Mert-Eren-Karabulut/ECW7220-HardwareInfo/Hardware/BOM/ECW7220BOM.xls

quantity | descrip | location | vendor_no | vendor_partno
0 | R01 SCHEMATIC FILE EAP1028B-FLF-ZZ
0 | R01 SCHEMATIC FILE EAP1028B-FLF-ZZ 5G MODULE
0 | R02 SCHEMATIC FILE EAP1028B-FLF-ZZ 2G MODULE
1 | *??CONFIG EAP1028B-0316-EC
1 | ANT-1 2.4GHz PCB+CABLE MHF 5dBi RED 35.1X8.1+105mm LYNWAVE |  | LYNWAVE TECHNOLOGY LTD | ALA130-051023-105035
1 | ANT-2 2.4GHz PCB+CABLE MHF 5dBi ORG 35.1X8.1+110mm LYNWAVE |  | LYNWAVE TECHNOLOGY LTD | ALA130-051023-110037
1 | ANT-3 2.4GHz PCB+CABLE MHF 4dBi BLACK 35.1X8.1+220mm LYNWAVE |  | LYNWAVE TECHNOLOGY LTD | ALA130-051023-220030
1 | ANT-6 5GHz PCB+CABLE MHF 5dBi BLUE 22.6X6+90mm 1.37 LYNWAVE |  | LYNWAVE TECHNOLOGY LTD | ALA120-091025-090033
1 | ANT-5 5GHz PCB+CABLE MHF 5.77dBi GREEN 22.6X6+100mm LYNWAVE |  | LYNWAVE TECHNOLOGY LTD | ALA120-091025-100038
1 | ANT-4 5GHz PCB+CABLE MHF 5.72dBi GRAY 22.6X6+225mm LYNWAVE |  | LYNWAVE TECHNOLOGY LTD | ALA120-091025-225031
1 | R02 PLASTIC BASE EAP1028B-12-0115-38 LT |  | TUNG SHI | PLASTIC BASE 200X200X26.8mm
1 | R02 PLASTIC BASE EAP1028B-12-0115-38 LT |  | TUNG SHI | PLASTIC BASE 200X200X26.8mm
1 | R02 PLASTIC COVER EAP1028B-FLF-ZZ LT |  | TUNG SHI | PLASTIC COVER 200X200X18mm
1 | R01 HEAT SINK PCB 160X110X6.0mm EAP1028B-25-0714-EC LT |  | TIMSON | HEAT SINK PCB 160X110X6.0mm
1 | R01 HEAT SINK COVER Φ100Xt2.0mm EAP1028B-25-0714-EC LT |  | TIMSON | HEAT-SINK-COVER Φ100Xt2.0mm
1 | R01 HEAT SINK SHIELDING 75X37X4mm EAP1028B-25-0714-EC LT |  | TIMSON | HEAT SINK SHIELDING 75X37X4mm
6 | R01 SCREW FHMS+N M3X5-D5 LT |  | BIFU/QUANYING | FHMS+N M3X5-D5
6 | R01 SCREW FHMS+N M3X5-D5 LT |  | TUNG SHING SCREW MANUFACTURING CO., | FHMS+N M3X5-D5
6 | R01 SCREW FHMS+N M3X5-D5 LT |  | BIFU/QUANYING | FHMS+N M3X5-D5
6 | R01 SCREW FHMS+N M3X5-D5 LT |  | TUNG SHING SCREW MANUFACTURING CO., | FHMS+N M3X5-D5
6 | R01 SCREW FHMS+N M3X5-D5 LT |  | BIFU/QUANYING | FHMS+N M3X5-D5
6 | R01 SCREW FHMS+N M3X5-D5 LT |  | TUNG SHING SCREW MANUFACTURING CO., | FHMS+N M3X5-D5
6 | R01 SCREW FHMS+N M3X5-D5 LT |  | BIFU/QUANYING | FHMS+N M3X5-D5
6 | R01 SCREW FHMS+N M3X5-D5 LT |  | TUNG SHING SCREW MANUFACTURING CO., | FHMS+N M3X5-D5
6 | R01 SCREW FHMS+N M3X5-D5 LT |  | BIFU/QUANYING | FHMS+N M3X5-D5
6 | R01 SCREW FHMS+N M3X5-D5 LT |  | TUNG SHING SCREW MANUFACTURING CO., | FHMS+N M3X5-D5
6 | R01 SCREW FHMS+N M3X5-D5 LT |  | BIFU/QUANYING | FHMS+N M3X5-D5
6 | R01 SCREW FHMS+N M3X5-D5 LT |  | TUNG SHING SCREW MANUFACTURING CO., | FHMS+N M3X5-D5
6 | R01 SCREW FHMS+N M3X5-D5 LT |  | BIFU/QUANYING | FHMS+N M3X5-D5
6 | R01 SCREW FHMS+N M3X5-D5 LT |  | TUNG SHING SCREW MANUFACTURING CO., | FHMS+N M3X5-D5
4 | R02 SCREW PH MS NI NYLOK M2.5X4mm EAP1018FA-FLF-09J E LT |  | BIFU/QUANYING | PH MS NICKEL M2.5X4mm
4 | R02 SCREW PH MS NI NYLOK M2.5X4mm EAP1018FA-FLF-09J E LT |  | BIFU/QUANYING | PH MS NICKEL M2.5X4mm
5 | R01 pH MST+FS⊕CN 3X8-D7 LT |  | BIFU/QUANYING | PH MST+FS+CN 3*8-D7
5 | R01 pH MST+FS⊕CN 3X8-D7 LT |  | Screwtek | PH MST+FS+CN 3*8-D7
5 | R01 pH MST+FS⊕CN 3X8-D7 LT |  | BIFU/QUANYING | PH MST+FS+CN 3*8-D7
5 | R01 pH MST+FS⊕CN 3X8-D7 LT |  | Screwtek | PH MST+FS+CN 3*8-D7
5 | R01 pH MST+FS⊕CN 3X8-D7 LT |  | BIFU/QUANYING | PH MST+FS+CN 3*8-D7
5 | R01 pH MST+FS⊕CN 3X8-D7 LT |  | Screwtek | PH MST+FS+CN 3*8-D7
2 | R01 WIRE SADDLE CHF-4A-NQW EAP9112A-FLF-17(WAP5110-E) LT |  | PINGOOD | CHF-4A-NQW
1 | R01 THERMAL PAD TG6050 80X40X2.0mm EAP1028B-25-0714-EC LT |  | T-GLOBAL TECHNOLOGY CO., LTD | TG6050-800400020-0-1
1 | R01 THERMAL PAD TG2030 80X40X2.0mm EAP1028B-12-0115-38 LT |  | T-GLOBAL TECHNOLOGY CO., LTD | TG2030-800400020-0-1
2 | R01 THERMAL PAD H48-6 25.8X21.6X3.5mm EAP1028B-25-0714-EC LT |  | T-GLOBAL TECHNOLOGY CO., LTD | H48-6-25802160350-0-1
1 | R01 THERMAL PAD H48-6 40X33.0X2.8mm EAP1028B-25-0714-EC LT |  | T-GLOBAL TECHNOLOGY CO., LTD | H48-6-400330280-0-1
1 | R01 THERMAL PAD H48-6 25X20X4.5mm EAP1028B-25-0714-EC LT |  | T-GLOBAL TECHNOLOGY CO., LTD | H48-6-250200450-0-1
1 | R01 THERMAL PAD H48-6 29X28X2.8mm EAP1028B-25-0714-EC LT |  | T-GLOBAL TECHNOLOGY CO., LTD | H48-6-290280280-0-1
2 | R01 SPONG 27X13X3mm EAP1028B-FLF-ZZ LT |  | NEO-APEX \ EASTERN PIONEER | SPONG 27X13X3mm
0 | RNA TEST PROGRAM EAP1028B-0316-EC
1 | R01 ACCLABEL 51X13MM(珍珠朧) LT |  | TRIM | 51*13MM R01
1 | R01 ACCLABEL 51X13MM(珍珠朧) LT |  | TRIM | 51*13MM R01
1 | PCBA EAP1028B-12-0115-38 2G MODULE
1 | SMD ASM EAP1028B-12-0115-38 2G MODULE
1 | IND PWR SHD 1uH 20% 1MHz 2.2A 0.1365ohm 2.5X2 MAGIC | L4 | MAGIC | WQPIG2512L-1R0M
1 | IND PWR SHD 1uH 20% 1MHz 2.2A 0.1365ohm 2.5X2 MAGIC | L4 | MAGIC | WQPIG2512L-1R0M
3 | *RF IC SE2594L-R PA 3.3V QFN32 SIGE | U10, U11, U12 | SKYWORKS | SE2594L-R
3 | *RF IC SE2594L-R PA 3.3V QFN32 SIGE | U10, U11, U12 | SKYWORKS | SE2594L-R
3 | *RF IC SE2594L-R PA 3.3V QFN32 SIGE | U10, U11, U12 | SKYWORKS | SE2594L-R
3 | *RF IC SE2594L-R PA 3.3V QFN32 SIGE | U10, U11, U12 | SKYWORKS | SE2594L-R
3 | *RF IC SE2594L-R PA 3.3V QFN32 SIGE | U10, U11, U12 | SKYWORKS | SE2594L-R
3 | *RF IC SE2594L-R PA 3.3V QFN32 SIGE | U10, U11, U12 | SKYWORKS | SE2594L-R
3 | *RF IC SE2594L-R PA 3.3V QFN32 SIGE | U10, U11, U12 | SKYWORKS | SE2594L-R
1 | RF IC BCM43431KMLG 1.2V QFN100 BROADCOM(ZZ) | U1 | BROADCOM | BCM43431KMLG
1 | RF IC BCM43431KMLG 1.2V QFN100 BROADCOM(ZZ) | U1 | BROADCOM | BCM43431KMLG
1 | RF IC BCM43431KMLG 1.2V QFN100 BROADCOM(ZZ) | U1 | BROADCOM | BCM43431KMLG
1 | RF IC BCM43431KMLG 1.2V QFN100 BROADCOM(ZZ) | U1 | BROADCOM | BCM43431KMLG
1 | X'TAL 20MHz +-7ppm 16pF 35ohm SMD3.2X2.5mm TXC | Y1 | TXC CORPORATION | 7M20070002
1 | X'TAL 20MHz +-7ppm 16pF 35ohm SMD3.2X2.5mm TXC | Y1 | TXC CORPORATION | 7M20070002
1 | REG SYNC BUCK MP2130DG-LF-Z ADJ 3.5A QFN12 MPS | U14 | MPS | MP2130DG-LF-Z
3 | CONN RF RP U.FL-JACK H1.25 180F 50ohm 6GHz 5u SMD3 SPECON | J0, J1, J2 | SPECON ELECRTONICS INC | W08-5801-002-00-810
3 | CONN RF U.FL H1.25 180M 50ohm 6GHz SMD3 HRS | J0, J1, J2 | HIROSE | U.FL-R-SMT-1(10)
3 | CONN RF U.FL H1.25 180M 50ohm 6GHz SMD3 HRS | J0, J1, J2 | HIROSE | U.FL-R-SMT-1(10)
3 | CONN RF U.FL H1.25 180M 50ohm 6GHz SMD3 HRS | J0, J1, J2 | HIROSE | U.FL-R-SMT-1(10)
3 | CONN RF U.FL H1.25 180M 50ohm 6GHz SMD3 HRS | J0, J1, J2 | HIROSE | U.FL-R-SMT-1(10)
3 | CONN RF U.FL H1.25 180M 50ohm 6GHz SMD3 HRS | J0, J1, J2 | HIROSE | U.FL-R-SMT-1(10)
3 | CONN RF U.FL H1.25 180M 50ohm 6GHz SMD3 HRS | J0, J1, J2 | HIROSE | U.FL-R-SMT-1(10)
3 | CONN RF U.FL H1.25 180M 50ohm 6GHz SMD3 HRS | J0, J1, J2 | HIROSE | U.FL-R-SMT-1(10)
3 | CONN RF U.FL H1.25 180M 50ohm 6GHz SMD3 HRS | J0, J1, J2 | HIROSE | U.FL-R-SMT-1(10)
3 | CONN RF U.FL H1.25 180M 50ohm 6GHz SMD3 HRS | J0, J1, J2 | HIROSE | U.FL-R-SMT-1(10)
3 | CONN RF U.FL H1.25 180M 50ohm 6GHz SMD3 HRS | J0, J1, J2 | HIROSE | U.FL-R-SMT-1(10)
1 | R01 SHIELD FRAME 2.4G 27.75X29.08X2.1mm EAP1018FB-FLF-MK LT | X1 | CHI GI | SHIELD FRAME 2.4G 27.75X29.08X2.1mm
1 | R01 SHIELD FRAME 2.4G 27.75X29.08X2.1mm EAP1018FB-FLF-MK LT | X1 | CHI GI | SHIELD FRAME 2.4G 27.75X29.08X2.1mm
1 | R01 SHIELD FRAME 2.4G 27.75X29.08X2.1mm EAP1018FB-FLF-MK LT | X1 | CHI GI | SHIELD FRAME 2.4G 27.75X29.08X2.1mm
1 | R01 SHIELD FRAME 2.4G 27.75X29.08X2.1mm EAP1018FB-FLF-MK LT | X1 | CHI GI | SHIELD FRAME 2.4G 27.75X29.08X2.1mm
1 | R02 PCB 4L EAP1028B-FLF-ZZ 2G MODULE |  | HI TEC | 142000000969A
1 | R02 PCB 4L EAP1028B-FLF-ZZ 2G MODULE |  | HI TEC | 142000000969A
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
1 | RES SMD 221ohm 1% 1/20W 200ppm/℃ 0201 | R12 | WAL SIN | WR02X2210FAL
1 | RES SMD 221ohm 1% 1/20W 200ppm/℃ 0201 | R12 | YAGEO | RC0201FR-07221RL
1 | RES SMD 15Kohm 1% 1/20W 200ppm/℃ 0201 | R50 | WAL SIN | WR02X1502FAL
1 | RES SMD 15Kohm 1% 1/20W 200ppm/℃ 0201 | R50 | YAGEO | RC0201FR-0715KL
1 | RES SMD 15Kohm 1% 1/20W 200ppm/℃ 0201 | R50 | WAL SIN | WR02X1502FAL
1 | RES SMD 15Kohm 1% 1/20W 200ppm/℃ 0201 | R50 | YAGEO | RC0201FR-0715KL
1 | RES SMD 15Kohm 1% 1/20W 200ppm/℃ 0201 | R50 | WAL SIN | WR02X1502FAL
1 | RES SMD 15Kohm 1% 1/20W 200ppm/℃ 0201 | R50 | YAGEO | RC0201FR-0715KL
1 | RES SMD 196Kohm 1% 1/20W 200ppm/℃ 0201 | R119 | WAL SIN | WR02X1963FAL
1 | RES SMD 196Kohm 1% 1/20W 200ppm/℃ 0201 | R119 | YAGEO | RC0201FR-07196KL
1 | RES SMD 196Kohm 1% 1/20W 200ppm/℃ 0201 | R119 | WAL SIN | WR02X1963FAL
1 | RES SMD 196Kohm 1% 1/20W 200ppm/℃ 0201 | R119 | YAGEO | RC0201FR-07196KL
1 | C SMD CER 3300pF 10% 6.3V X7R 0201 T0.3mm | C146 | WAL SIN | 0201B332K6R3CT
1 | C SMD CER 3300pF 10% 6.3V X7R 0201 T0.3mm | C146 | YAGEO | CC0201KRX7R5BB332
1 | C SMD CER 3300pF 10% 6.3V X7R 0201 T0.3mm | C146 | WAL SIN | 0201B332K6R3CT
1 | C SMD CER 3300pF 10% 6.3V X7R 0201 T0.3mm | C146 | YAGEO | CC0201KRX7R5BB332
3 | C SMD CER 0.068uF 10% 6.3V X5R 0201 T0.3mm | C222, C223, C224 | WAL SIN | 0201X683K6R3CT
3 | C SMD CER 0.068uF 10% 6.3V X5R 0201 T0.3mm | C222, C223, C224 | YAGEO | CC0201KRX5R5BB683
3 | C SMD CER 180pF 10% 16V X7R 0201 T0.3mm LT/LF | C211, C212, C213 | WAL SIN | 0201B181K160CT
3 | C SMD CER 180pF 10% 16V X7R 0201 T0.3mm LT/LF | C211, C212, C213 | YAGEO | CC0201KRX7R7BB181
3 | C SMD CER 180pF 10% 16V X7R 0201 T0.3mm LT/LF | C211, C212, C213 | WAL SIN | 0201B181K160CT
3 | C SMD CER 180pF 10% 16V X7R 0201 T0.3mm LT/LF | C211, C212, C213 | YAGEO | CC0201KRX7R7BB181
6 | C SMD CER 100pF 5% 25V NPO 0201 T0.3mm | C55, C69, C138, C142, C143, C198 | WAL SIN | 0201N101J250LT
6 | C SMD CER 100pF 5% 25V NPO 0201 T0.3mm | C55, C69, C138, C142, C143, C198 | YAGEO | 223891811536
6 | C SMD CER 100pF 5% 25V NPO 0201 T0.3mm | C55, C69, C138, C142, C143, C198 | WAL SIN | 0201N101J250LT
6 | C SMD CER 100pF 5% 25V NPO 0201 T0.3mm | C55, C69, C138, C142, C143, C198 | YAGEO | 223891811536
6 | C SMD CER 100pF 5% 25V NPO 0201 T0.3mm | C55, C69, C138, C142, C143, C198 | WAL SIN | 0201N101J250LT
6 | C SMD CER 100pF 5% 25V NPO 0201 T0.3mm | C55, C69, C138, C142, C143, C198 | YAGEO | 223891811536
6 | C SMD CER 100pF 5% 25V NPO 0201 T0.3mm | C55, C69, C138, C142, C143, C198 | WAL SIN | 0201N101J250LT
6 | C SMD CER 100pF 5% 25V NPO 0201 T0.3mm | C55, C69, C138, C142, C143, C198 | YAGEO | 223891811536
6 | C SMD CER 100pF 5% 25V NPO 0201 T0.3mm | C55, C69, C138, C142, C143, C198 | WAL SIN | 0201N101J250LT
6 | C SMD CER 100pF 5% 25V NPO 0201 T0.3mm | C55, C69, C138, C142, C143, C198 | YAGEO | 223891811536
13 | C SMD CER 1000pF 10% 25V X7R 0201 T0.3mm | C64, C65, C66, C67, C68, C70, C71, C87, C90, C91, C239, C240, C241 | PHYCOMP | 223891815623
13 | C SMD CER 1000pF 10% 25V X7R 0201 T0.3mm | C64, C65, C66, C67, C68, C70, C71, C87, C90, C91, C239, C240, C241 | WAL SIN | 0201B102K250LT
13 | C SMD CER 1000pF 10% 25V X7R 0201 T0.3mm | C64, C65, C66, C67, C68, C70, C71, C87, C90, C91, C239, C240, C241 | PHYCOMP | 223891815623
13 | C SMD CER 1000pF 10% 25V X7R 0201 T0.3mm | C64, C65, C66, C67, C68, C70, C71, C87, C90, C91, C239, C240, C241 | WAL SIN | 0201B102K250LT
13 | C SMD CER 1000pF 10% 25V X7R 0201 T0.3mm | C64, C65, C66, C67, C68, C70, C71, C87, C90, C91, C239, C240, C241 | PHYCOMP | 223891815623
13 | C SMD CER 1000pF 10% 25V X7R 0201 T0.3mm | C64, C65, C66, C67, C68, C70, C71, C87, C90, C91, C239, C240, C241 | WAL SIN | 0201B102K250LT
13 | C SMD CER 1000pF 10% 25V X7R 0201 T0.3mm | C64, C65, C66, C67, C68, C70, C71, C87, C90, C91, C239, C240, C241 | PHYCOMP | 223891815623
13 | C SMD CER 1000pF 10% 25V X7R 0201 T0.3mm | C64, C65, C66, C67, C68, C70, C71, C87, C90, C91, C239, C240, C241 | WAL SIN | 0201B102K250LT
13 | C SMD CER 1000pF 10% 25V X7R 0201 T0.3mm | C64, C65, C66, C67, C68, C70, C71, C87, C90, C91, C239, C240, C241 | PHYCOMP | 223891815623
13 | C SMD CER 1000pF 10% 25V X7R 0201 T0.3mm | C64, C65, C66, C67, C68, C70, C71, C87, C90, C91, C239, C240, C241 | WAL SIN | 0201B102K250LT
32 | C SMD CER 0.1uF 10% 6.3V X5R 0201 | C22, C28, C29, C30, C31, C32, C33, C34, C36, C40, C49, C50, C51, C52 | PHYCOMP | 225520813649
 |  | , C60, C61, C62, C63, C97, C99, C100, C105, C106, C191, C192, C197,
 |  | C228, C229, C230, C236, C237, C238
32 | C SMD CER 0.1uF 10% 6.3V X5R 0201 | C22, C28, C29, C30, C31, C32, C33, C34, C36, C40, C49, C50, C51, C52 | WAL SIN | 0201X104K6R3CT
 |  | , C60, C61, C62, C63, C97, C99, C100, C105, C106, C191, C192, C197,
 |  | C228, C229, C230, C236, C237, C238
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
6 | C SMD CER 4.7uF 10% 6.3V X5R 0603 T0.8mm | C119, C121, C225, C226, C227, C248 | PHYCOMP | 225520613672
6 | C SMD CER 4.7uF 10% 6.3V X5R 0603 T0.8mm | C119, C121, C225, C226, C227, C248 | SAMSUNG | CL10A475KQ8NNNC
6 | C SMD CER 4.7uF 10% 6.3V X5R 0603 T0.8mm | C119, C121, C225, C226, C227, C248 | WAL SIN | 0603X475K6R3CT
6 | C SMD CER 4.7uF 10% 6.3V X5R 0603 T0.8mm | C119, C121, C225, C226, C227, C248 | YAGEO | CC0603KRX5R5BB475
6 | C SMD CER 4.7uF 10% 6.3V X5R 0603 T0.8mm | C119, C121, C225, C226, C227, C248 | HEC | C0603B475K007T
6 | C SMD CER 4.7uF 10% 6.3V X5R 0603 T0.8mm | C119, C121, C225, C226, C227, C248 | PHYCOMP | 225520613672
6 | C SMD CER 4.7uF 10% 6.3V X5R 0603 T0.8mm | C119, C121, C225, C226, C227, C248 | SAMSUNG | CL10A475KQ8NNNC
6 | C SMD CER 4.7uF 10% 6.3V X5R 0603 T0.8mm | C119, C121, C225, C226, C227, C248 | WAL SIN | 0603X475K6R3CT
6 | C SMD CER 4.7uF 10% 6.3V X5R 0603 T0.8mm | C119, C121, C225, C226, C227, C248 | YAGEO | CC0603KRX5R5BB475
6 | C SMD CER 4.7uF 10% 6.3V X5R 0603 T0.8mm | C119, C121, C225, C226, C227, C248 | HEC | C0603B475K007T
6 | C SMD CER 4.7uF 10% 6.3V X5R 0603 T0.8mm | C119, C121, C225, C226, C227, C248 | PHYCOMP | 225520613672
6 | C SMD CER 4.7uF 10% 6.3V X5R 0603 T0.8mm | C119, C121, C225, C226, C227, C248 | SAMSUNG | CL10A475KQ8NNNC
6 | C SMD CER 4.7uF 10% 6.3V X5R 0603 T0.8mm | C119, C121, C225, C226, C227, C248 | WAL SIN | 0603X475K6R3CT
6 | C SMD CER 4.7uF 10% 6.3V X5R 0603 T0.8mm | C119, C121, C225, C226, C227, C248 | YAGEO | CC0603KRX5R5BB475
3 | RF C SMD CER 9pF +-0.1pF 25V NPO 0201 T0.3mm WALSIN | C231, C232, C233 | WAL SIN | RF03N9R0B250CT
3 | RF C SMD CER 9pF +-0.1pF 25V NPO 0201 T0.3mm WALSIN | C231, C232, C233 | WAL SIN | RF03N9R0B250CT
3 | RF C SMD CER 9pF +-0.1pF 25V NPO 0201 T0.3mm WALSIN | C231, C232, C233 | WAL SIN | RF03N9R0B250CT
1 | C SMD CER 30pF 5% 25V NPO 0201 T0.3mm MURATA | C17 | MURATA | GRM0335C1E300JA01D
1 | C SMD CER 30pF 5% 25V NPO 0201 T0.3mm MURATA | C17 | MURATA | GRM0335C1E300JA01D
1 | R01 ACCLABEL 26X6mm(耐高溫) LT |  | TRUSTTEK | 26X6mm
1 | F/W ASM EAP1028B-FLF-ZZ 2G MODULE U2 (OFF-LINE) | U2
1 | EEPROM AT93C66B-MAHM-T 4Kb 1.7~5.5V 3WIRE UDFN8 MICROCHIP | U2 | MIROCHIP TECHNOLOGY INC | AT93C66B-MAHM-T
1 | EEPROM AT93C66B-MAHM-T 4Kb 1.7~5.5V 3WIRE UDFN8 MICROCHIP | U2 | MIROCHIP TECHNOLOGY INC | AT93C66B-MAHM-T
1 | EEPROM AT93C66B-MAHM-T 4Kb 1.7~5.5V 3WIRE UDFN8 MICROCHIP | U2 | MIROCHIP TECHNOLOGY INC | AT93C66B-MAHM-T
1 | V1.0 F/W EAP1028B-FLF-ZZ 2G MODULE U2 C.S:22E4 | U2
1 | NON SMD ASM EAP1028B-12-0115-38 2G MODULE
1 | R01 SHIELD COVER RF 2.4G 28.25X29.58X2mm EAP1018FB-FLF-MK LT | X1 | CHI GI | SHIELD COVER RF 2.4G 28.25X29.58X2mm
1 | R01 SHIELD COVER RF 2.4G 28.25X29.58X2mm EAP1018FB-FLF-MK LT | X1 | CHI GI | SHIELD COVER RF 2.4G 28.25X29.58X2mm
1 | R01 SHIELD COVER RF 2.4G 28.25X29.58X2mm EAP1018FB-FLF-MK LT | X1 | CHI GI | SHIELD COVER RF 2.4G 28.25X29.58X2mm
1 | R01 SHIELD COVER RF 2.4G 28.25X29.58X2mm EAP1018FB-FLF-MK LT | X1 | CHI GI | SHIELD COVER RF 2.4G 28.25X29.58X2mm
3 | R01 THERMAL PAD SR-800MT 4X4X1.3mm EAP1018FB-FLF-MK LT |  | WHAYUEB/M-VICTORY | SR-800MT 3-1300-002
1 | R01 THERMAL PAD TBN-060 10X10X1.5mm EAP1018FB-FLF-MK LT |  | CHENG RUENN TECH | TBNb-060-150.010.010
1 | R01 ACCLABEL 23X4mm LT |  | HUASHAN | 23X4
1 | R01 ACCLABEL 23X4mm LT |  | TRIM | 23X4
1 | R01 ACCLABEL 23X4mm LT |  | HUASHAN | 23X4
1 | R01 ACCLABEL 23X4mm LT |  | TRIM | 23X4
1 | R01 ACCLABEL 23X4mm LT |  | HUASHAN | 23X4
1 | R01 ACCLABEL 23X4mm LT |  | TRIM | 23X4
1 | R01 ACCLABEL 23X4mm LT |  | HUASHAN | 23X4
1 | R01 ACCLABEL 23X4mm LT |  | TRIM | 23X4
1 | R01 ACCLABEL 23X4mm LT |  | HUASHAN | 23X4
1 | R01 ACCLABEL 23X4mm LT |  | TRIM | 23X4
1 | R01 ACCLABEL 23X4mm LT |  | HUASHAN | 23X4
1 | R01 ACCLABEL 23X4mm LT |  | TRIM | 23X4
1 | PCBA EAP1028B-25-0714-EC 5G MODULE
1 | SMD ASM EAP1028B-25-0714-EC 5G MODULE
3 | IND FILM CHIP 1.3nH +-0.1nH 500MHz 300mA 0.3ohm 0201 VIKING | L3, L5, L6 | VIKING TECH | AL01BT1N3M
1 | *IND PWR SHD 1uH 20% 1MHz 2.2A 0.1365ohm 2.5X2X1.2 3L | L10 | 3L ELECTRONIC CORPORATION | SNR2512E-1R0M
1 | *IND PWR SHD 1uH 20% 1MHz 2.2A 0.1365ohm 2.5X2X1.2 3L | L10 | 3L ELECTRONIC CORPORATION | SNR2512E-1R0M
1 | *IND PWR SHD 1uH 20% 1MHz 2.2A 0.1365ohm 2.5X2X1.2 3L | L10 | 3L ELECTRONIC CORPORATION | SNR2512E-1R0M
1 | BEAD SMD 100MHz 300ohm 25% 2A 0.1ohm 0603 MAX ECHO | B1 | MAX ECHO | ACMS160808A301 RDC1
1 | BEAD SMD 100MHz 300ohm 25% 2A 0.1ohm 0603 MAX ECHO | B1 | MAX ECHO | ACMS160808A301 RDC1
1 | BEAD SMD 100MHz 300ohm 25% 2A 0.1ohm 0603 MAX ECHO | B1 | MAX ECHO | ACMS160808A301 RDC1
1 | BEAD SMD 100MHz 300ohm 25% 2A 0.1ohm 0603 MAX ECHO | B1 | MAX ECHO | ACMS160808A301 RDC1
2 | BEAD SMD 100MHz 120ohm 25% 500mA 0.25ohm 0402 MAX ECHO | -L11, -L12 | MAX ECHO | EBMS100505A121 0.5A
2 | BEAD SMD 100MHz 120ohm 25% 500mA 0.25ohm 0402 MAX ECHO | -L11, -L12 | MAX ECHO | EBMS100505A121 0.5A
2 | BEAD SMD 100MHz 120ohm 25% 500mA 0.25ohm 0402 MAX ECHO | -L11, -L12 | MAX ECHO | EBMS100505A121 0.5A
2 | BEAD SMD 100MHz 120ohm 25% 500mA 0.25ohm 0402 MAX ECHO | -L11, -L12 | MAX ECHO | EBMS100505A121 0.5A
3 | BEAD SMD 100MHz 10ohm 25% 1A 0.05ohm 0402 MAX ECHO | L7, L8, L9 | MAX ECHO | ACMS100505A100 1A
3 | BEAD SMD 100MHz 10ohm 25% 1A 0.05ohm 0402 MAX ECHO | L7, L8, L9 | MAX ECHO | ACMS100505A100 1A
3 | *FILTER HF 4.9~5.85GHz HF1608-E5R5TAAT/LF 0603-4 ACX | F1, F2, F3 | ACX | HF1608-E5R5TAAT/LF
3 | RF IC RFFM4591FTR7 FEM 5.85GHz 3.3V LGA16 RFMD | U1, U2, U3 | QORVO | RFFM4591FTR7
3 | RF IC RFFM4591FTR7 FEM 5.85GHz 3.3V LGA16 RFMD | U1, U2, U3 | QORVO | RFFM4591FTR7
3 | RF IC RFFM4591FTR7 FEM 5.85GHz 3.3V LGA16 RFMD | U1, U2, U3 | QORVO | RFFM4591FTR7
1 | RF IC BCM43460KMLG 1.2V QFN108 BROADCOM(ZZ) | U4 | BROADCOM | BCM43460KMLG
1 | RF IC BCM43460KMLG 1.2V QFN108 BROADCOM(ZZ) | U4 | BROADCOM | BCM43460KMLG
1 | RF IC BCM43460KMLG 1.2V QFN108 BROADCOM(ZZ) | U4 | BROADCOM | BCM43460KMLG
1 | RF IC BCM43460KMLG 1.2V QFN108 BROADCOM(ZZ) | U4 | BROADCOM | BCM43460KMLG
1 | X'TAL 40MHz +-7ppm 12pF 50ohm SMD2.5X2.0 PSE | Y1 | PSE | FH4000032
1 | X'TAL 40MHz +-7ppm 12pF 50ohm SMD2.5X2.0 PSE | Y1 | PSE | FH4000032
1 | X'TAL 40MHz +-7ppm 12pF 50ohm SMD2.5X2.0 PSE | Y1 | PSE | FH4000032
1 | REG SYNC BUCK MP2130DG-LF-Z ADJ 3.5A QFN12 MPS | U5 | MPS | MP2130DG-LF-Z
3 | CONN RF RP U.FL-JACK H1.25 180F 50ohm 6GHz 5u SMD3 SPECON | CONN1, CONN2, CONN3 | SPECON ELECRTONICS INC | W08-5801-002-00-810
3 | CONN RF U.FL H1.25 180M 50ohm 6GHz SMD3 HRS | CONN1, CONN2, CONN3 | HIROSE | U.FL-R-SMT-1(10)
3 | CONN RF U.FL H1.25 180M 50ohm 6GHz SMD3 HRS | CONN1, CONN2, CONN3 | HIROSE | U.FL-R-SMT-1(10)
3 | CONN RF U.FL H1.25 180M 50ohm 6GHz SMD3 HRS | CONN1, CONN2, CONN3 | HIROSE | U.FL-R-SMT-1(10)
3 | CONN RF U.FL H1.25 180M 50ohm 6GHz SMD3 HRS | CONN1, CONN2, CONN3 | HIROSE | U.FL-R-SMT-1(10)
3 | CONN RF U.FL H1.25 180M 50ohm 6GHz SMD3 HRS | CONN1, CONN2, CONN3 | HIROSE | U.FL-R-SMT-1(10)
3 | CONN RF U.FL H1.25 180M 50ohm 6GHz SMD3 HRS | CONN1, CONN2, CONN3 | HIROSE | U.FL-R-SMT-1(10)
3 | CONN RF U.FL H1.25 180M 50ohm 6GHz SMD3 HRS | CONN1, CONN2, CONN3 | HIROSE | U.FL-R-SMT-1(10)
3 | CONN RF U.FL H1.25 180M 50ohm 6GHz SMD3 HRS | CONN1, CONN2, CONN3 | HIROSE | U.FL-R-SMT-1(10)
3 | CONN RF U.FL H1.25 180M 50ohm 6GHz SMD3 HRS | CONN1, CONN2, CONN3 | HIROSE | U.FL-R-SMT-1(10)
3 | CONN RF U.FL H1.25 180M 50ohm 6GHz SMD3 HRS | CONN1, CONN2, CONN3 | HIROSE | U.FL-R-SMT-1(10)
1 | R01 SHIELD FRAME 39.8X37Xt2.75 EAP1028B-25-0714-EC LT | SF1 | HUN PAI ENTERPRISE CO.,LTD. | E1028-F0004
1 | R01 SHIELD FRAME 39.8X37Xt2.75 EAP1028B-25-0714-EC LT | SF1 | HUN PAI ENTERPRISE CO.,LTD. | E1028-F0004
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
3 | RES SMD 18ohm 1% 1/20W 200ppm/℃ 0201 | R8, R11, R14 | WAL SIN | WR02X18R0FAL
3 | RES SMD 18ohm 1% 1/20W 200ppm/℃ 0201 | R8, R11, R14 | YAGEO | RC0201FR-0718RL
3 | RES SMD 18ohm 1% 1/20W 200ppm/℃ 0201 | R8, R11, R14 | WAL SIN | WR02X18R0FAL
3 | RES SMD 18ohm 1% 1/20W 200ppm/℃ 0201 | R8, R11, R14 | YAGEO | RC0201FR-0718RL
11 | RES SMD 4.7Kohm 5% 1/20W 200ppm/℃ 0201 | R27, R28, R29, R30, R38, R39, R41, -R52, -R53, -R54, -R57 | WAL SIN | WR02X472 JAL
11 | RES SMD 4.7Kohm 5% 1/20W 200ppm/℃ 0201 | R27, R28, R29, R30, R38, R39, R41, -R52, -R53, -R54, -R57 | YAGEO | RC0201JR-074K7L
11 | RES SMD 4.7Kohm 5% 1/20W 200ppm/℃ 0201 | R27, R28, R29, R30, R38, R39, R41, -R52, -R53, -R54, -R57 | WAL SIN | WR02X472 JAL
11 | RES SMD 4.7Kohm 5% 1/20W 200ppm/℃ 0201 | R27, R28, R29, R30, R38, R39, R41, -R52, -R53, -R54, -R57 | YAGEO | RC0201JR-074K7L
11 | RES SMD 4.7Kohm 5% 1/20W 200ppm/℃ 0201 | R27, R28, R29, R30, R38, R39, R41, -R52, -R53, -R54, -R57 | WAL SIN | WR02X472 JAL
11 | RES SMD 4.7Kohm 5% 1/20W 200ppm/℃ 0201 | R27, R28, R29, R30, R38, R39, R41, -R52, -R53, -R54, -R57 | YAGEO | RC0201JR-074K7L
1 | RES SMD 196Kohm 1% 1/20W 200ppm/℃ 0201 | R31 | WAL SIN | WR02X1963FAL
1 | RES SMD 196Kohm 1% 1/20W 200ppm/℃ 0201 | R31 | YAGEO | RC0201FR-07196KL
1 | RES SMD 196Kohm 1% 1/20W 200ppm/℃ 0201 | R31 | WAL SIN | WR02X1963FAL
1 | RES SMD 196Kohm 1% 1/20W 200ppm/℃ 0201 | R31 | YAGEO | RC0201FR-07196KL
14 | C SMD CER 1uF 20% 6.3V X5R 0201 T0.3mm | C8, C26, C28, C66, C70, C72, C88, C101, -C141, -C143, -C146, -C158, | TAIYO | JMK063ABJ105MP-F
 |  | -C170, -C174
14 | C SMD CER 1uF 20% 6.3V X5R 0201 T0.3mm | C8, C26, C28, C66, C70, C72, C88, C101, -C141, -C143, -C146, -C158, | YAGEO | CC0201MRX5R5BB105
 |  | -C170, -C174
14 | C SMD CER 1uF 20% 6.3V X5R 0201 T0.3mm | C8, C26, C28, C66, C70, C72, C88, C101, -C141, -C143, -C146, -C158, | TAIYO | JMK063ABJ105MP-F
 |  | -C170, -C174
14 | C SMD CER 1uF 20% 6.3V X5R 0201 T0.3mm | C8, C26, C28, C66, C70, C72, C88, C101, -C141, -C143, -C146, -C158, | YAGEO | CC0201MRX5R5BB105
 |  | -C170, -C174
14 | C SMD CER 1uF 20% 6.3V X5R 0201 T0.3mm | C8, C26, C28, C66, C70, C72, C88, C101, -C141, -C143, -C146, -C158, | TAIYO | JMK063ABJ105MP-F
 |  | -C170, -C174
14 | C SMD CER 1uF 20% 6.3V X5R 0201 T0.3mm | C8, C26, C28, C66, C70, C72, C88, C101, -C141, -C143, -C146, -C158, | YAGEO | CC0201MRX5R5BB105
 |  | -C170, -C174
14 | C SMD CER 1uF 20% 6.3V X5R 0201 T0.3mm | C8, C26, C28, C66, C70, C72, C88, C101, -C141, -C143, -C146, -C158, | TAIYO | JMK063ABJ105MP-F
 |  | -C170, -C174
14 | C SMD CER 1uF 20% 6.3V X5R 0201 T0.3mm | C8, C26, C28, C66, C70, C72, C88, C101, -C141, -C143, -C146, -C158, | YAGEO | CC0201MRX5R5BB105
 |  | -C170, -C174
1 | C SMD CER 330pF 5% 50V X7R 0201 T0.3mm | -C140 | WAL SIN | 0201B331J500CT
2 | C SMD CER 18pF 2% 25V NPO 0201 T0.3mm | C80, C86 | WAL SIN | 0201N180G250LT
2 | C SMD CER 18pF 2% 25V NPO 0201 T0.3mm | C80, C86 | YAGEO | CC0201GRNPO8BN180
2 | C SMD CER 18pF 2% 25V NPO 0201 T0.3mm | C80, C86 | WAL SIN | 0201N180G250LT
2 | C SMD CER 18pF 2% 25V NPO 0201 T0.3mm | C80, C86 | YAGEO | CC0201GRNPO8BN180
5 | C SMD CER 10uF 20% 6.3V X5R 0402 T0.5mm | C1, C15, C16, C103, -C144 | SAMSUNG | CL05A106MQ5NUNC
5 | C SMD CER 10uF 20% 6.3V X5R 0402 T0.5mm | C1, C15, C16, C103, -C144 | TAIYO | JMK105CBJ106MV-F
5 | C SMD CER 10uF 20% 6.3V X5R 0402 T0.5mm | C1, C15, C16, C103, -C144 | WAL SIN | 0402X106M6R3CT
5 | C SMD CER 10uF 20% 6.3V X5R 0402 T0.5mm | C1, C15, C16, C103, -C144 | SAMSUNG | CL05A106MQ5NUNC
5 | C SMD CER 10uF 20% 6.3V X5R 0402 T0.5mm | C1, C15, C16, C103, -C144 | TAIYO | JMK105CBJ106MV-F
5 | C SMD CER 10uF 20% 6.3V X5R 0402 T0.5mm | C1, C15, C16, C103, -C144 | WAL SIN | 0402X106M6R3CT
5 | C SMD CER 10uF 20% 6.3V X5R 0402 T0.5mm | C1, C15, C16, C103, -C144 | SAMSUNG | CL05A106MQ5NUNC
5 | C SMD CER 10uF 20% 6.3V X5R 0402 T0.5mm | C1, C15, C16, C103, -C144 | TAIYO | JMK105CBJ106MV-F
5 | C SMD CER 10uF 20% 6.3V X5R 0402 T0.5mm | C1, C15, C16, C103, -C144 | WAL SIN | 0402X106M6R3CT
5 | C SMD CER 10uF 20% 6.3V X5R 0402 T0.5mm | C1, C15, C16, C103, -C144 | SAMSUNG | CL05A106MQ5NUNC
5 | C SMD CER 10uF 20% 6.3V X5R 0402 T0.5mm | C1, C15, C16, C103, -C144 | TAIYO | JMK105CBJ106MV-F
5 | C SMD CER 10uF 20% 6.3V X5R 0402 T0.5mm | C1, C15, C16, C103, -C144 | WAL SIN | 0402X106M6R3CT
5 | C SMD CER 10uF 20% 6.3V X5R 0402 T0.5mm | C1, C15, C16, C103, -C144 | SAMSUNG | CL05A106MQ5NUNC
5 | C SMD CER 10uF 20% 6.3V X5R 0402 T0.5mm | C1, C15, C16, C103, -C144 | TAIYO | JMK105CBJ106MV-F
5 | C SMD CER 10uF 20% 6.3V X5R 0402 T0.5mm | C1, C15, C16, C103, -C144 | WAL SIN | 0402X106M6R3CT
5 | C SMD CER 10uF 20% 6.3V X5R 0402 T0.5mm | C1, C15, C16, C103, -C144 | SAMSUNG | CL05A106MQ5NUNC
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
3 | RF C SMD CER 0.2pF +-0.1pF 25V NPO 0201 T0.3mm WALSIN | C53, C56, C57 | WAL SIN | RF03N0R2B250CT
3 | RF C SMD CER 0.2pF +-0.1pF 25V NPO 0201 T0.3mm WALSIN | C53, C56, C57 | WAL SIN | RF03N0R2B250CT
3 | RF C SMD CER 0.2pF +-0.1pF 25V NPO 0201 T0.3mm WALSIN | C53, C56, C57 | WAL SIN | RF03N0R2B250CT
3 | RF C SMD CER 0.3pF +-0.1pF 25V NPO 0201 T0.3mm LT/LF WALSIN | C58, C59, C60 | WAL SIN | RF03N0R3B250CT
3 | RF C SMD CER 0.3pF +-0.1pF 25V NPO 0201 T0.3mm LT/LF WALSIN | C58, C59, C60 | WAL SIN | RF03N0R3B250CT
3 | RF C SMD CER 0.3pF +-0.1pF 25V NPO 0201 T0.3mm LT/LF WALSIN | C58, C59, C60 | WAL SIN | RF03N0R3B250CT
15 | RF C SMD CER 10pF 5% 25V NPO 0201 T0.3mm LT/LF WALSIN | C5, C9, C10, C12, C13, C14, C19, C24, C29, C32, C34, C35, C73, C78, | WAL SIN | RF03N100J250CT
 |  | -C142
15 | RF C SMD CER 10pF 5% 25V NPO 0201 T0.3mm LT/LF WALSIN | C5, C9, C10, C12, C13, C14, C19, C24, C29, C32, C34, C35, C73, C78, | WAL SIN | RF03N100J250CT
 |  | -C142
15 | RF C SMD CER 10pF 5% 25V NPO 0201 T0.3mm LT/LF WALSIN | C5, C9, C10, C12, C13, C14, C19, C24, C29, C32, C34, C35, C73, C78, | WAL SIN | RF03N100J250CT
 |  | -C142
1 | R01 ACCLABEL 26X6mm(耐高溫) LT |  | TRUSTTEK | 26X6mm
1 | F/W ASM EAP1028B-FLF-ZZ 5G MODULE U6 (OFF-LINE) | U6
1 | EEPROM AT93C66B-MAHM-T 4Kb 1.7~5.5V 3WIRE UDFN8 MICROCHIP | U6 | MIROCHIP TECHNOLOGY INC | AT93C66B-MAHM-T
1 | EEPROM AT93C66B-MAHM-T 4Kb 1.7~5.5V 3WIRE UDFN8 MICROCHIP | U6 | MIROCHIP TECHNOLOGY INC | AT93C66B-MAHM-T
1 | EEPROM AT93C66B-MAHM-T 4Kb 1.7~5.5V 3WIRE UDFN8 MICROCHIP | U6 | MIROCHIP TECHNOLOGY INC | AT93C66B-MAHM-T
1 | V1.0 F/W EAP1028B-FLF-ZZ 5G MODULE U6 C.S:EB63
1 | NON SMD ASM EAP1028B-25-0714-EC 5G MODULE
1 | R01A SHIELD COVER EAP9018FA-FLF-09J PCI 5G Mid LT |  | HUN PAI ENTERPRISE CO.,LTD. | 40.2X37,4X2.3mm
1 | R01A SHIELD COVER EAP9018FA-FLF-09J PCI 5G Mid LT |  | HUN PAI ENTERPRISE CO.,LTD. | 40.2X37,4X2.3mm
1 | R01 THERMAL PAD 10X10X2mm EAP9012A-FLF-D8 LT |  | CHENG RUENN TECH | 10X10X2mm
1 | *??PCBA EAP1028B-0316-EC MAIN
1 | *??SMD ASM EAP1028B-0316-EC MAIN
1 | IND PWR MOD 4.7uH 20% 100KHz 5.5A 37mohm 7.8X7.0 3L | L8 | 3L ELECTRONIC CORPORATION | UPIA0603-4R7M
1 | IND PWR MOD 4.7uH 20% 100KHz 5.5A 37mohm 7.8X7.0 3L | L8 | 3L ELECTRONIC CORPORATION | UPIA0603-4R7M
1 | *IND PWR SHD 10uH 20% 100KHz 0.75A 205ohm 3.8X3.8 3L | L15 | 3L ELECTRONIC CORPORATION | BDE3D18-100M
1 | *IND PWR SHD 10uH 20% 100KHz 0.75A 205ohm 3.8X3.8 3L | L15 | 3L ELECTRONIC CORPORATION | BDE3D18-100M
3 | IND PWR MOD 4.7uH 20% 100KHz 5.5A 40mohm 7.3X6.8 MAGIC | L21, L61, L65 | MAGIC | WSRPG0603-4R7M-L
3 | IND PWR MOD 4.7uH 20% 100KHz 5.5A 40mohm 7.3X6.8 MAGIC | L21, L61, L65 | MAGIC | WSRPG0603-4R7M-L
2 | IND PWR MOD 3.3uH 20% 100KHz 7A 7.05X6.6X4.8 CYNTEC(09J) | L13, L14 | CYNTEC | PIMB065T-3R3MS
2 | IND PWR MOD 3.3uH 20% 100KHz 7A 7.05X6.6X4.8 CYNTEC(09J) | L13, L14 | CYNTEC | PIMB065T-3R3MS
1 | 9*IND SMD 22nH 5% 600mA 0603 TOKO | -L40 | TOKO | LL1608-FSL22NJ
1 | 9*IND SMD 22nH 5% 600mA 0603 TOKO | -L40 | TOKO | LL1608-FSL22NJ
4 | BEAD SMD 100MHz 220ohm 25% 2A 0.08ohm 0603 MAX ECHO | -L26, -L27, -L28, -L29 | MAX ECHO | ACMS160808A221 2A
4 | BEAD SMD 100MHz 220ohm 25% 2A 0.08ohm 0603 MAX ECHO | -L26, -L27, -L28, -L29 | MAX ECHO | ACMS160808A221 2A
4 | BEAD SMD 100MHz 220ohm 25% 2A 0.08ohm 0603 MAX ECHO | -L26, -L27, -L28, -L29 | MAX ECHO | ACMS160808A221 2A
4 | BEAD SMD 100MHz 220ohm 25% 2A 0.08ohm 0603 MAX ECHO | -L26, -L27, -L28, -L29 | MAX ECHO | ACMS160808A221 2A
4 | BEAD SMD 100MHz 220ohm 25% 2A 0.08ohm 0603 MAX ECHO | -L26, -L27, -L28, -L29 | MAX ECHO | ACMS160808A221 2A
4 | BEAD SMD 100MHz 220ohm 25% 2A 0.08ohm 0603 MAX ECHO | -L26, -L27, -L28, -L29 | MAX ECHO | ACMS160808A221 2A
4 | BEAD SMD 100MHz 220ohm 25% 2A 0.08ohm 0603 MAX ECHO | -L26, -L27, -L28, -L29 | MAX ECHO | ACMS160808A221 2A
5 | BEAD SMD 100MHz 600ohm 25% 1A 0.2ohm 0603 MAX ECHO | -L33, -L34, -L35, -L36, -L46 | MAX ECHO | ACMS160808A601 RDC2
5 | BEAD SMD 100MHz 600ohm 25% 1A 0.2ohm 0603 MAX ECHO | -L33, -L34, -L35, -L36, -L46 | MAX ECHO | ACMS160808A601 RDC2
5 | BEAD SMD 100MHz 600ohm 25% 1A 0.2ohm 0603 MAX ECHO | -L33, -L34, -L35, -L36, -L46 | MAX ECHO | ACMS160808A601 RDC2
5 | BEAD SMD 100MHz 600ohm 25% 1A 0.2ohm 0603 MAX ECHO | -L33, -L34, -L35, -L36, -L46 | MAX ECHO | ACMS160808A601 RDC2
5 | BEAD SMD 100MHz 600ohm 25% 1A 0.2ohm 0603 MAX ECHO | -L33, -L34, -L35, -L36, -L46 | MAX ECHO | ACMS160808A601 RDC2
1 | BEAD SMD 100MHz 470ohm 25% 400mA 0.3ohm 0603 MAX ECHO | L19 | MAX ECHO | EBMS160808A471
1 | BEAD SMD 100MHz 470ohm 25% 400mA 0.3ohm 0603 MAX ECHO | L19 | MAX ECHO | EBMS160808A471
1 | BEAD SMD 100MHz 470ohm 25% 400mA 0.3ohm 0603 MAX ECHO | L19 | MAX ECHO | EBMS160808A471
6 | BEAD SMD 100MHz 330ohm 25% 3A 0.05ohm 0805 MAX ECHO | -L48, -L49, -L50, -L51, -L52, -L53 | MAX ECHO | ACMS201209A331
6 | BEAD SMD 100MHz 330ohm 25% 3A 0.05ohm 0805 MAX ECHO | -L48, -L49, -L50, -L51, -L52, -L53 | MAX ECHO | ACMS201209A331
6 | BEAD SMD 100MHz 330ohm 25% 3A 0.05ohm 0805 MAX ECHO | -L48, -L49, -L50, -L51, -L52, -L53 | MAX ECHO | ACMS201209A331
6 | BEAD SMD 100MHz 330ohm 25% 3A 0.05ohm 0805 MAX ECHO | -L48, -L49, -L50, -L51, -L52, -L53 | MAX ECHO | ACMS201209A331
6 | BEAD SMD 100MHz 330ohm 25% 3A 0.05ohm 0805 MAX ECHO | -L48, -L49, -L50, -L51, -L52, -L53 | MAX ECHO | ACMS201209A331
1 | BEAD SMD 100MHz 600ohm 25% 0.5A 0.35ohm 0603 MAX ECHO | -L31 | MAX ECHO | EBMS160808A601 0.5A
1 | BEAD SMD 100MHz 600ohm 25% 0.5A 0.35ohm 0603 MAX ECHO | -L31 | MAX ECHO | EBMS160808A601 0.5A
1 | BEAD SMD 100MHz 600ohm 25% 0.5A 0.35ohm 0603 MAX ECHO | -L31 | MAX ECHO | EBMS160808A601 0.5A
1 | BEAD SMD 100MHz 600ohm 25% 0.5A 0.35ohm 0603 MAX ECHO | -L31 | MAX ECHO | EBMS160808A601 0.5A
6 | BEAD SMD 100MHz 30ohm 25% 6A 0.008ohm 0805 MAX ECHO | L18, L23, L60, L64, -L30, -L38 | MAX ECHO | BCMS201209A300
6 | BEAD SMD 100MHz 30ohm 25% 6A 0.008ohm 0805 MAX ECHO | L18, L23, L60, L64, -L30, -L38 | MAX ECHO | BCMS201209A300
6 | BEAD SMD 100MHz 30ohm 25% 6A 0.008ohm 0805 MAX ECHO | L18, L23, L60, L64, -L30, -L38 | MAX ECHO | BCMS201209A300
3 | BEAD SMD 100MHz 100ohm 25% 0.6A 0.15ohm 0603 MAX ECHO | -L32, -L39, -L41 | MAX ECHO | EBMS160808A101 0.6A
3 | BEAD SMD 100MHz 100ohm 25% 0.6A 0.15ohm 0603 MAX ECHO | -L32, -L39, -L41 | MAX ECHO | EBMS160808A101 0.6A
3 | BEAD SMD 100MHz 100ohm 25% 0.6A 0.15ohm 0603 MAX ECHO | -L32, -L39, -L41 | MAX ECHO | EBMS160808A101 0.6A
3 | BEAD SMD 100MHz 100ohm 25% 0.6A 0.15ohm 0603 MAX ECHO | -L32, -L39, -L41 | MAX ECHO | EBMS160808A101 0.6A
3 | BEAD SMD 100MHz 100ohm 25% 0.6A 0.15ohm 0603 MAX ECHO | -L32, -L39, -L41 | MAX ECHO | EBMS160808A101 0.6A
3 | BEAD SMD 100MHz 100ohm 25% 0.6A 0.15ohm 0603 MAX ECHO | -L32, -L39, -L41 | MAX ECHO | EBMS160808A101 0.6A
2 | BEAD SMD 100MHz 60ohm 25% 3A 0.04ohm 0603 MAX ECHO | -L25, -L54 | MAX ECHO | ACMS160808A600
2 | BEAD SMD 100MHz 60ohm 25% 3A 0.04ohm 0603 MAX ECHO | -L25, -L54 | MAX ECHO | ACMS160808A600
2 | BEAD SMD 100MHz 60ohm 25% 3A 0.04ohm 0603 MAX ECHO | -L25, -L54 | MAX ECHO | ACMS160808A600
2 | BEAD SMD 100MHz 60ohm 25% 3A 0.04ohm 0603 MAX ECHO | -L25, -L54 | MAX ECHO | ACMS160808A600
2 | BEAD SMD 100MHz 60ohm 25% 3A 0.04ohm 0603 MAX ECHO | -L25, -L54 | MAX ECHO | ACMS160808A600
2 | BEAD SMD 100MHz 60ohm 25% 3A 0.04ohm 0603 MAX ECHO | -L25, -L54 | MAX ECHO | ACMS160808A600
5 | BEAD SMD 100MHz 400ohm 25% 0.4A 0.3ohm 0603 MAX ECHO | -L37, -L42, -L44, -L45, -L47 | MAX ECHO | EBMS160808A401
5 | BEAD SMD 100MHz 400ohm 25% 0.4A 0.3ohm 0603 MAX ECHO | -L37, -L42, -L44, -L45, -L47 | MAX ECHO | EBMS160808A401
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
1 | *I/F RS232 MAX3232CPWR 3.3/5V TSSOP16 TI | U4 | TI | MAX3232CPWR
1 | *I/F RS232 MAX3232CPWR 3.3/5V TSSOP16 TI | U4 | TI | MAX3232CPWR
1 | *DIODE SUPERFAST ES1DJ 200V 1A SMA(DO-214AC) LISION | -D5 | LISION | ES1DJ
1 | *DIODE SUPERFAST ES1DJ 200V 1A SMA(DO-214AC) LISION | -D5 | LISION | ES1DJ
2 | DIODE BRIDGE TS1100S 100V 1A MICRO TDI PANJIT | BR1, BR2 | PANJIT | TS1100S
2 | *DIODE SCHOTTKY SS54B 40V 5A DO-214AA LISION | D2, D9 | LISION | SS54B
2 | *DIODE SCHOTTKY SS54B 40V 5A DO-214AA LISION | D2, D9 | LISION | SS54B
1 | *DIODE SCHOTTKY SS36 60V 3A DO-214AB LISION | D7 | LISION | SS36
1 | *DIODE SCHOTTKY SS36 60V 3A DO-214AB LISION | D7 | LISION | SS36
3 | *DIODE SWITCHING BAV21WS 250V 0.2A SOD323 LISION | D3, -D10, -D11 | LISION | BAV21WS
3 | *DIODE SWITCHING BAV21WS 250V 0.2A SOD323 LISION | D3, -D10, -D11 | LISION | BAV21WS
2 | *DIODE SUPPRESSOR P6SMBJ60CA 60V 5uA SMB LISION | D4, D6 | LISION | P6SMBJ60CA
2 | *DIODE SUPPRESSOR P6SMBJ60CA 60V 5uA SMB LISION | D4, D6 | LISION | P6SMBJ60CA
2 | LED SMD BI-G/Y T 20mA LTST-C195KGJSKT 1.5X1.6mm LITEON | -LED2, -LED3 | LITE ON | LTST-C195KGJSKT
2 | LED SMD BI-G/Y T 20mA LTST-C195KGJSKT 1.5X1.6mm LITEON | -LED2, -LED3 | LITE ON | LTST-C195KGJSKT
2 | LED SMD BI-G/Y T 20mA LTST-C195KGJSKT 1.5X1.6mm LITEON | -LED2, -LED3 | LITE ON | LTST-C195KGJSKT
2 | LED SMD B T 5mA LTST-C193TBKT-5A 1.6X0.8 LITEON | -LED4, -LED5 | LITE ON | LTST-C193TBKT-5A
2 | LED SMD B T 5mA LTST-C193TBKT-5A 1.6X0.8 LITEON | -LED4, -LED5 | LITE ON | LTST-C193TBKT-5A
2 | LED SMD B T 5mA LTST-C193TBKT-5A 1.6X0.8 LITEON | -LED4, -LED5 | LITE ON | LTST-C193TBKT-5A
2 | LED SMD B T 5mA LTST-C193TBKT-5A 1.6X0.8 LITEON | -LED4, -LED5 | LITE ON | LTST-C193TBKT-5A
2 | LED SMD B T 5mA LTST-C193TBKT-5A 1.6X0.8 LITEON | -LED4, -LED5 | LITE ON | LTST-C193TBKT-5A
1 | *LED SMD BI-R/G T 20mA LTST-C195KGJRKT 1.6X1.5mm LITEON | -LED1 | LITE ON | LTST-C195KGJRKT
1 | *LED SMD BI-R/G T 20mA LTST-C195KGJRKT 1.6X1.5mm LITEON | -LED1 | LITE ON | LTST-C195KGJRKT
1 | *LED SMD BI-R/G T 20mA LTST-C195KGJRKT 1.6X1.5mm LITEON | -LED1 | LITE ON | LTST-C195KGJRKT
1 | *LED SMD BI-R/G T 20mA LTST-C195KGJRKT 1.6X1.5mm LITEON | -LED1 | LITE ON | LTST-C195KGJRKT
7 | *TR NPN PMBT3904 40V 0.2A SOT23 LISION | -Q5, -Q6, -Q10, -Q11, -Q12, -Q14, -Q15 | LISION | PMBT3904
7 | *TR NPN PMBT3904 40V 0.2A SOT23 LISION | -Q5, -Q6, -Q10, -Q11, -Q12, -Q14, -Q15 | LISION | PMBT3904
7 | *TR NPN PMBT3904 40V 0.2A SOT23 LISION | -Q5, -Q6, -Q10, -Q11, -Q12, -Q14, -Q15 | LISION | PMBT3904
7 | *TR NPN PMBT3904 40V 0.2A SOT23 LISION | -Q5, -Q6, -Q10, -Q11, -Q12, -Q14, -Q15 | LISION | PMBT3904
1 | MOSFET N-CH P6015AV 150V 5A SO8 NIKO-SEMI | Q2 | NIKO | P6015AV
1 | MOSFET N-CH P6015AV 150V 5A SO8 NIKO-SEMI | Q2 | NIKO | P6015AV
1 | MOSFET N-CH P6015AV 150V 5A SO8 NIKO-SEMI | Q2 | NIKO | P6015AV
1 | MOSFET N-CH P6015AV 150V 5A SO8 NIKO-SEMI | Q2 | NIKO | P6015AV
1 | *TR PNP 2SB1188-Q-T89R -32V -2A SOT-89 LISION | -Q9 | LISION | 2SB1188-Q-T89R
2 | MOSFET DUAL N+P SIA517DJ-T1-GE3 12V 4.5A SC70-6 VISHAY | -Q7, -Q8 | VISHAY | SIA517DJ-T1-GE3
2 | MOSFET DUAL N+P SIA517DJ-T1-GE3 12V 4.5A SC70-6 VISHAY | -Q7, -Q8 | VISHAY | SIA517DJ-T1-GE3
1 | *X'FMR LAN 1P LG24101SN 1G SMD24 FPE | T2 | FPE | LG24101SN
1 | *X'FMR LAN 1P LG24101SN 1G SMD24 FPE | T2 | FPE | LG24101SN
1 | *X'FMR LAN 1P LG24101SN 1G SMD24 FPE | T2 | FPE | LG24101SN
1 | *X'FMR LAN 1P LG24101SN 1G SMD24 FPE | T2 | FPE | LG24101SN
1 | X'FMR LAN 1P LY24118SN 1G PoE+ SMD24 FPE | T1 | FPE | LY24118SN
1 | X'FMR LAN 1P LY24118SN 1G PoE+ SMD24 FPE | T1 | FPE | LY24118SN
1 | *X'FMR LAN 1P G2462CE 1G PoE+ SMD24 LT/LF MNC | T1 | MENTECH ELECTRONICS CO.,LTD | G2462CE
1 | *X'FMR LAN 1P G2462CE 1G PoE+ SMD24 LT/LF MNC | T1 | MENTECH ELECTRONICS CO.,LTD | G2462CE
1 | X'FMR POWER PW07106ST 42uH 10% 1:0.333:0.333 SMD12 FPE | Q3 | FPE | PW07106ST
1 | X'FMR POWER PW07106ST 42uH 10% 1:0.333:0.333 SMD12 FPE | Q3 | FPE | PW07106ST
1 | *X'FMR POWER EFD-021SG 42uH 10% 1:0.333:0.333 SMD12 MNC | Q3 | MENTECH ELECTRONICS CO.,LTD | EFD-021SG
1 | *X'FMR POWER EFD-021SG 42uH 10% 1:0.333:0.333 SMD12 MNC | Q3 | MENTECH ELECTRONICS CO.,LTD | EFD-021SG
2 | PHOTOCOUPLER EL357N(C)(TA)-G 6V 50mA SMD4 EVERLIGHT | U3, U5 | EVERLIGHT | EL357N(C)(TA)-G
2 | PHOTOCOUPLER EL357N(C)(TA)-G 6V 50mA SMD4 EVERLIGHT | U3, U5 | EVERLIGHT | EL357N(C)(TA)-G
2 | PHOTOCOUPLER EL357N(C)(TA)-G 6V 50mA SMD4 EVERLIGHT | U3, U5 | EVERLIGHT | EL357N(C)(TA)-G
2 | PHOTOCOUPLER EL357N(C)(TA)-G 6V 50mA SMD4 EVERLIGHT | U3, U5 | EVERLIGHT | EL357N(C)(TA)-G
2 | PHOTOCOUPLER EL357N(C)(TA)-G 6V 50mA SMD4 EVERLIGHT | U3, U5 | EVERLIGHT | EL357N(C)(TA)-G
2 | PHOTOCOUPLER EL357N(C)(TA)-G 6V 50mA SMD4 EVERLIGHT | U3, U5 | EVERLIGHT | EL357N(C)(TA)-G
4 | *TVS ARRAY RCLAMP3374N.TCT 3.3V SLP3020N10 SEMTECH | P13, P14, P15, P16 | SEMTECH | RCLAMP3374N.TCT
4 | *TVS ARRAY RCLAMP3374N.TCT 3.3V SLP3020N10 SEMTECH | P13, P14, P15, P16 | SEMTECH | RCLAMP3374N.TCT
4 | *TVS ARRAY RCLAMP3374N.TCT 3.3V SLP3020N10 SEMTECH | P13, P14, P15, P16 | SEMTECH | RCLAMP3374N.TCT
1 | OSC 25MHz +-25ppm 0.3ps 3.3V SMD7X5 HONSONIC | OSC1 | HOSONIC | D36A25.0000ETS
1 | OSC 25MHz +-25ppm 0.3ps 3.3V SMD7X5 HONSONIC | OSC1 | HOSONIC | D36A25.0000ETS
1 | REG FLYBACK PoE PD TPS23754PWPR ADJ TSSOP20 TI | U1 | TI | TPS23754PWPR
1 | REG FLYBACK PoE PD TPS23754PWPR ADJ TSSOP20 TI | U1 | TI | TPS23754PWPR
1 | REG FLYBACK PoE PD TPS23754PWPR ADJ TSSOP20 TI | U1 | TI | TPS23754PWPR
1 | REG FLYBACK PoE PD TPS23754PWPR ADJ TSSOP20 TI | U1 | TI | TPS23754PWPR
1 | REG FLYBACK PoE PD TPS23754PWPR ADJ TSSOP20 TI | U1 | TI | TPS23754PWPR
1 | *REG SYNC BUCK MPQ8632GL-6-Z ADJ 6A QFN13 MPS | U9 | MPS | MPQ8632GL-6-Z
1 | *REG SYNC BUCK MPQ8632GL-6-Z ADJ 6A QFN13 MPS | U9 | MPS | MPQ8632GL-6-Z
2 | *REG SYNC BUCK MP1495DJ-LF-Z ADJ 3A TSOT23-8 MPS | U24, U26 | MPS | MP1495DJ-LF-Z
2 | *REG SYNC BUCK MP1495DJ-LF-Z ADJ 3A TSOT23-8 MPS | U24, U26 | MPS | MP1495DJ-LF-Z
1 | REG SHUNT TL431APUSTR 2.495V 10mA SOT23 AIC | U6 | AIC | TL431APUSTR
1 | REG SHUNT TL431APUSTR 2.495V 10mA SOT23 AIC | U6 | AIC | TL431AGUSTR
1 | REG SHUNT TL431APUSTR 2.495V 10mA SOT23 AIC | U6 | AIC | TL431APUSTR
1 | REG SHUNT TL431APUSTR 2.495V 10mA SOT23 AIC | U6 | AIC | TL431AGUSTR
1 | REG SHUNT TL431APUSTR 2.495V 10mA SOT23 AIC | U6 | AIC | TL431APUSTR
1 | REG SHUNT TL431APUSTR 2.495V 10mA SOT23 AIC | U6 | AIC | TL431AGUSTR
1 | REG SHUNT TL431APUSTR 2.495V 10mA SOT23 AIC | U6 | AIC | TL431APUSTR
1 | REG SHUNT TL431APUSTR 2.495V 10mA SOT23 AIC | U6 | AIC | TL431AGUSTR
1 | REG SHUNT TL431APUSTR 2.495V 10mA SOT23 AIC | U6 | AIC | TL431APUSTR
1 | REG SHUNT TL431APUSTR 2.495V 10mA SOT23 AIC | U6 | AIC | TL431AGUSTR
2 | *CONN MINI PCI-E P0.8 H5.6 90F 1u 50ohm SMD52 CONCRAFT | CONN5, CONN6 | DRAGONSTATE | 0717A0BA56C
2 | *CONN MINI PCI-E P0.8 H5.6 90F 1u 50ohm SMD52 CONCRAFT | CONN5, CONN6 | DRAGONSTATE | 0717A0BA56C
2 | *CONN MINI PCI-E P0.8 H5.6 90F 1u 50ohm SMD52 CONCRAFT | CONN5, CONN6 | DRAGONSTATE | 0717A0BA56C
1 | R02 SHIELD FRAME EAP1028B-FLF-ZZ LT | Shield Frame | HUN PAI ENTERPRISE CO.,LTD. | E1028-F0002
1 | R02 SHIELD FRAME EAP1028B-FLF-ZZ LT | Shield Frame | HUN PAI ENTERPRISE CO.,LTD. | E1028-F0002
4 | R01 NUT 82-250-01-030-RL EAP9018FA-FLF-09J LT | H4, H5, H6, H9 | FIVETECH TECHNOLOGY INC. | 82-250-01-030-RL
4 | R01 NUT 82-250-01-030-RL EAP9018FA-FLF-09J LT | H4, H5, H6, H9 | FIVETECH TECHNOLOGY INC. | 82-250-01-030-RL
3 | R01 SMT NUT PCB 82-150-20-131-01-RL EAP1028B-25-0714-EC LT | H10, H11, H12 | BIFU/QUANYING | SMT NUT M3-θ5.5X13X1.5mm
3 | R01 SMT NUT PCB 82-150-20-131-01-RL EAP1028B-25-0714-EC LT | H10, H11, H12 | FIVETECH TECHNOLOGY INC. | 82-150-20-131-01-RL
1 | R01 PCB 6L EAP1028B-25-0714-EC MAIN | PCB | TSUDING GLOBAL ELECTRONIC CO.,LTD | 142000001137A
1 | R01 PCB 6L EAP1028B-25-0714-EC MAIN | PCB | TSUDING GLOBAL ELECTRONIC CO.,LTD | 142000001137A
2 | RES SMD 0ohm 5% 1/8W 0805 | R53, R64 | PHYCOMP | 232273091002L
2 | RES SMD 0ohm 5% 1/8W 0805 | R53, R64 | WAL SIN | WR08X000PTL
2 | RES SMD 0ohm 5% 1/8W 0805 | R53, R64 | YAGEO | RC0805JR-070RL
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
