Mert-Eren-Karabulut/ECW7220-HardwareInfo/Hardware/2GHz board/BOM/2G_BOM.xls

part_no | levelx | ancestor | location | product_no | quantity | descrip | unit_meas | lead_time | lvl_id | sort_no | version | stat_default | ecn_no | stat_leaf | dt_vldfrom | bond_mark | line | bom_type | rank | stat_cost | unique_display | weight | weight_unit | rohs_remark | sale_type_desc | sale_type_remark | stat_running | qty_minord | gic | esd | msl | kit_rate
SI2381028001E | 1 | NI2381028001E |  | NI2381028001E | 1 | ??SMD ASM EAP1028B-12-0115-38 2G MODULE | EA | 255 | 1 | 001 | 1.03 | 1 | DCN150900762 | 0 | 09/10/2015 14:13:33.147 | N | 1 | 1 |  | 0 |  | 0 |  | RoHS 2.0 | Wireless Enterprise AP | Wireless Enterprise AP | 0 | 0 |  |  |  | 1
102000000291A | 2 | NI2381028001E | L4 | SI2381028001E | 1 | IND POWER SMD 1uH 20% 2.2A 0.1365ohm 2.5X2X1.2mm LT/LF MAGIC | EA | 42 | 1 | 001001 |  | 1 | DCN150900903 | 1 | 07/31/2012 10:01:20.4 | N | 1 |  | Z | 1 | COMMON | 0.02 | g | RoHS 2.0 |  |  | 0 | 2000 | 0¢J~70¢J=Commercial | none | none | 1
110300000129A | 2 | NI2381028001E | U10, U11, U12 | SI2381028001E | 3 | RF IC SE2594L-R PWR AMP 3.3V QFN32 LT/LF SIGE | EA | 112 | 2 | 001002 |  | 1 | DCN150900903 | 1 | 08/15/2012 09:16:18.837 | N | 1 |  | Z | 1 | COMMON | 0.0718 | g | RoHS 2.0+PFOS |  |  | 0 | 3000 | -40¢J~85¢J=Industrial | Class 0 < 250V | 3 | 1
110300000185A | 2 | NI2381028001E | U1 | SI2381028001E | 1 | RF IC BCM43431KMLG 1.2V QFN100 LT/LF BROADCOM(ZZ) | EA | 140 | 3 | 001003 |  | 1 | DCN150900903 | 1 | 09/26/2013 16:18:30.533 | N | 1 |  | C | 1 | COMMON | 0.3502 | g | RoHS 2.0+PFOS | 1103-RF IC | 1103-RF IC | 0 | 1 | 0¢J~70¢J=Commercial | Class 1C 1000 to<2000V | 3 | 1
116000000017A | 2 | NI2381028001E | Y1 | SI2381028001E | 1 | X'TAL 20MHz +-7ppm 16pF 35ohm SMD3.2X2.5mm LT/LF TXC | EA | 56 | 4 | 001004 |  | 1 | DCN150900903 | 1 | 07/31/2012 10:01:20.52 | N | 1 |  | A | 1 | COMMON | 0.022 | g | RoHS7 | 1160-Crystal | 1160-Crystal | 0 | 3000 | 0¢J~70¢J=Commercial |  |  | 1
116800000260A | 2 | NI2381028001E | U14 | SI2381028001E | 1 | *REG SYN BUCK MP2130DG-LF-Z ADJ 3.5A QFN12 LT/LF MPS | EA | 56 | 5 | 001005 |  | 1 | DCN150900903 | 1 | 09/11/2015 13:18:07.277 | N | 1 |  | L | 1 | COMMON | 0.0201 | g | RoHS7 | 1168-Regulator | 1168-Regulator | 0 | 5000 | -40¢J~85¢J=Industrial | Class 3B >=8000V | 1 | 1
119900200100E | 2 | NI2381028001E | J0, J1, J2 | SI2381028001E | 3 | CONN RF U.FL H1.25mm 180 MALE SMD3 LT/LF | EA | 63 | 6 | 001006 |  | 1 | DCN150900903 | 1 | 07/31/2012 10:01:20.59 | N | 1 |  | A | 1 | COMMON | 0.1 | g | RoHS7 |  |  | 0 | 50000 | -40¢J~85¢J=Industrial |  |  | 1.003
123500000170A | 2 | NI2381028001E | X1 | SI2381028001E | 1 | R01 SHIELD FRAME 2.4G 27.75X29.08X2.1mm EAP1018FB-FLF-MK LT | EA | 35 | 7 | 001007 |  | 1 | DCN150900903 | 1 | 08/15/2012 18:26:17.983 | N | 1 |  | C | 1 | COMMON | 0.6 | g | RoHS 2.0 | 1235-FRAME/FIXTURE/SUPPORT/SHIELD | 1235-FRAME/FIXTURE/SUPPORT/SHIELD | 0 | 1000 |  |  |  | 1
142000000969A | 2 | NI2381028001E |  | SI2381028001E | 1 | R01 PCB 4L EAP1028B-FLF-ZZ 2G MODULE LT/LF | EA | 42 | 8 | 001008 |  | 1 | DCN150900893 | 1 | 09/11/2015 13:21:11.627 | N | 1 |  |  | 1 | COMMON | 0 | g | RoHS 2.0+PFOS | 142-are PCB (Accton) | 142-are PCB (Accton) | 0 | 1 |  |  |  | 1
20000000JM40A | 2 | NI2381028001E | R36, R43, R44, R49, R125, R126, R127, R147, R148, R149, R150 | SI2381028001E | 11 | RES SMD 0ohm 5% 1/10W 0603 LT/LF | EA | 14 | 9 | 001009 |  | 1 | DCN150900903 | 1 | 07/31/2012 10:01:20.65 | N | 1 |  | A | 1 | COMMON | 0.0019 | g | RoHS7 |  |  | 0 | 5000 | -55¢J~125¢J=Military |  |  | 1.003
20000000JN60A | 2 | NI2381028001E | R30, R31, R32, R33, R34, R37, R38, R39, R40, R47, R151 | SI2381028001E | 11 | RES SMD 0ohm 5% 1/16W 0402 LT/LF | EA | 14 | 10 | 001010 |  | 1 | DCN150900903 | 1 | 07/31/2012 10:01:20.707 | N | 1 |  | A | 1 | COMMON | 0.0006 | g | RoHS7 |  |  | 0 | 10000 | -55¢J~125¢J=Military |  |  | 1.003
20000000JT90E | 2 | NI2381028001E | R20, R21, R35, R41, R42, R90, R91, R109, R110, R111, R112, R122, R131, R133, R135, R136, R137, R138, R140, R142, R143, R144, R145, R152, R153, R154, R155, R156, R157 | SI2381028001E | 29 | RES SMD 0ohm 5% 1/20W 0201 LT/LF | EA | 14 | 11 | 001011 |  | 1 | DCN150900903 | 1 | 07/31/2012 10:01:20.763 | N | 1 |  | A | 1 | COMMON | 0.0001 | g | RoHS7 | 2000-SMD Carbon SMD Resistor | 2000-SMD Carbon SMD Resistor | 0 | 15000 | -55¢J~125¢J=Military |  |  | 1.003
20001000FN60E | 2 | NI2381028001E | R128, R129, R130 | SI2381028001E | 3 | RES SMD 10ohm 1% 1/16W -300~500ppm/¢J 0402 LT/LF | EA | 14 | 12 | 001012 |  | 1 | DCN150900903 | 1 | 07/31/2012 10:01:20.83 | N | 1 |  | A | 1 | COMMON | 0.0006 | g | RoHS7 |  |  | 0 | 10000 | -55¢J~125¢J=Military |  |  | 1.003
20010010FT70A | 2 | NI2381028001E | R5, R6 | SI2381028001E | 2 | RES SMD 1Kohm 1% 1/20W 0201 LT/LF | EA | 14 | 13 | 001013 |  | 1 | DCN150900903 | 1 | 07/31/2012 10:01:20.897 | N | 1 |  | A | 1 | COMMON | 0.0001 | g | RoHS6 |  |  | 0 | 15000 | -55¢J~125¢J=Military |  |  | 1
20020030FT90J | 2 | NI2381028001E | R120 | SI2381028001E | 1 | RES SMD 200Kohm 1% 1/20W 0201 LT/LF | EA | 14 | 14 | 001014 |  | 1 | DCN150900903 | 1 | 09/10/2015 16:24:07.91 | N | 1 |  | A | 1 | COMMON | 0.0001 | g | RoHS6 |  |  | 0 | 10000 | 0¢J~70¢J=Commercial |  |  | 1
200500000125A | 2 | NI2381028001E | R121 | SI2381028001E | 1 | RES SMD 100Kohm 1% 1/20W 200ppm/¢J 0201 LT/LF | EA | 14 | 15 | 001015 |  | 1 | DCN150900903 | 1 | 07/31/2012 10:01:20.963 | N | 1 |  | A | 1 | COMMON | 0.0001 | g | RoHS7 | 2005-SMD Chip Resistor | 2005-SMD Chip Resistor | 0 | 15000 | -55¢J~125¢J=Military |  |  | 1
200500000141A | 2 | NI2381028001E | R104, R105, R106, R107, R108 | SI2381028001E | 5 | RES SMD 3.3Kohm 1% 1/20W 200ppm/¢J 0201 LT/LF | EA | 14 | 16 | 001016 |  | 1 | DCN150900903 | 1 | 07/31/2012 10:01:21.03 | N | 1 |  | A | 1 | COMMON | 0.0001 | g | RoHS7 |  |  | 0 | 15000 | -55¢J~125¢J=Military |  |  | 1
200500000144A | 2 | NI2381028001E | R12 | SI2381028001E | 1 | RES SMD 221ohm 1% 1/20W 200ppm/¢J 0201 LT/LF | EA | 14 | 17 | 001017 |  | 1 | DCN150900903 | 1 | 07/31/2012 10:01:21.11 | N | 1 |  | A | 1 | COMMON | 0.0001 | g | RoHS7 |  |  | 0 | 15000 | -55¢J~125¢J=Military |  |  | 1
200500000145A | 2 | NI2381028001E | R50 | SI2381028001E | 1 | RES SMD 15Kohm 1% 1/20W 200ppm/¢J 0201 LT/LF | EA | 14 | 18 | 001018 |  | 1 | DCN150900903 | 1 | 07/31/2012 10:01:21.173 | N | 1 |  | A | 1 | COMMON | 0.0001 | g | RoHS7 |  |  | 0 | 15000 | -55¢J~125¢J=Military |  |  | 1
200500000281A | 2 | NI2381028001E | R119 | SI2381028001E | 1 | RES SMD 196Kohm 1% 1/20W 200ppm/¢J 0201 LT/LF | EA | 14 | 19 | 001019 |  | 1 | DCN150900903 | 1 | 09/10/2015 16:26:19.17 | N | 1 |  | Z | 1 | COMMON | 0.0001 | g | RoHS7 |  |  | 0 | 15000 | -55¢J~125¢J=Military |  |  | 1
204000000160A | 2 | NI2381028001E | C146 | SI2381028001E | 1 | C SMD CER 3300pF 10% 6.3V X7R 0201 T0.3mm LT/LF | EA | 14 | 20 | 001020 |  | 1 | DCN150900903 | 1 | 07/31/2012 10:01:21.377 | N | 1 |  | Z | 1 | COMMON | 0.0003 | g | RoHS 2.0+PFOS |  |  | 0 | 15000 | -55¢J~125¢J=Military |  |  | 1
204000000161A | 2 | NI2381028001E | C222, C223, C224 | SI2381028001E | 3 | C SMD CER 0.068uF 10% 6.3V X5R 0201 T0.3mm LT/LF | EA | 14 | 21 | 001021 |  | 1 | DCN150900903 | 1 | 07/31/2012 10:01:21.44 | N | 1 |  | Z | 1 | COMMON | 0.0003 | g | RoHS 2.0+PFOS | 2040-SMD Multilayer Ceramic Capacitor | 2040-SMD Multilayer Ceramic Capacitor | 0 | 15000 | -40¢J~85¢J=Industrial |  |  | 1
204000000162A | 2 | NI2381028001E | C211, C212, C213 | SI2381028001E | 3 | C SMD CER 180pF 10% 16V X7R 0201 T0.3mm LT/LF | EA | 14 | 22 | 001022 |  | 1 | DCN150900903 | 1 | 07/31/2012 10:01:21.52 | N | 1 |  | Z | 1 | COMMON | 0.0003 | g | RoHS 2.0+PFOS |  |  | 0 | 15000 | -55¢J~125¢J=Military |  |  | 1
2041019JE100E | 2 | NI2381028001E | C55, C69, C138, C142, C143, C198 | SI2381028001E | 6 | C SMD CER 100pF 5% 25V NPO 0201 T0.3mm LT/LF | EA | 14 | 23 | 001023 |  | 1 | DCN150900903 | 1 | 07/31/2012 10:01:21.587 | N | 1 |  | A | 1 | COMMON | 0.0003 | g | RoHS6 |  |  | 0 | 15000 | -55¢J~125¢J=Military |  |  | 1
2041029KE100E | 2 | NI2381028001E | C64, C65, C66, C67, C68, C70, C71, C87, C90, C91, C239, C240, C241 | SI2381028001E | 13 | C SMD CER 1000pF 10% 25V X7R 0201 T0.3mm LT/LF | EA | 14 | 24 | 001024 |  | 1 | DCN150900903 | 1 | 07/31/2012 10:01:21.647 | N | 1 |  | A | 1 | COMMON | 0.0003 | g | RoHS6 |  |  | 0 | 15000 | -55¢J~125¢J=Military |  |  | 1
2041049KJ000E | 2 | NI2381028001E | C22, C28, C29, C30, C31, C32, C33, C34, C36, C40, C49, C50, C51, C52, C60, C61, C62, C63, C97, C99, C100, C105, C106, C191, C192, C197, C228, C229, C230, C236, C237, C238 | SI2381028001E | 32 | C SMD CER 0.1uF 10% 6.3V X5R 0201 LT/LF | EA | 56 | 25 | 001025 |  | 1 | DCN150900903 | 1 | 07/31/2012 10:01:21.707 | N | 1 |  | A | 1 | COMMON | 0.0003 | g | RoHS6 |  |  | 0 | 15000 | -40¢J~85¢J=Industrial |  |  | 1.003
2041053MA100E | 2 | NI2381028001E | C1, C95, C103, C104, C145, C195, C196, C202, C205, C206, C207, C208, C209, C210, C234 | SI2381028001E | 15 | C SMD CER 1uF 20% 10V X5R 0402 T0.5mm TAIYO(WM8931BE ) | EA | 14 | 26 | 001026 |  | 1 | DCN150900903 | 1 | 07/31/2012 10:01:21.77 | N | 1 |  | A | 1 | COMMON | 0.002 | g | RoHS6 |  |  | 0 | 10000 | -55¢J~125¢J=Military |  |  | 1.003
2041060KC100J | 2 | NI2381028001E | C199, C200, C201 | SI2381028001E | 3 | C SMD CER 10uF 10% 16V X5R 0805 T1.25mm LT/LF HOLYSTONE | EA | 14 | 27 | 001027 |  | 1 | DCN150900903 | 1 | 07/31/2012 10:01:21.853 | N | 1 |  | L | 1 | COMMON | 0.0173 | g | RoHS7 |  |  | 0 | 3000 | -40¢J~85¢J=Industrial | none | none | 1.003
2041064KJ000J | 2 | NI2381028001E | C35, C235 | SI2381028001E | 2 | C SMD CER 10uF 20% 6.3V X5R 0603 T0.8mm LT/LF YAGEO | EA | 14 | 28 | 001028 |  | 1 | DCN150900903 | 1 | 07/31/2012 10:01:21.913 | N | 1 |  | A | 1 | COMMON | 0.0058 | g | RoHS7 |  |  | 0 | 8000 | -40¢J~85¢J=Industrial |  |  | 1.003
2042209JH100J | 2 | NI2381028001E | C18 | SI2381028001E | 1 | C SMD CER 22pF +-5% 50V NPO 0201 T0.3mm LT/LF YAGEO | EA | 56 | 29 | 001029 |  | 1 | DCN150900903 | 1 | 08/15/2012 09:15:47.693 | N | 1 |  | A | 1 | COMMON | 0.0003 | g | RoHS6 |  |  | 0 | 15000 |  |  |  | 1
2042254KJ010E | 2 | NI2381028001E | C56, C123 | SI2381028001E | 2 | C SMD CER 2.2uF +-10% 6.3V X5R 0603 T0.8mm LT/LF | EA | 14 | 30 | 001030 |  | 1 | DCN150900903 | 1 | 07/31/2012 10:01:21.987 | N | 1 |  | A | 1 | COMMON | 0.0068 | g | RoHS7 |  |  | 0 | 4000 | -40¢J~85¢J=Industrial |  |  | 1.003
2044754KJ000E | 2 | NI2381028001E | C119, C121, C225, C226, C227, C248 | SI2381028001E | 6 | C SMD CER 4.7uF +-10% 6.3V X5R 0603 T0.8mm LT/LF | EA | 14 | 31 | 001031 |  | 1 | DCN150900903 | 1 | 07/31/2012 10:01:22.057 | N | 1 |  | A | 1 | COMMON | 0.0068 | g | RoHS7 |  |  | 0 | 4000 | -40¢J~85¢J=Industrial |  |  | 1.003
204700000031A | 2 | NI2381028001E | C231, C232, C233 | SI2381028001E | 3 | RF C SMD CER 9pF +-0.1pF 25V NPO 0201 T0.3mm LT/LF WALSIN | EA | 14 | 32 | 001032 |  | 1 | DCN150900903 | 1 | 07/31/2012 10:01:22.12 | N | 1 |  | Z | 1 | COMMON | 0.0003 | g | RoHS7 | 2040-SMD Multilayer Ceramic Capacitor | 2040-SMD Multilayer Ceramic Capacitor | 0 | 15000 | -55¢J~125¢J=Military |  |  | 1
204700000039A | 2 | NI2381028001E | C17 | SI2381028001E | 1 | C SMD CER 30pF 5% 25V NPO 0201 T0.3mm LT/LF MURATA | EA | 14 | 33 | 001033 |  | 1 | DCN150900903 | 1 | 08/15/2012 09:15:01.017 | N | 1 |  | B | 1 | COMMON | 0.0003 | g | RoHS7 |  |  | 0 | 15000 | -55¢J~125¢J=Military | none | none | 1
246200000039A | 2 | NI2381028001E |  | SI2381028001E | 1 | R01 ACCLABEL 26X6mm(@°ª·Å) LT | EA | 14 | 34 | 001034 |  | 1 | DCN150900903 | 1 | 04/21/2015 01:03:24.903 | N | 1 |  | A | 1 | COMMON | 0.0124 | g | RoHS6 |  |  | 0 | 20000 |  |  |  | 1.1
WI2ZZ1028002E | 2 | NI2381028001E | U2 | SI2381028001E | 1 | **?F/W ASM EAP1028B-FLF-ZZ 2G MODULE U2 (OFF-LINE) | EA | 255 | 35 | 001035 | 1 | 1 | DCN150900903 | 0 | 09/10/2013 13:38:25.317 | N | 1 | 0 |  | 0 |  | 0 |  | RoHS 2.0 | Wireless Enterprise AP | Wireless Enterprise AP | 0 | 0 |  |  |  | 1
107000000032A | 3 | NI2381028001E | U2 | WI2ZZ1028002E | 1 | EEPROM AT93C66B-MAHM-T 4Kb 1.7~5.5V 5ms UDFN8 LT/LF ATMEL | EA | 56 | 1 | 001035001 |  | 1 |  | 1 | 09/10/2013 13:47:08.157 | N | 1 |  | Z | 1 | COMMON | 9.659 | g | RoHS7 | 1070-EEPROM | 1070-EEPROM | 0 | 5000 | -40¢J~85¢J=Industrial | Class 2 2000 to<4000V | 1 | 1
249100001272A | 3 | NI2381028001E | U2 | WI2ZZ1028002E | 1 | V1.0 F/W EAP1028B-FLF-ZZ 2G MODULE U2 C.S:22E4 | EA | 56 | 2 | 001035002 |  | 1 |  | 1 | 09/10/2013 13:35:11.73 | N | 1 |  |  | 0 |  | 0 | g | Non-RoHS |  |  | 0 | 0 |  |  |  | 1
TI2381028001E | 1 | NI2381028001E |  | NI2381028001E | 1 | ??NON SMD ASM EAP1028B-12-0115-38 2G MODULE | EA | 255 | 2 | 002 | 1.01 | 1 | DCN150900900 | 0 | 09/10/2015 14:13:38.157 | N | 1 | 1 |  | 0 |  | 0 |  | RoHS 2.0 | Wireless Enterprise AP | Wireless Enterprise AP | 0 | 0 |  |  |  | 1
123500000169A | 2 | NI2381028001E | X1 | TI2381028001E | 1 | R01 SHIELD COVER RF 2.4G 28.25X29.58X2mm EAP1018FB-FLF-MK LT | EA | 35 | 1 | 002001 |  | 1 | DCN150900902 | 1 | 08/16/2012 09:37:55.583 | N | 1 |  | C | 1 | COMMON | 1 | g | RoHS 2.0 | 1235-FRAME/FIXTURE/SUPPORT/SHIELD | 1235-FRAME/FIXTURE/SUPPORT/SHIELD | 0 | 1000 |  |  |  | 1
125800000211A | 2 | NI2381028001E |  | TI2381028001E | 3 | R01 THERMAL PAD SR-800MT 4X4X1.3mm EAP1018FB-FLF-MK LT | EA | 28 | 2 | 002002 |  | 1 | DCN150900902 | 1 | 09/24/2013 10:47:34.043 | N | 1 |  | Z | 1 | COMMON | 0.02 | g | RoHS 2.0 | 1258-THERMAL PAD | 1258-THERMAL PAD | 0 | 1 |  |  |  | 1
125800000221A | 2 | NI2381028001E |  | TI2381028001E | 1 | R01 THERMAL PAD TBN-060 10X10X1.5mm EAP1018FB-FLF-MK LT | EA | 28 | 3 | 002003 |  | 1 | DCN150900902 | 1 | 09/24/2013 10:48:02.747 | N | 1 |  | Z | 1 | COMMON | 0.71 | g | RoHS 2.0 |  |  | 0 | 1 |  |  |  | 1
146955-002 | 2 | NI2381028001E |  | TI2381028001E | 1 | R01 ACCLABEL 23X4mm LT | EA | 21 | 4 | 002004 |  | 1 | DCN150900902 | 1 | 08/22/2012 17:59:09.823 | N | 1 |  | A | 1 | COMMON | 0 |  | RoHS7 |  |  | 0 | 87550 |  |  |  | 1.1
