Mert-Eren-Karabulut/ECW7220-HardwareInfo/Mechanical/Base + Cover/3D/heat-sink-cover-123700000083A.stp

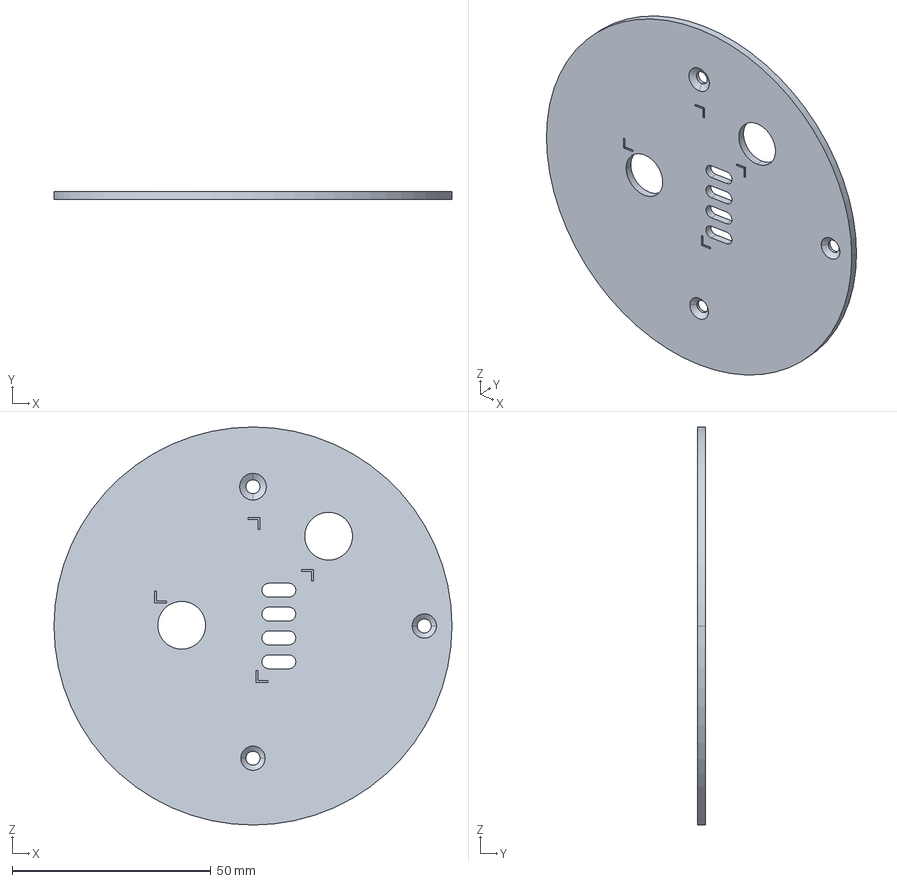
[picture p23: CAD file, 2020-07-31]
Mechanical/Base + Cover/3D/heat-sink-cover-123700000083A.stp
100.0 x 2.00 x 100.0 mm
