Mert-Eren-Karabulut/ECW7220-HardwareInfo/Mechanical/Base + Cover/3D/cover-123200000567A.stp

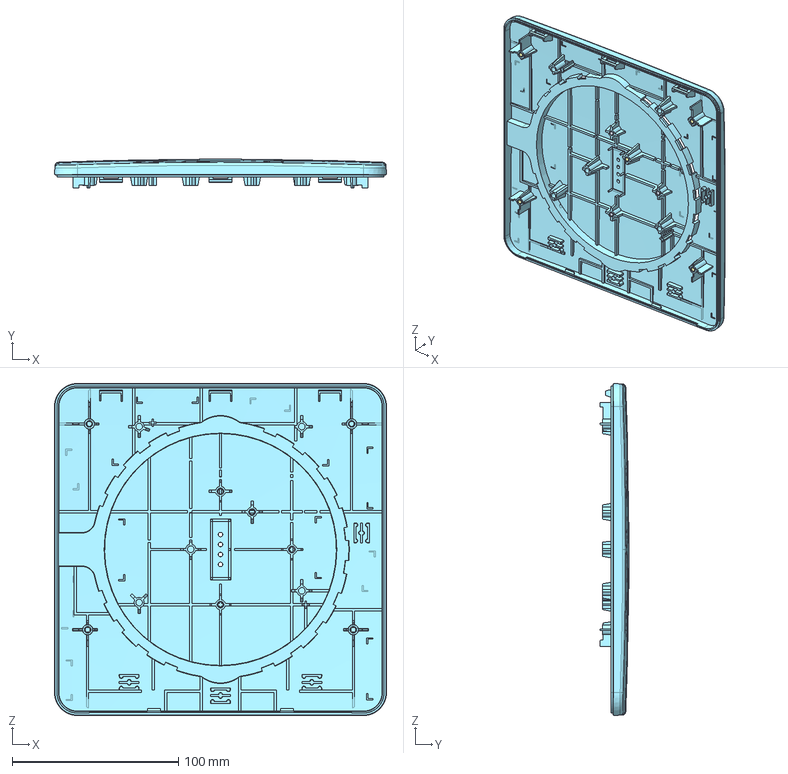
[picture p24: CAD file, 2020-07-31]
Mechanical/Base + Cover/3D/cover-123200000567A.stp
200.0 x 17.4 x 200.0 mm
COVER-EAP1018A1-EAP1028B_90
