Mert-Eren-Karabulut/ECW7220-HardwareInfo/Mechanical/Base + Cover/3D/heat-sink-pcb-123700000082A.stp

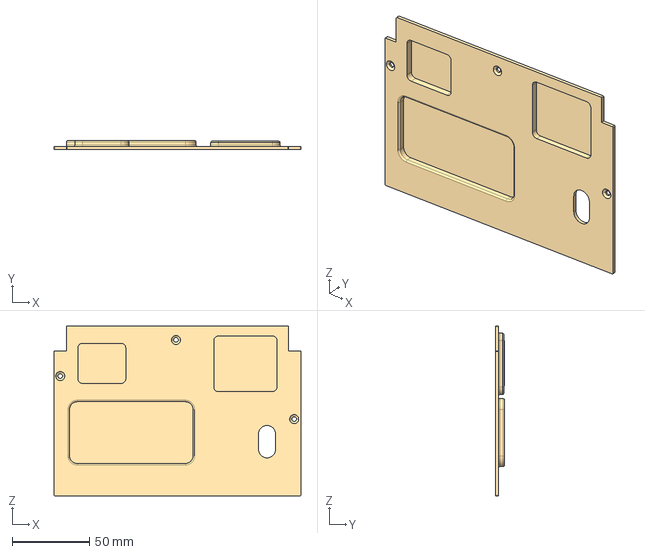
[picture p25: CAD file, 2020-07-31]
Mechanical/Base + Cover/3D/heat-sink-pcb-123700000082A.stp
160.0 x 6.00 x 110.0 mm
