Mert-Eren-Karabulut/ECW7220-HardwareInfo/Mechanical/Base + Cover/3D/shielding-cover-123500000361A.stp

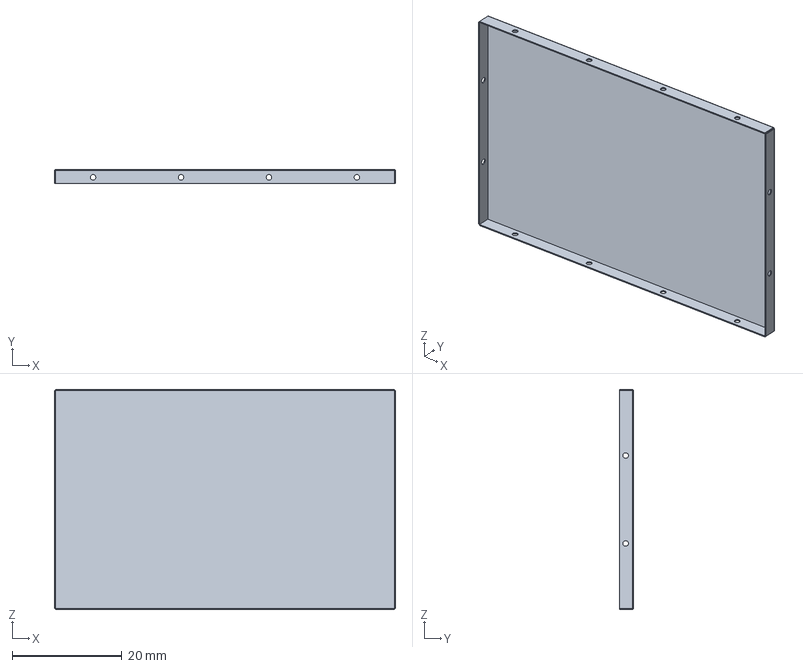
[picture p26: CAD file, 2020-07-31]
Mechanical/Base + Cover/3D/shielding-cover-123500000361A.stp
62.0 x 2.50 x 40.1 mm
