Mert-Eren-Karabulut/ECW7220-HardwareInfo/(list of files, cad)

Other CAD files:
Mechanical/Assembly/explode-EAP1028B-12-0115-EC-A1.dwg
Mechanical/Base + Cover/2D/cover-123200000567A-02-1.dwg
Mechanical/Base + Cover/2D/cover-123200000567A-02-2.dwg
Mechanical/Base + Cover/2D/base-123100000635A-02.dwg
Mechanical/Base + Cover/2D/heat-sink-pcb-123700000082A-01.dwg
Mechanical/Base + Cover/2D/heat-sink-cover-123700000083A-01.dwg
Mechanical/Base + Cover/2D/shielding-cover-123500000361A-R01.dwg
Mechanical/Base + Cover/2D/cover-123200000567A-02-3.dwg
