Mert-Eren-Karabulut/ECW7220-HardwareInfo/Mechanical/Assembly/explode-EAP1028B-12-0115-EC-A1.pdf

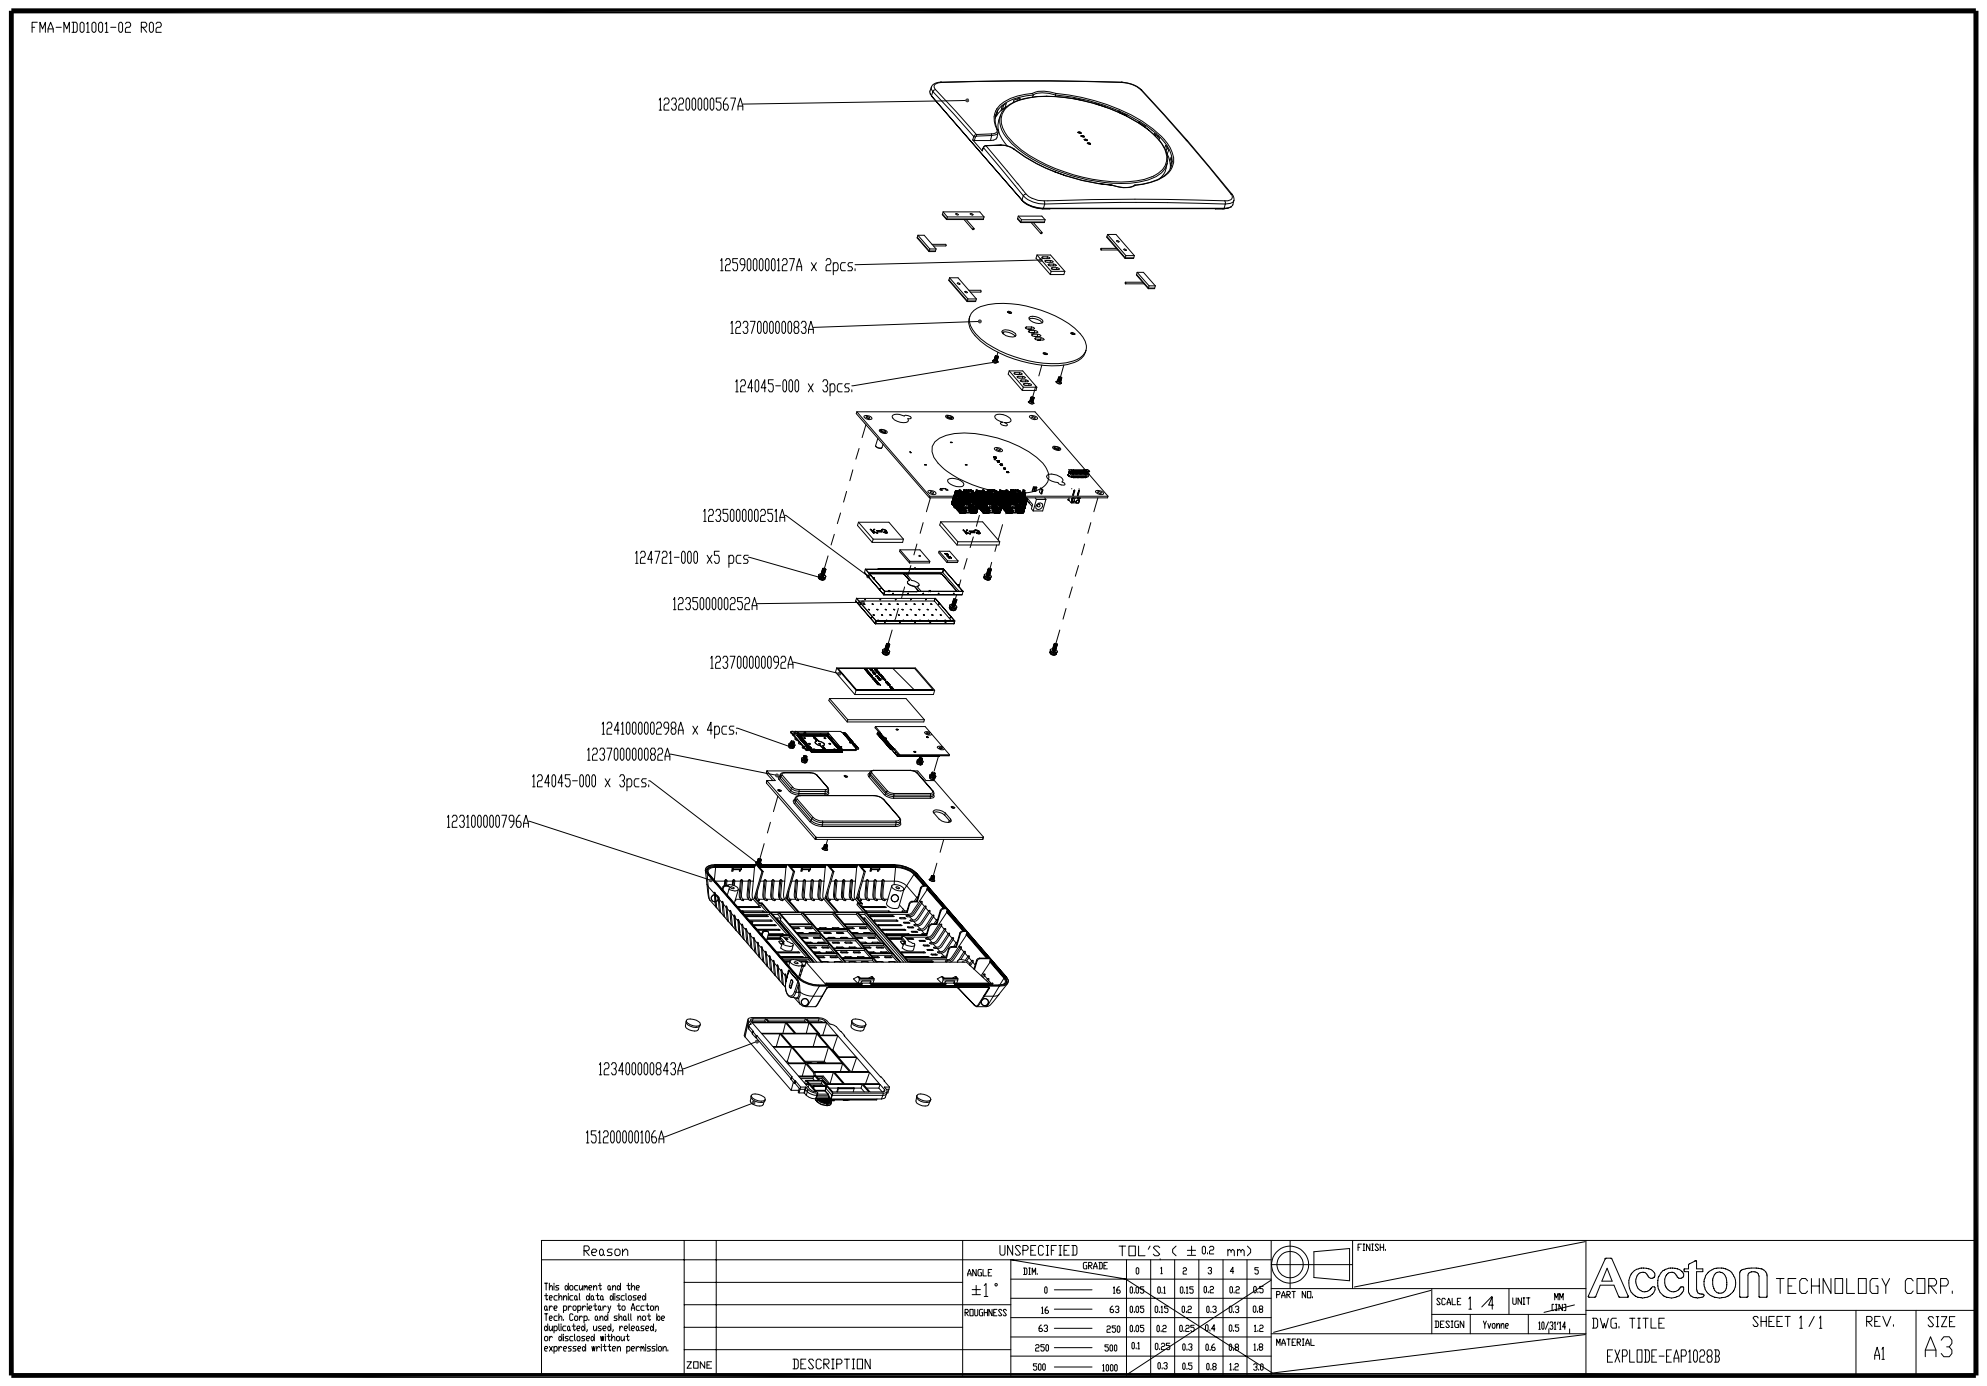
[picture p75: page 1]
