Mert-Eren-Karabulut/ECW7220-HardwareInfo/Mechanical/Base + Cover/2D/base-123100000635A-02.pdf

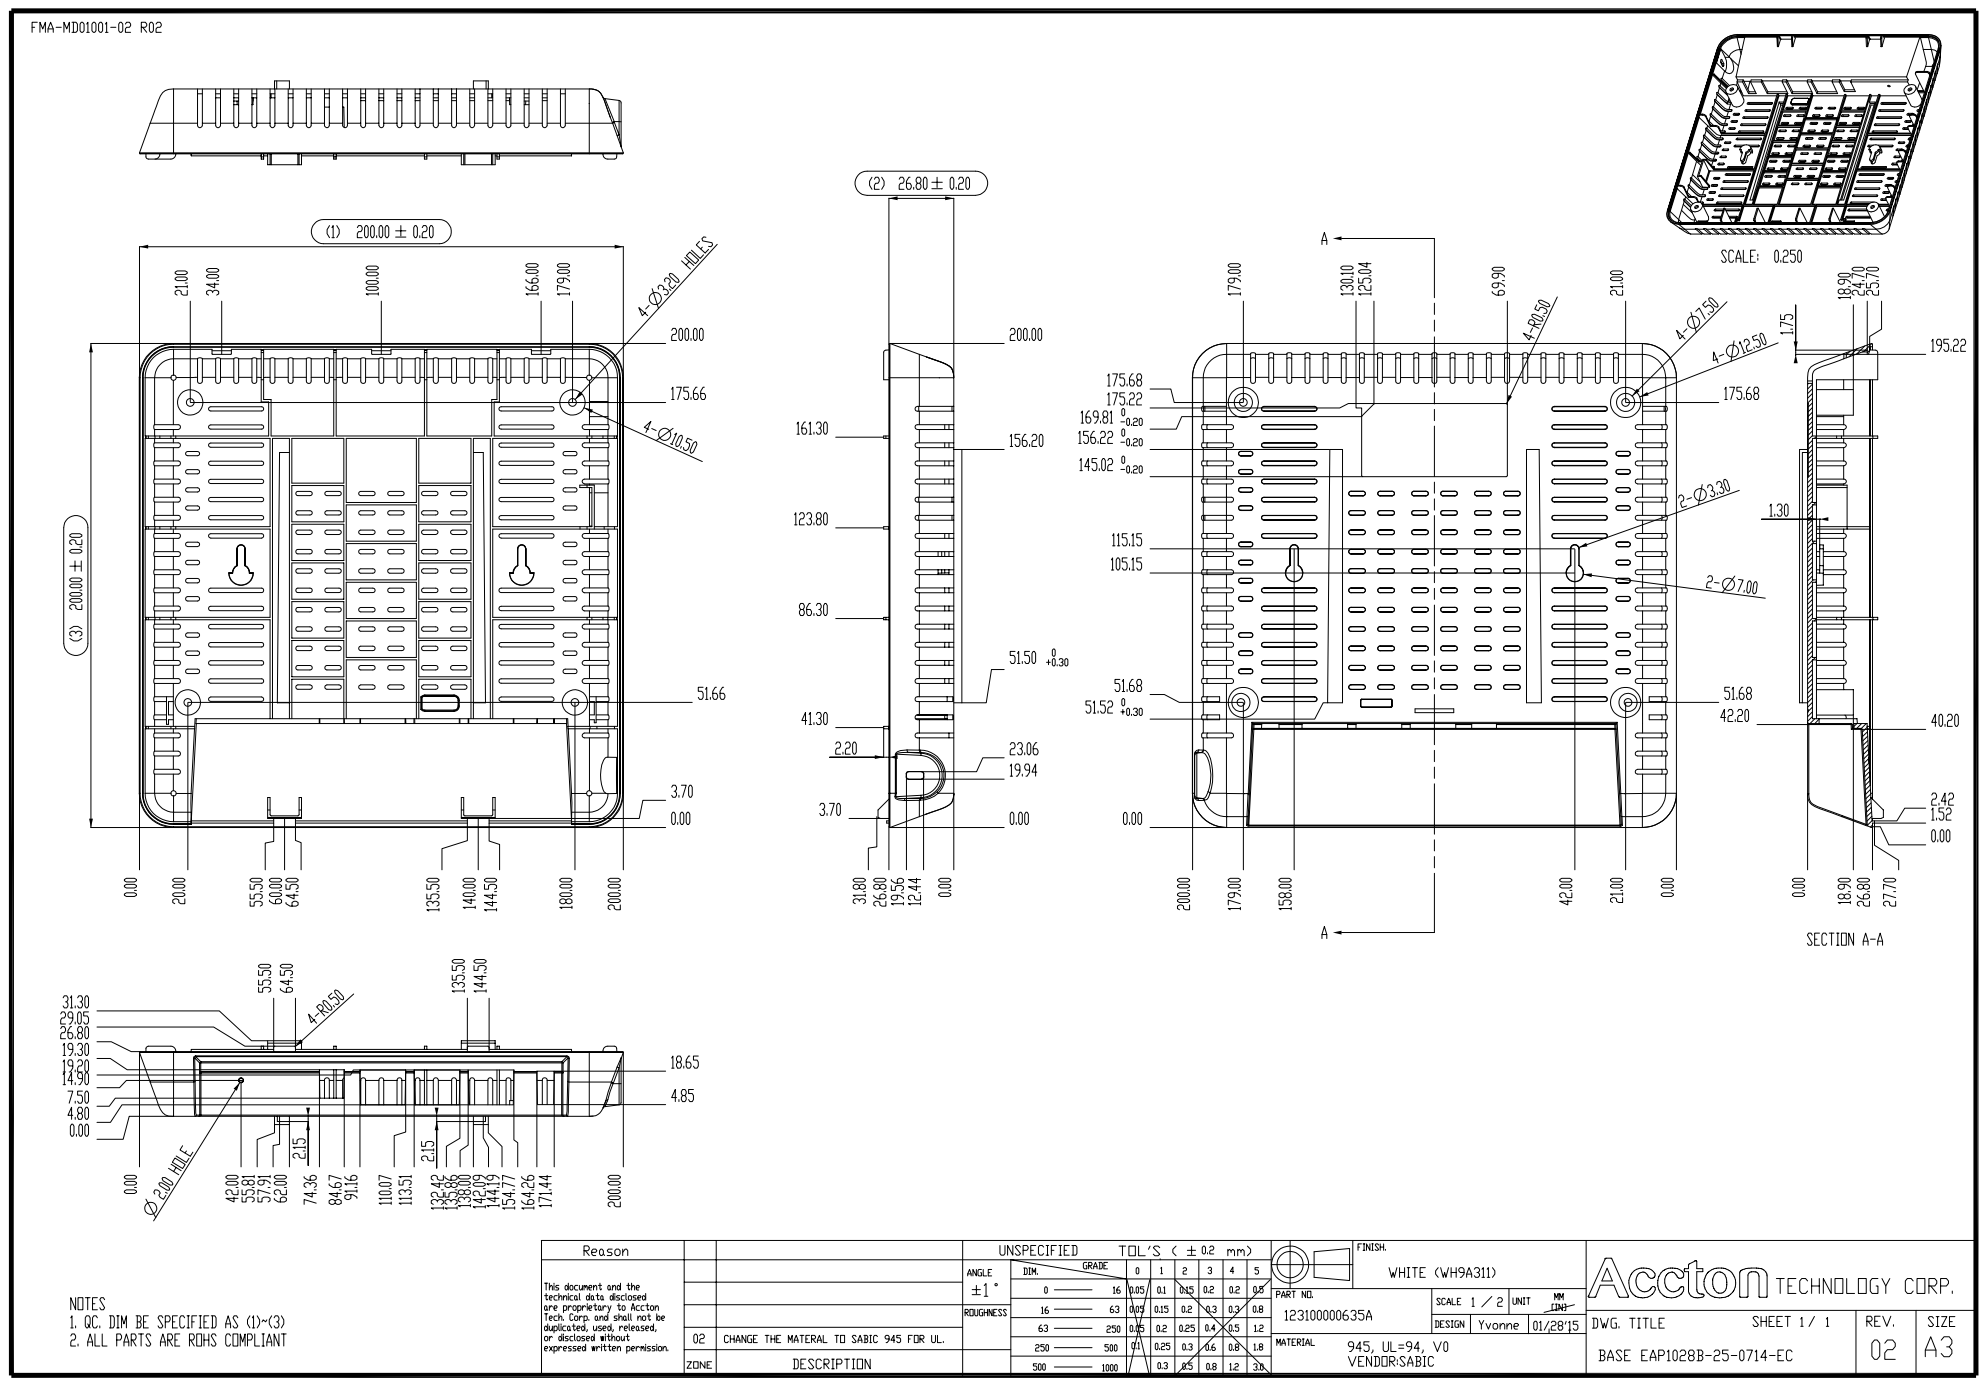
[picture p76: page 1]
