Mert-Eren-Karabulut/ECW7220-HardwareInfo/Mechanical/Base + Cover/2D/cover-123200000567A-02.pdf

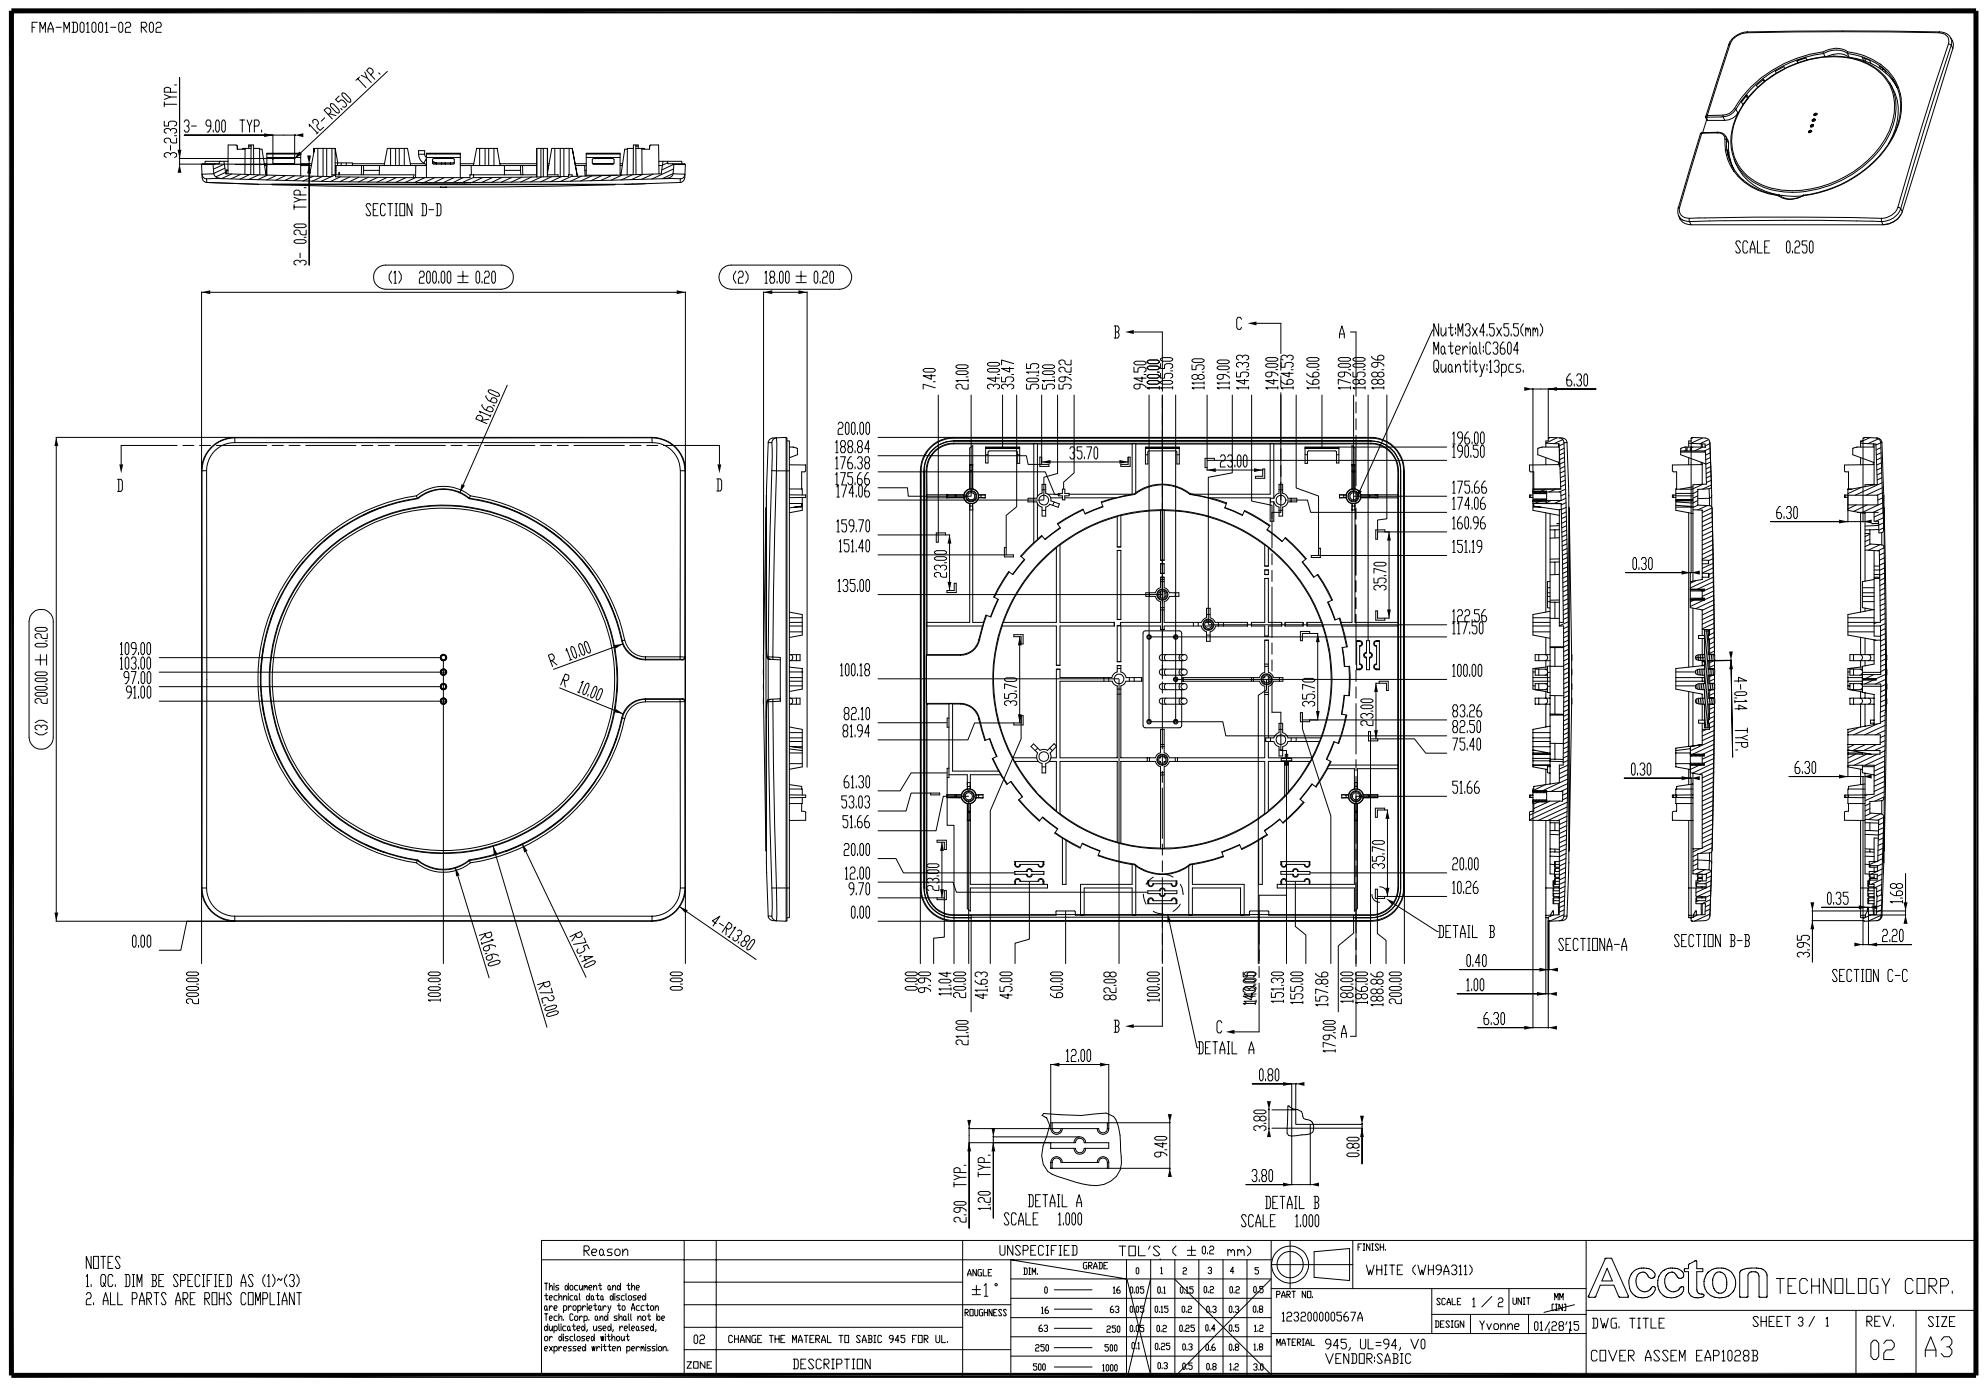
[picture p77: page 1]
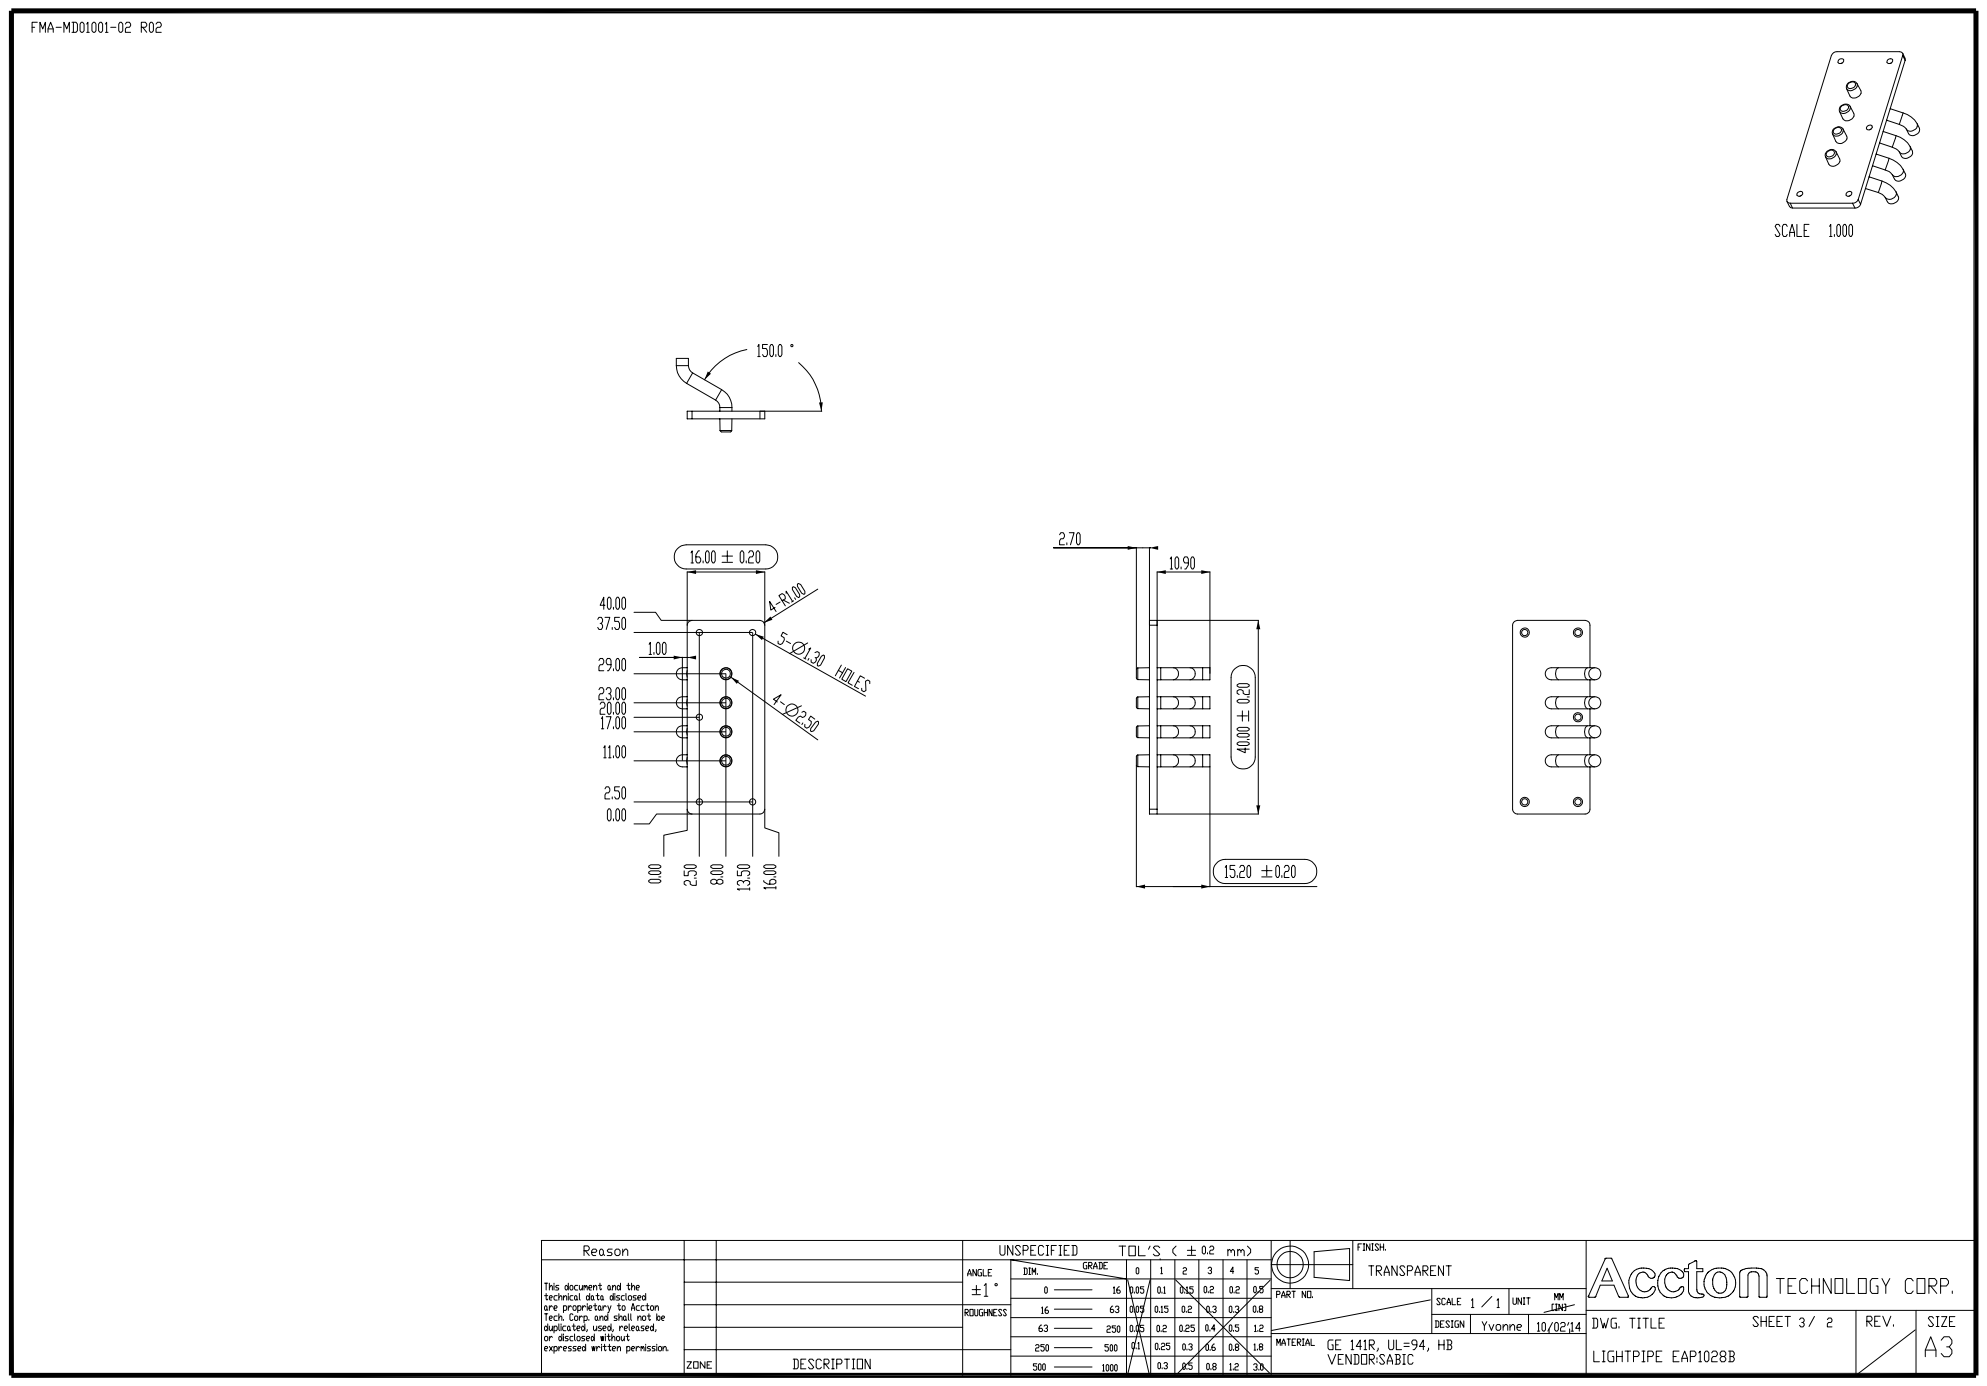
[picture p78: page 2]
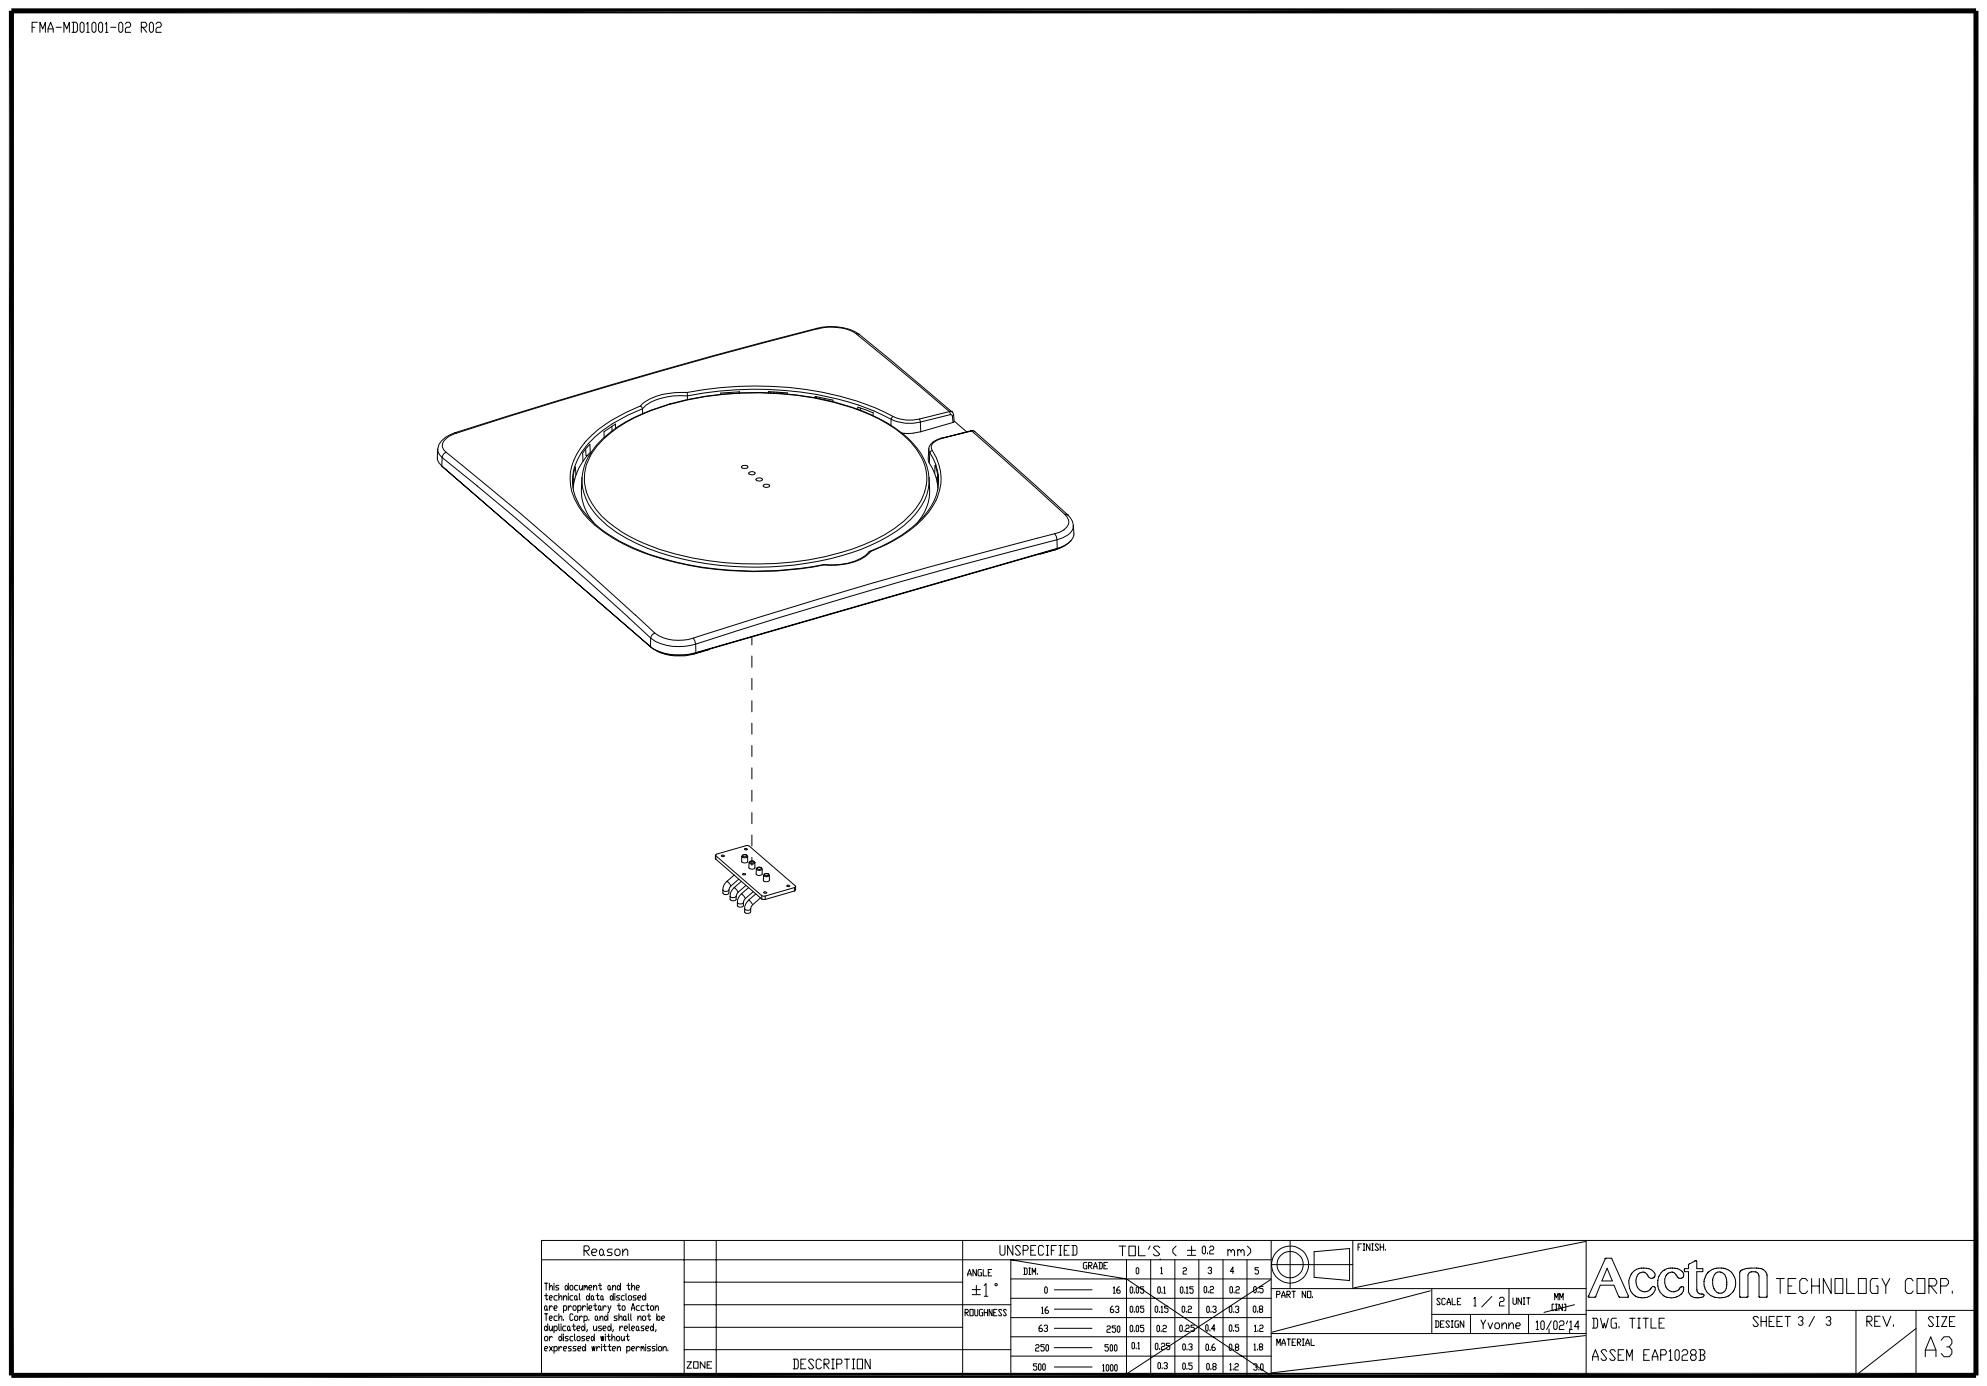
[picture p79: page 3]
