Mert-Eren-Karabulut/ECW7220-HardwareInfo/Mechanical/Base + Cover/2D/explode-eap1028b_A2.pdf

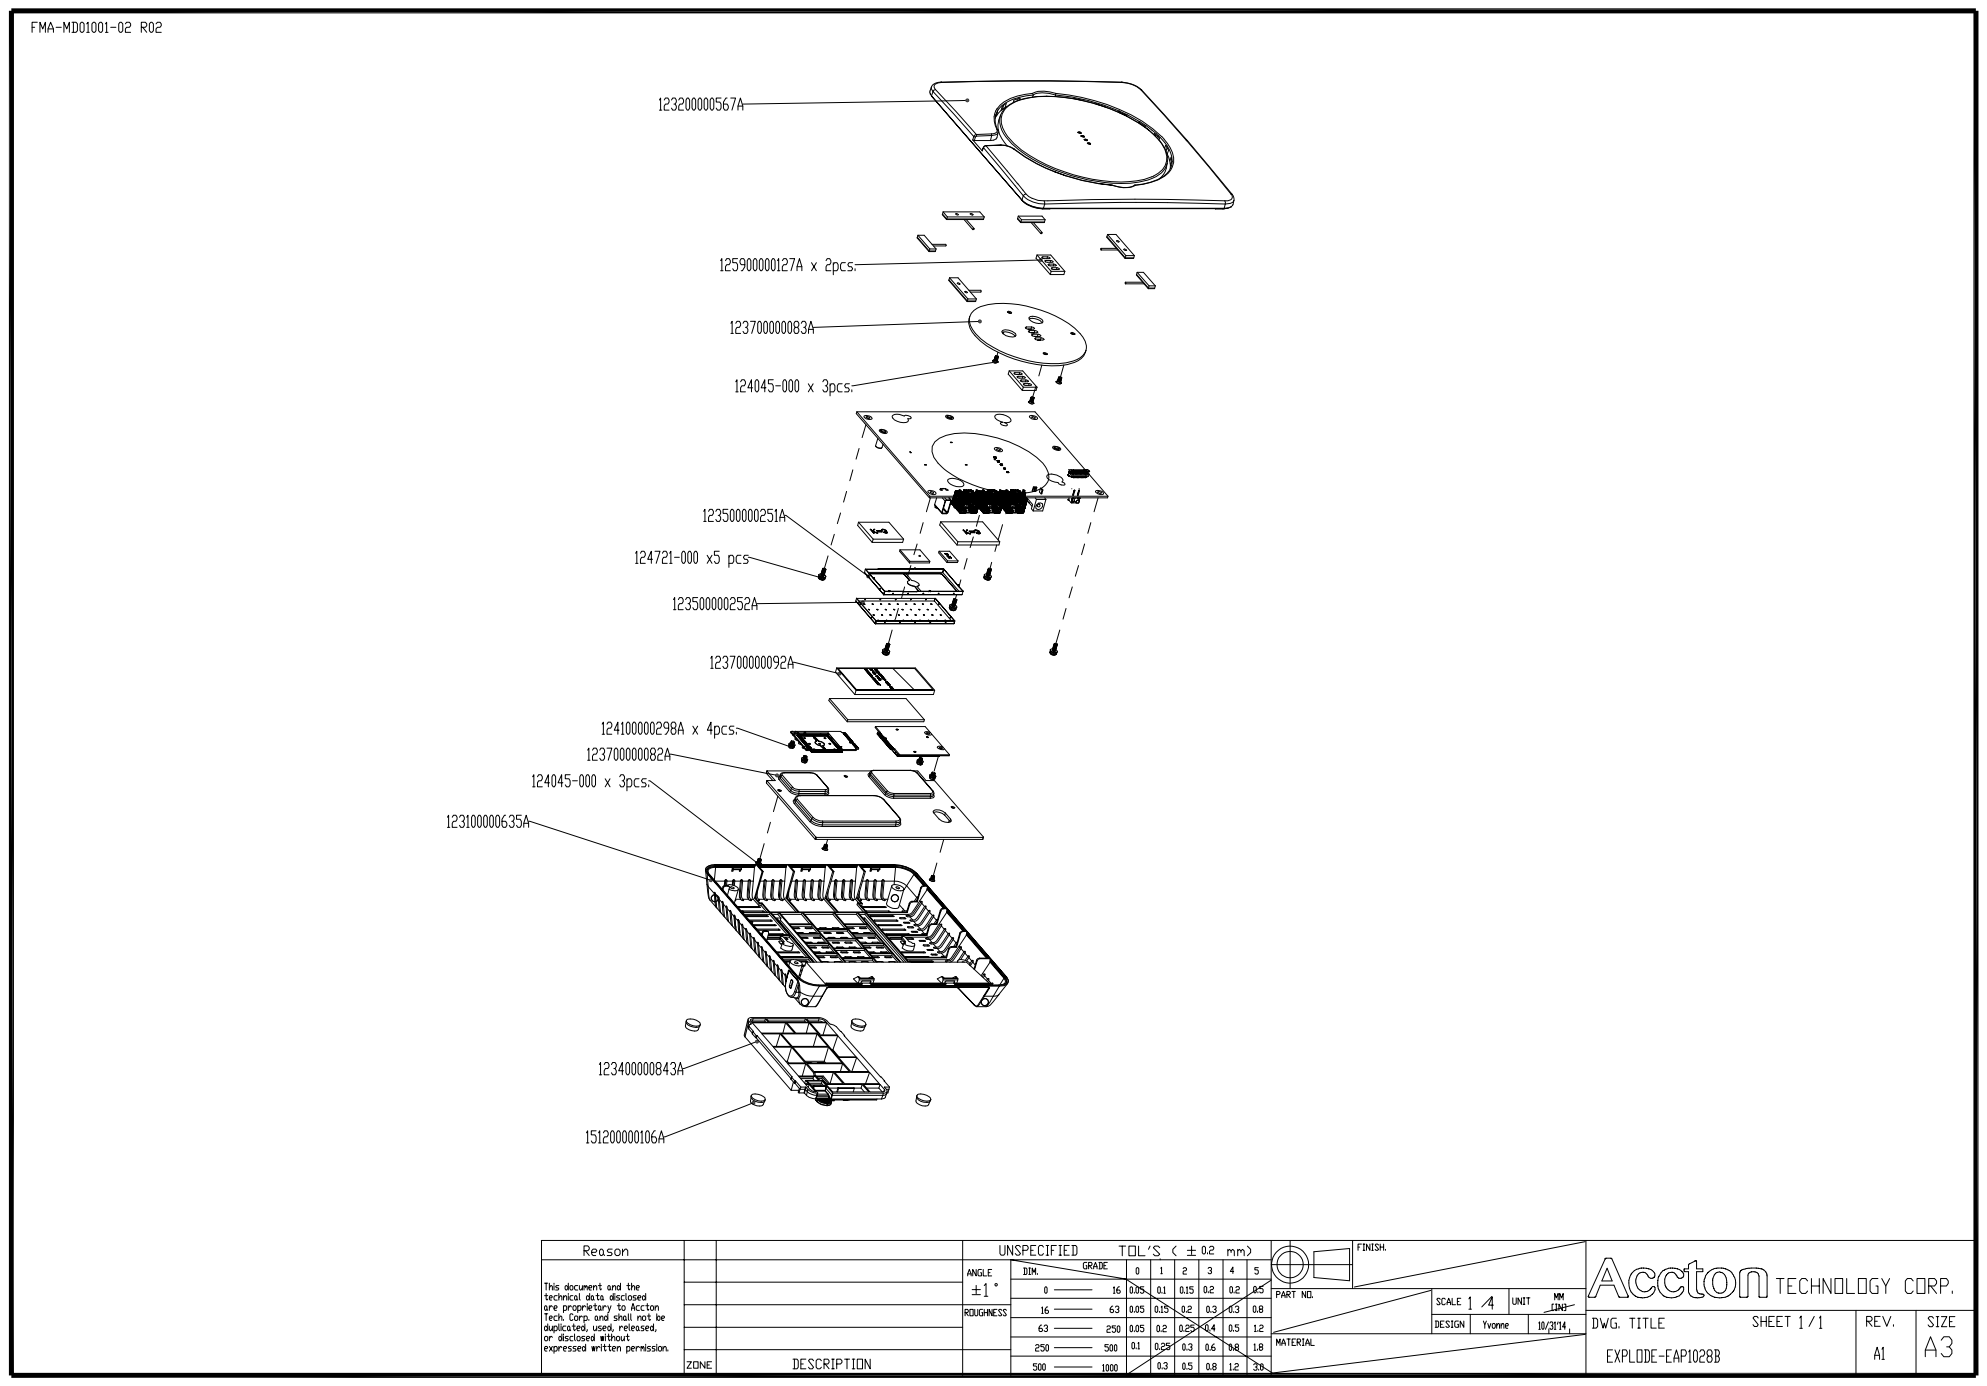
[picture p80: page 1]
