Mert-Eren-Karabulut/ECW7220-HardwareInfo/Mechanical/Base + Cover/2D/heat-sink-cover-123700000083A-01.pdf

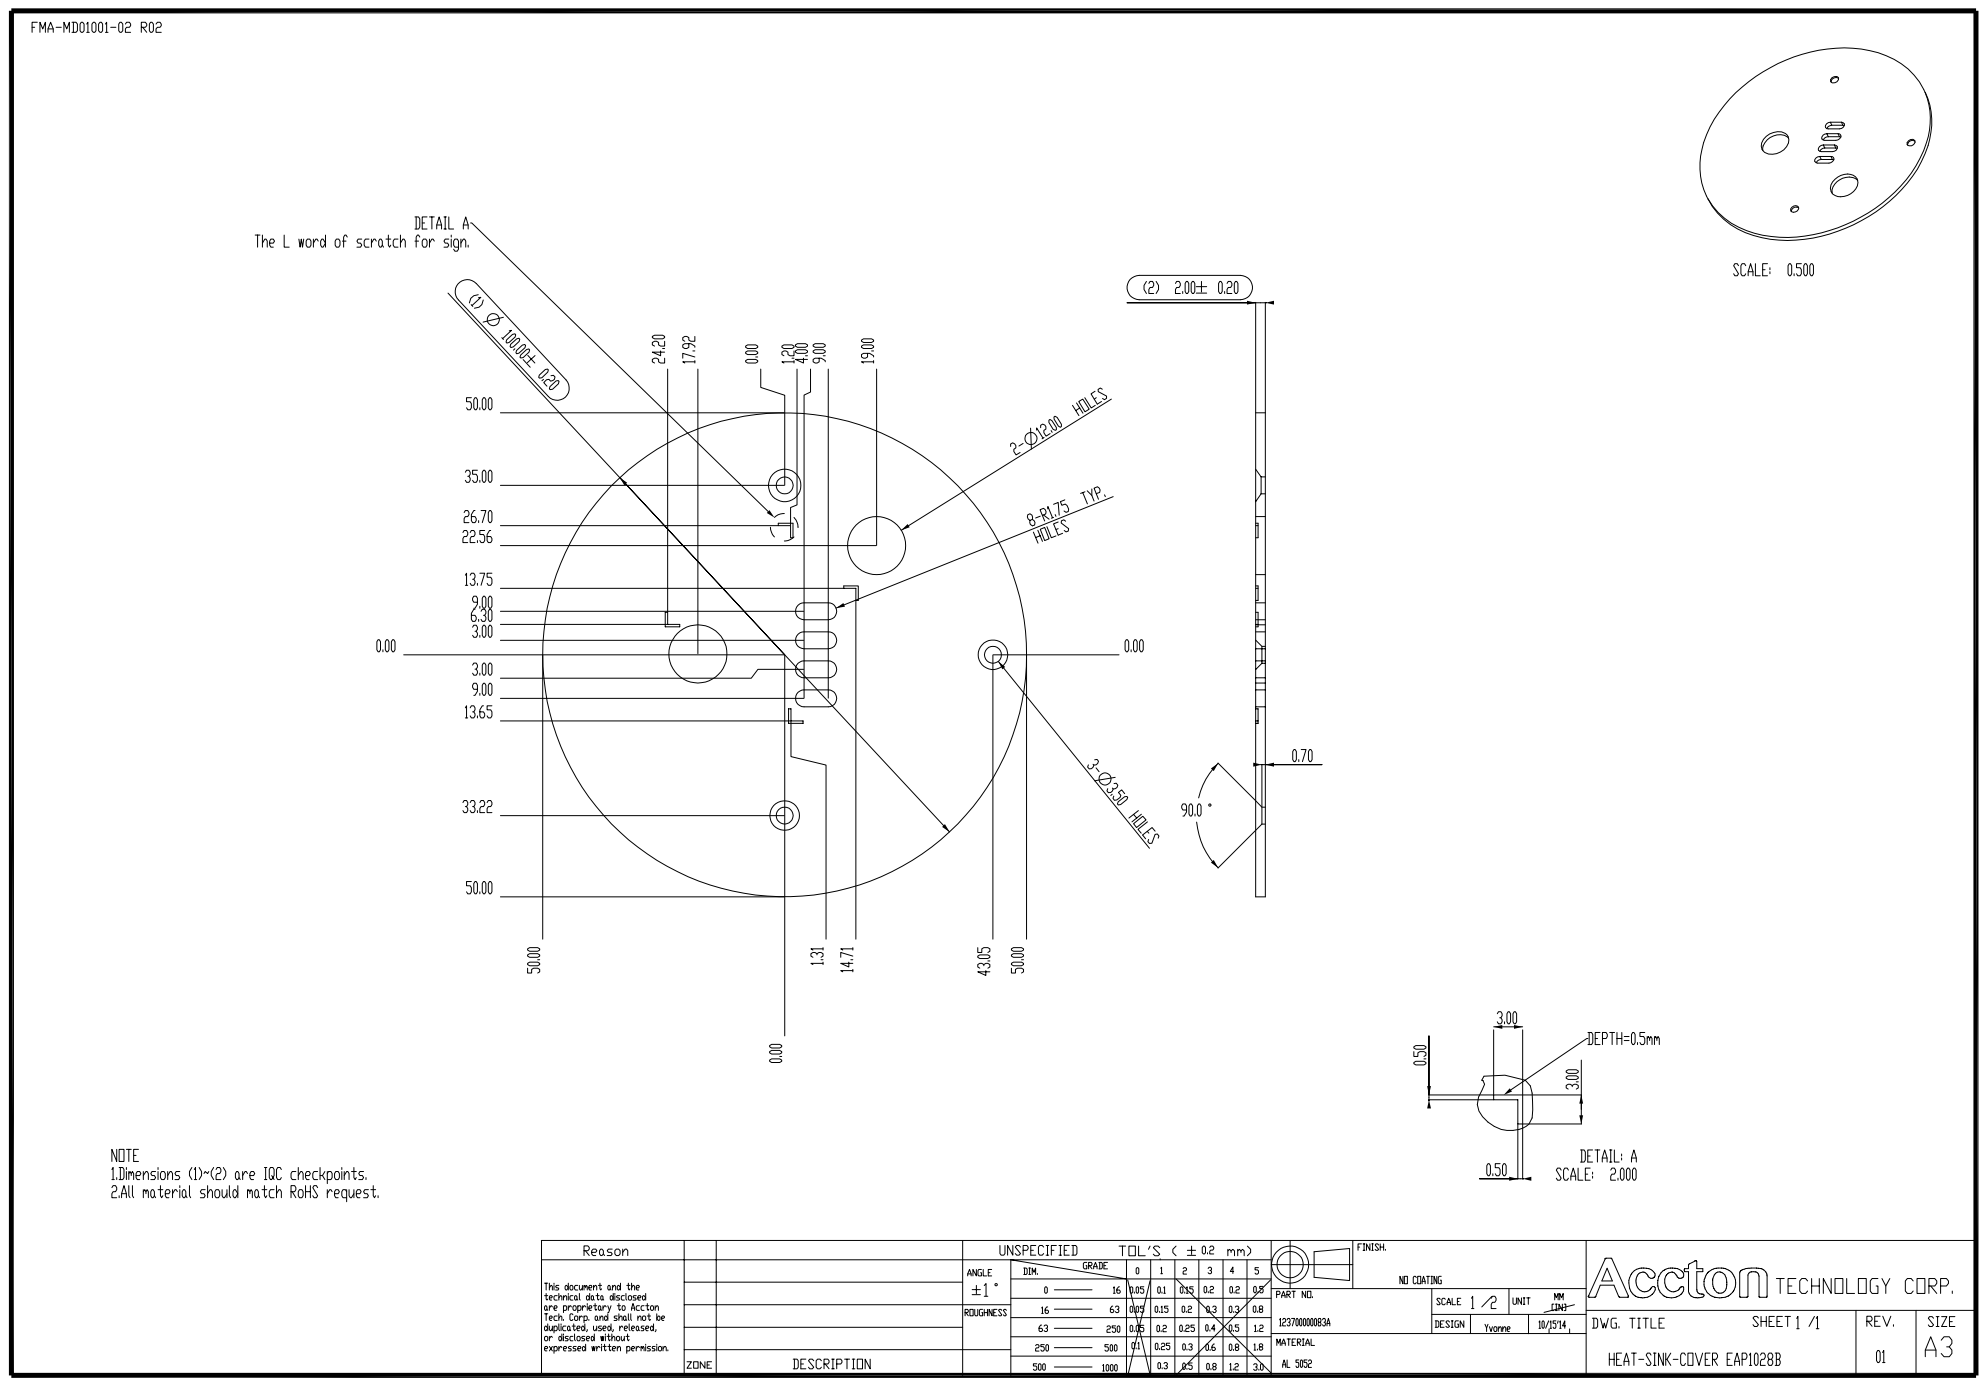
[picture p81: page 1]
