Mert-Eren-Karabulut/ECW7220-HardwareInfo/Mechanical/Base + Cover/2D/heat-sink-pcb-123700000082A-01.pdf

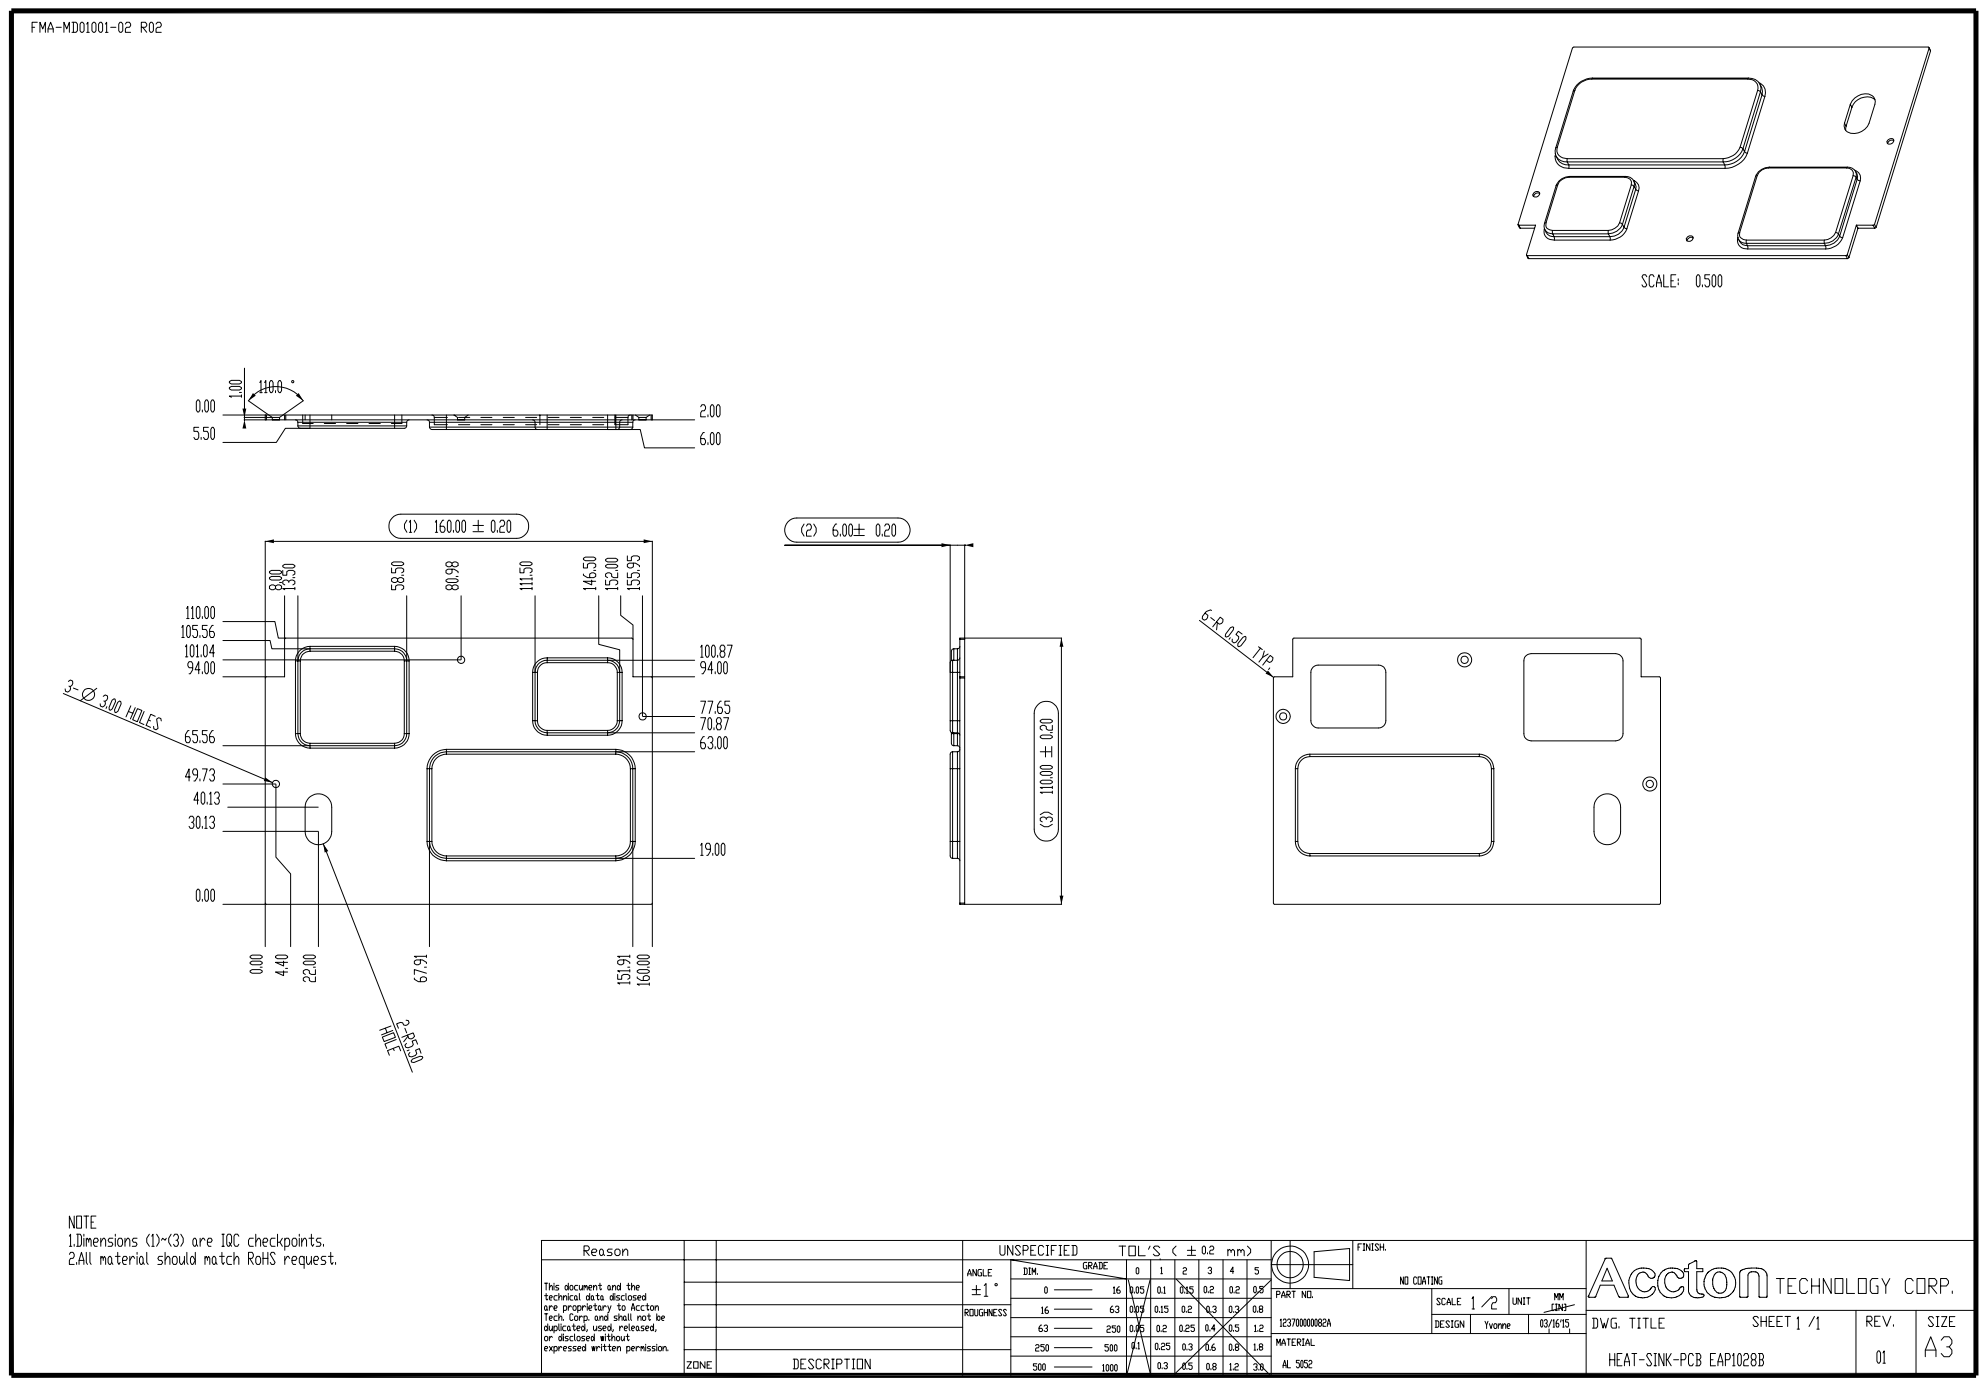
[picture p82: page 1]
