Mert-Eren-Karabulut/ECW7220-HardwareInfo/Mechanical/Base + Cover/2D/shielding-cover-123500000361A-R01.pdf

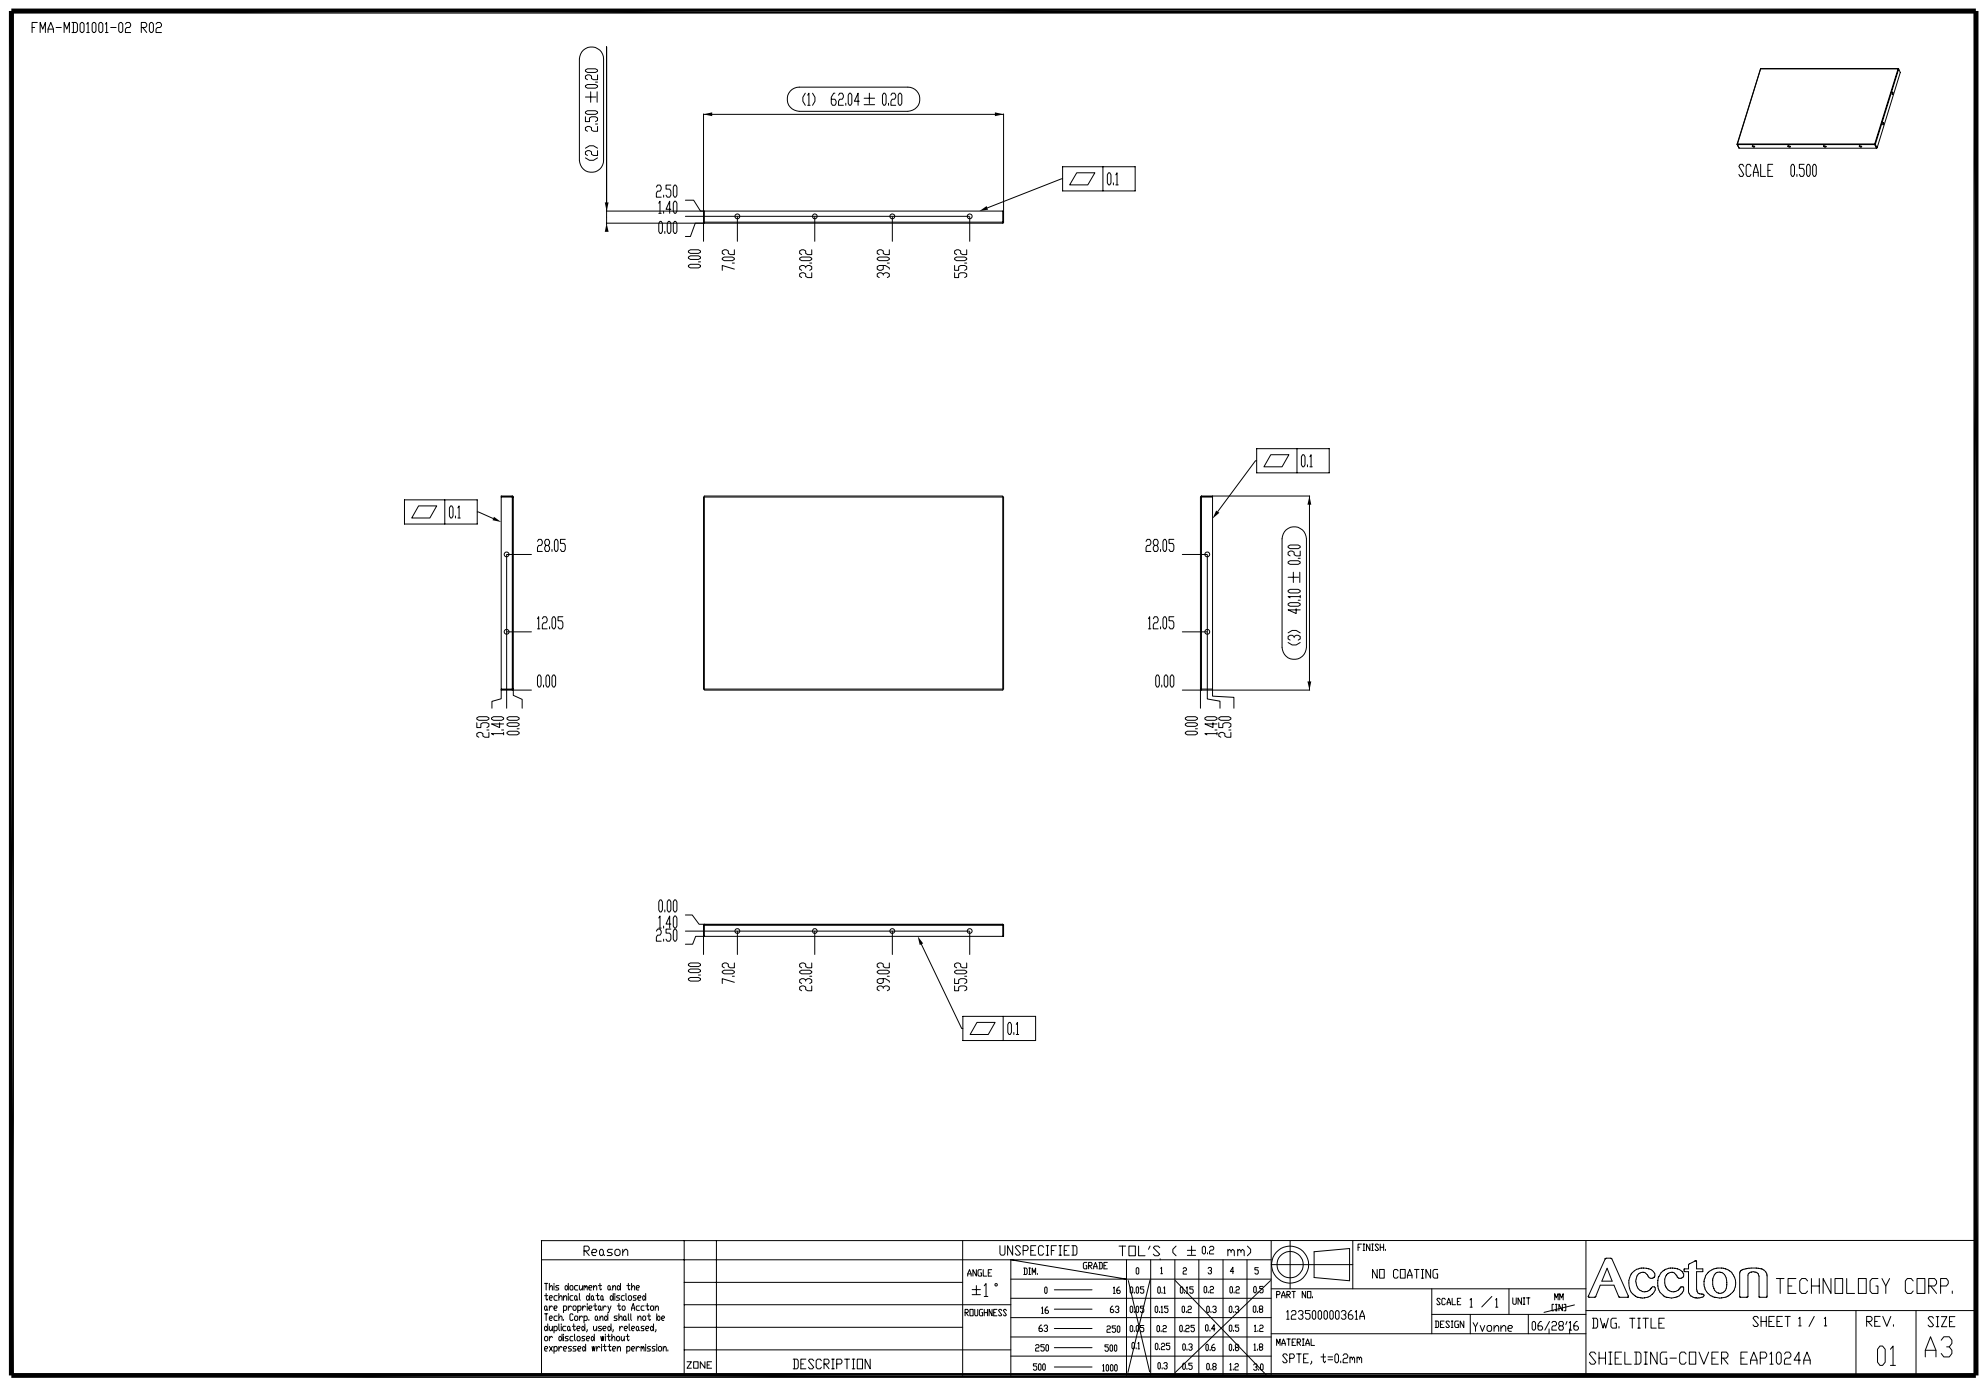
[picture p83: page 1]
