Mert-Eren-Karabulut/ECW7220-HardwareInfo/Hardware/5GHz board/schematic/bcm43460_r01_20140721_v0_rffm45.pdf

# 11ac 3X3 Mini PCIe Card

EAP1028B_FLF_ZZ | R01
Version | Date | Change Descripton
R0A | | This schematic is based on bcm943460MC5 P355 design 2013/08/15
R01 | 2014/06/25 | Chnage discription from R0A to R01

# FMA-HW01008-01 R01

## This document and the technical data disclosed are proprietary to Accton

Tech. Corp. and shall not be duplicated,

## used, released, or disclosed without

expressed written permission.

Model Name

Size Page Name

Rev

Date: | Sheet | of

## Making Partnership Work

Engineer

Accton Inc.

C

Tuesday, August 12, 2014 | 1 | 7
Title Page | | Erick Chen

Accton Inc.

Tuesday, August 12, 2014 | 1 | 7
Title Page | | Erick Chen

Accton Inc.

Tuesday, August 12, 2014 | 1 | 7
Title Page | | Erick Chen

# HPF : HIGH PASS FILTER PDET : POWER DETECTOR

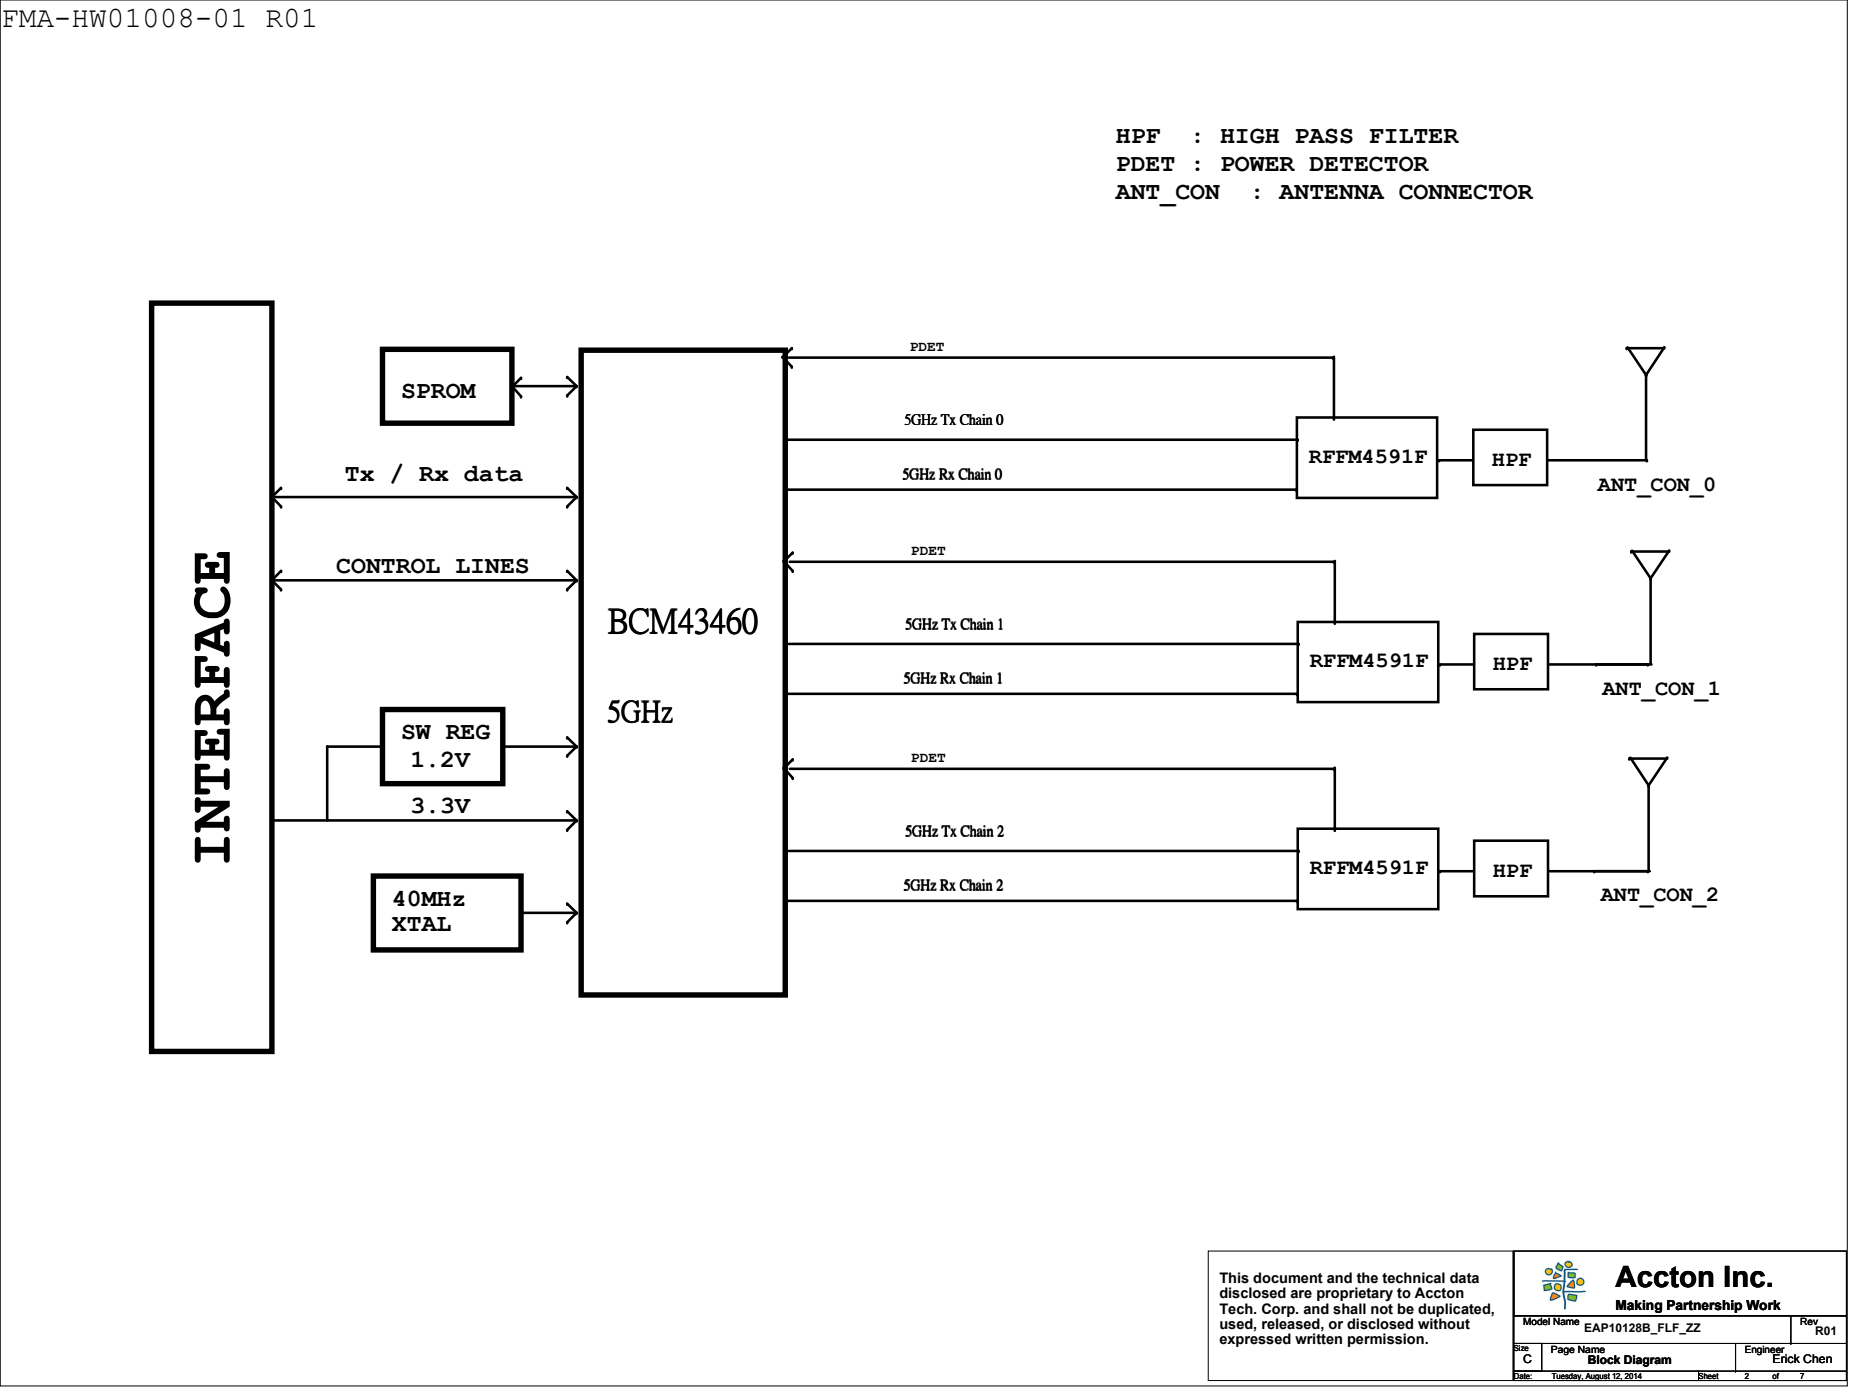
[picture p55: page 2]
INTERFACE; ANT_CON : ANTENNA CONNECTOR; BCM43460; SPROM; 5GHz; CONTROL LINES; 40MHz XTAL; SW REG 1.2V; HPF; 5GHz Tx Chain 0; EAP10128B_FLF_ZZ; ANT_CON_1; ANT_CON_2; PDET; RFFM4591F; 5GHz Tx Chain 1; 5GHz Rx Chain 1; 5GHz Tx Chain 2; 5GHz Rx Chain 2; Accton Inc.; Tuesday, August 12, 2014; Block Diagram; Erick Chen

Tx / Rx data

ANT_CON_0 ⁵GHz Rx Chain 0

This document and the technical data

# B0 strapping option

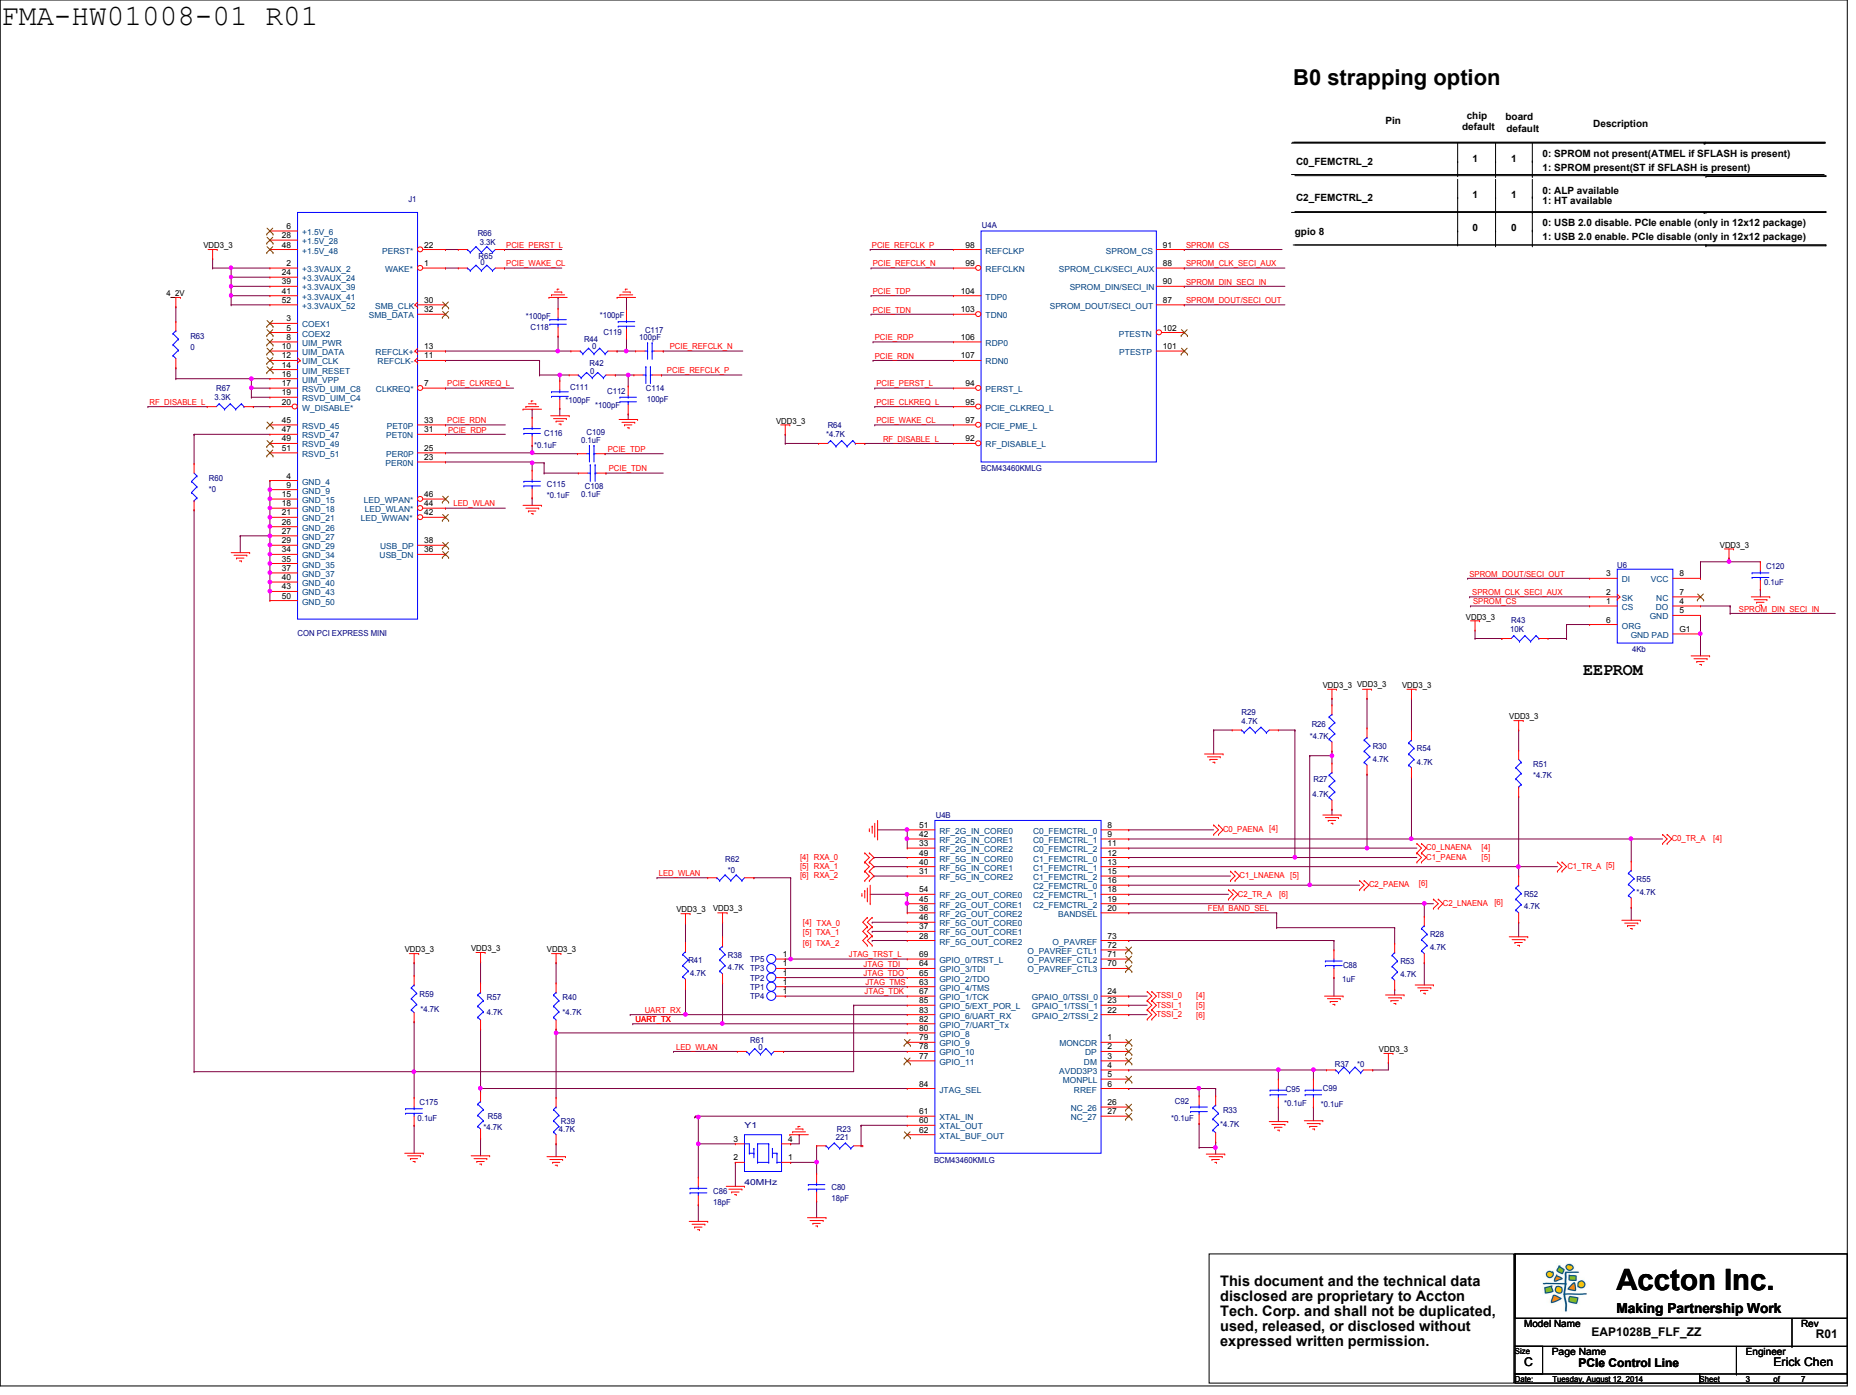
[picture p56: page 3]

1 0: SPROM not present(ATMEL if SFLASH is present)

1: SPROM present(ST if SFLASH is present)

0 0: USB 2.0 disable. PCIe enable (only in 12x12 package)

1: USB 2.0 enable. PCIe disable (only in 12x12 package)

CON PCI EXPRESS MINI

This document and the technical data

## Antenna A0

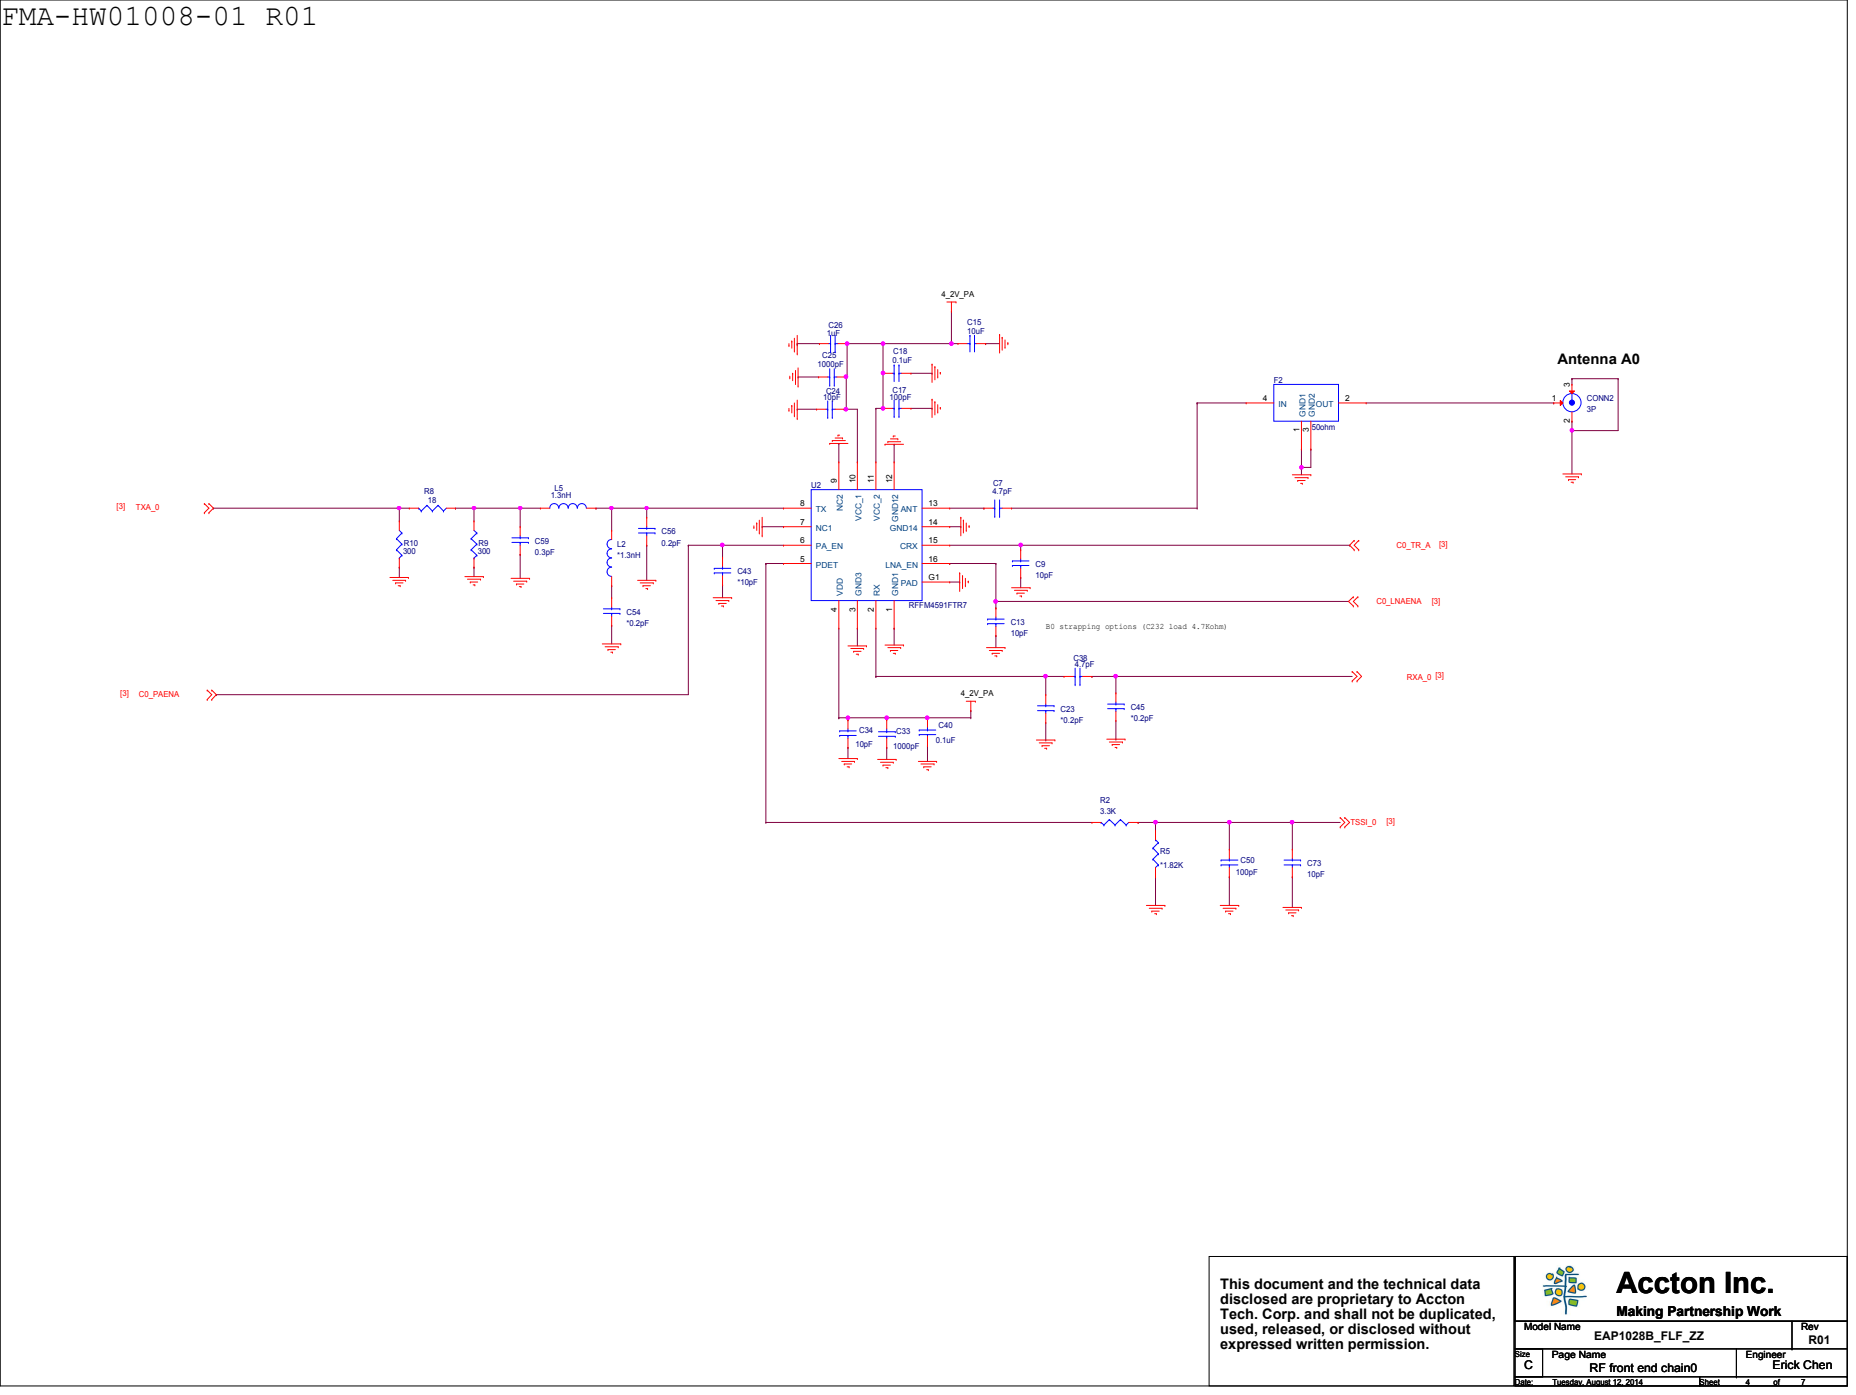
[picture p57: page 4]

This document and the technical data

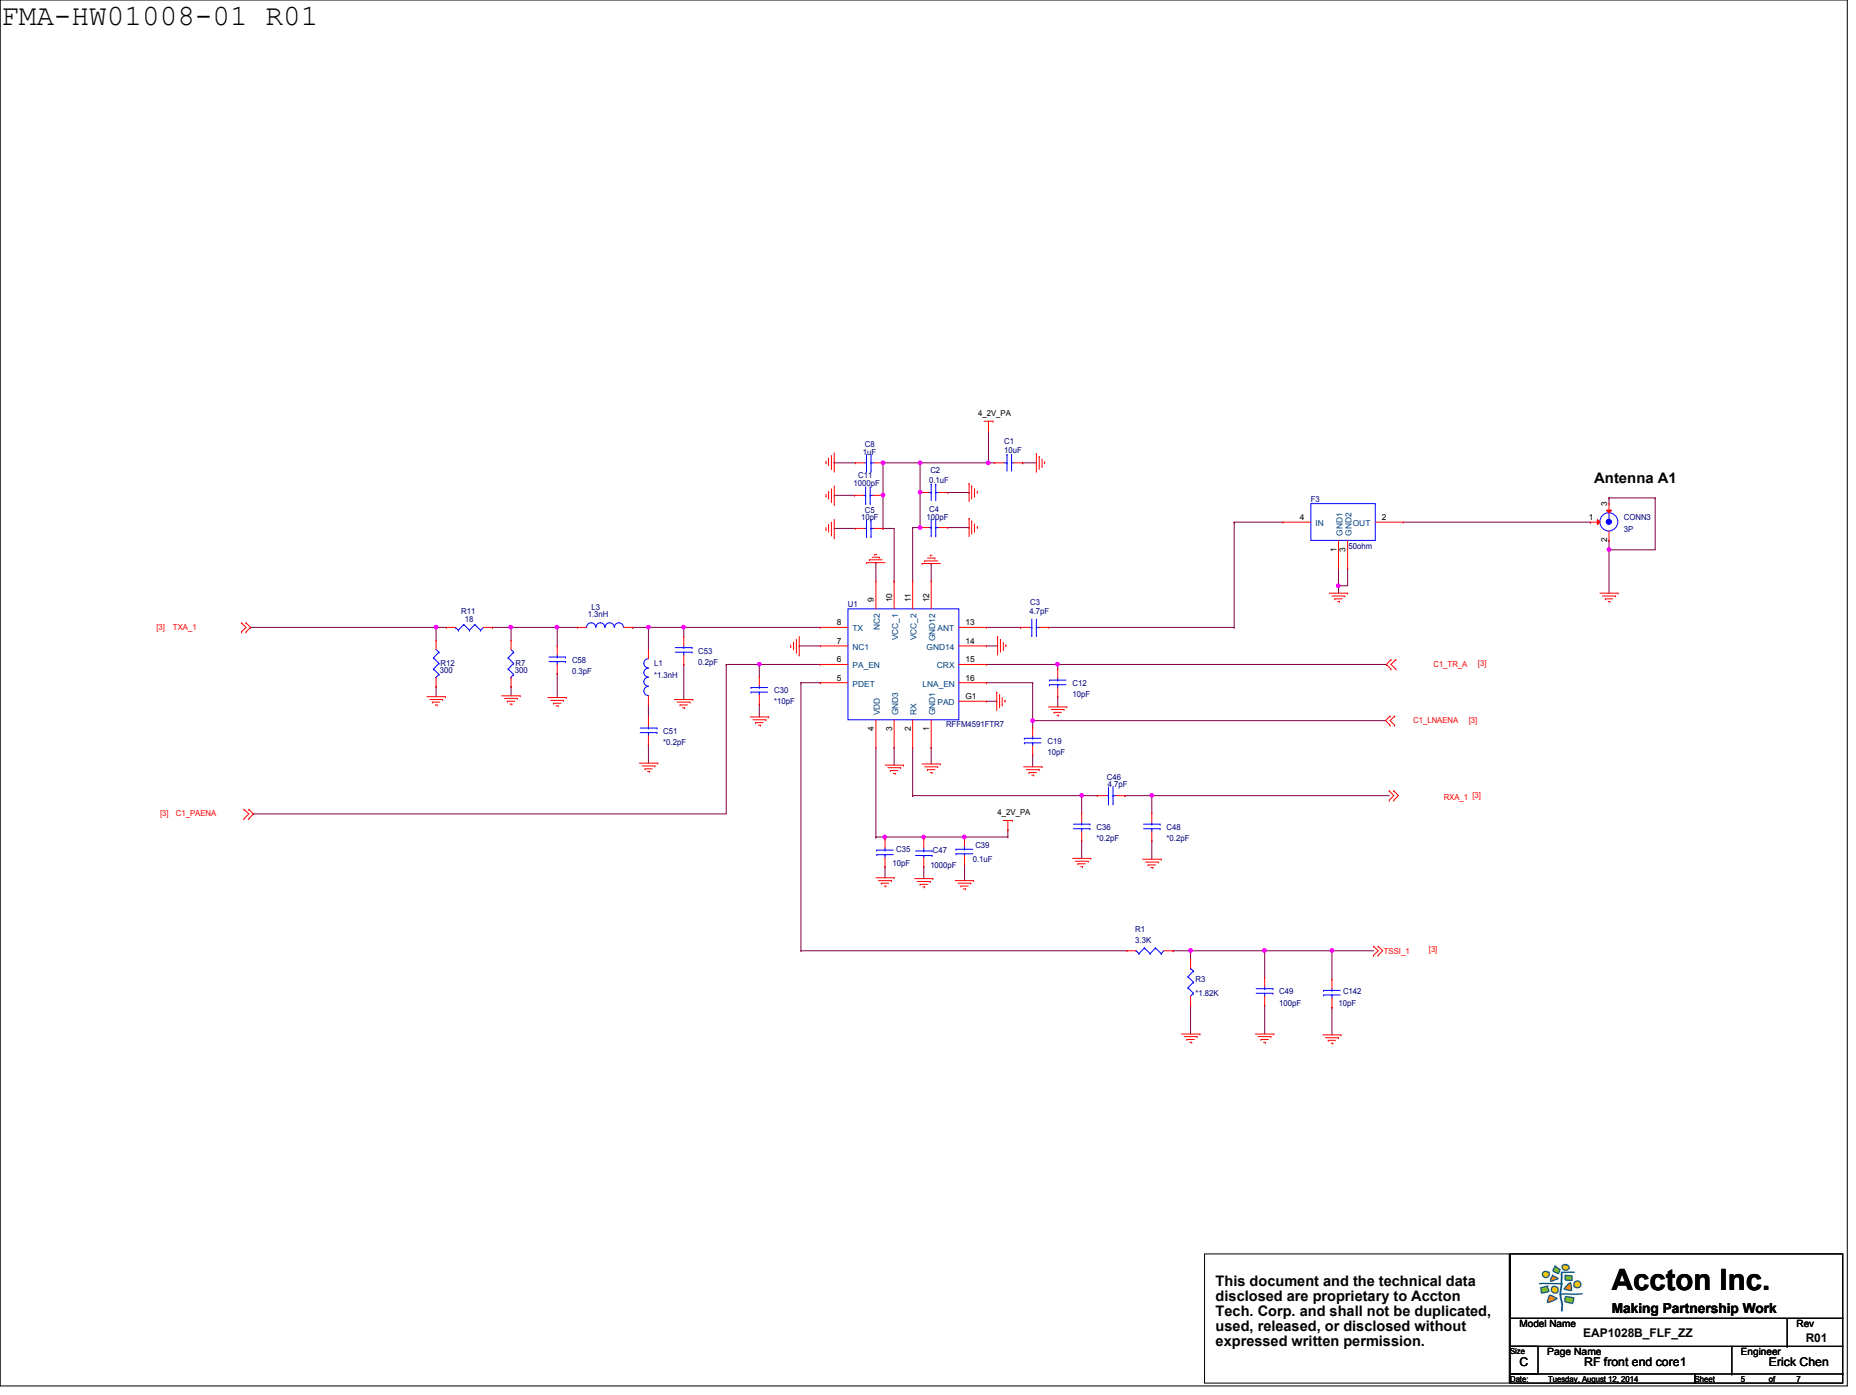
[picture p58: page 5]

This document and the technical data

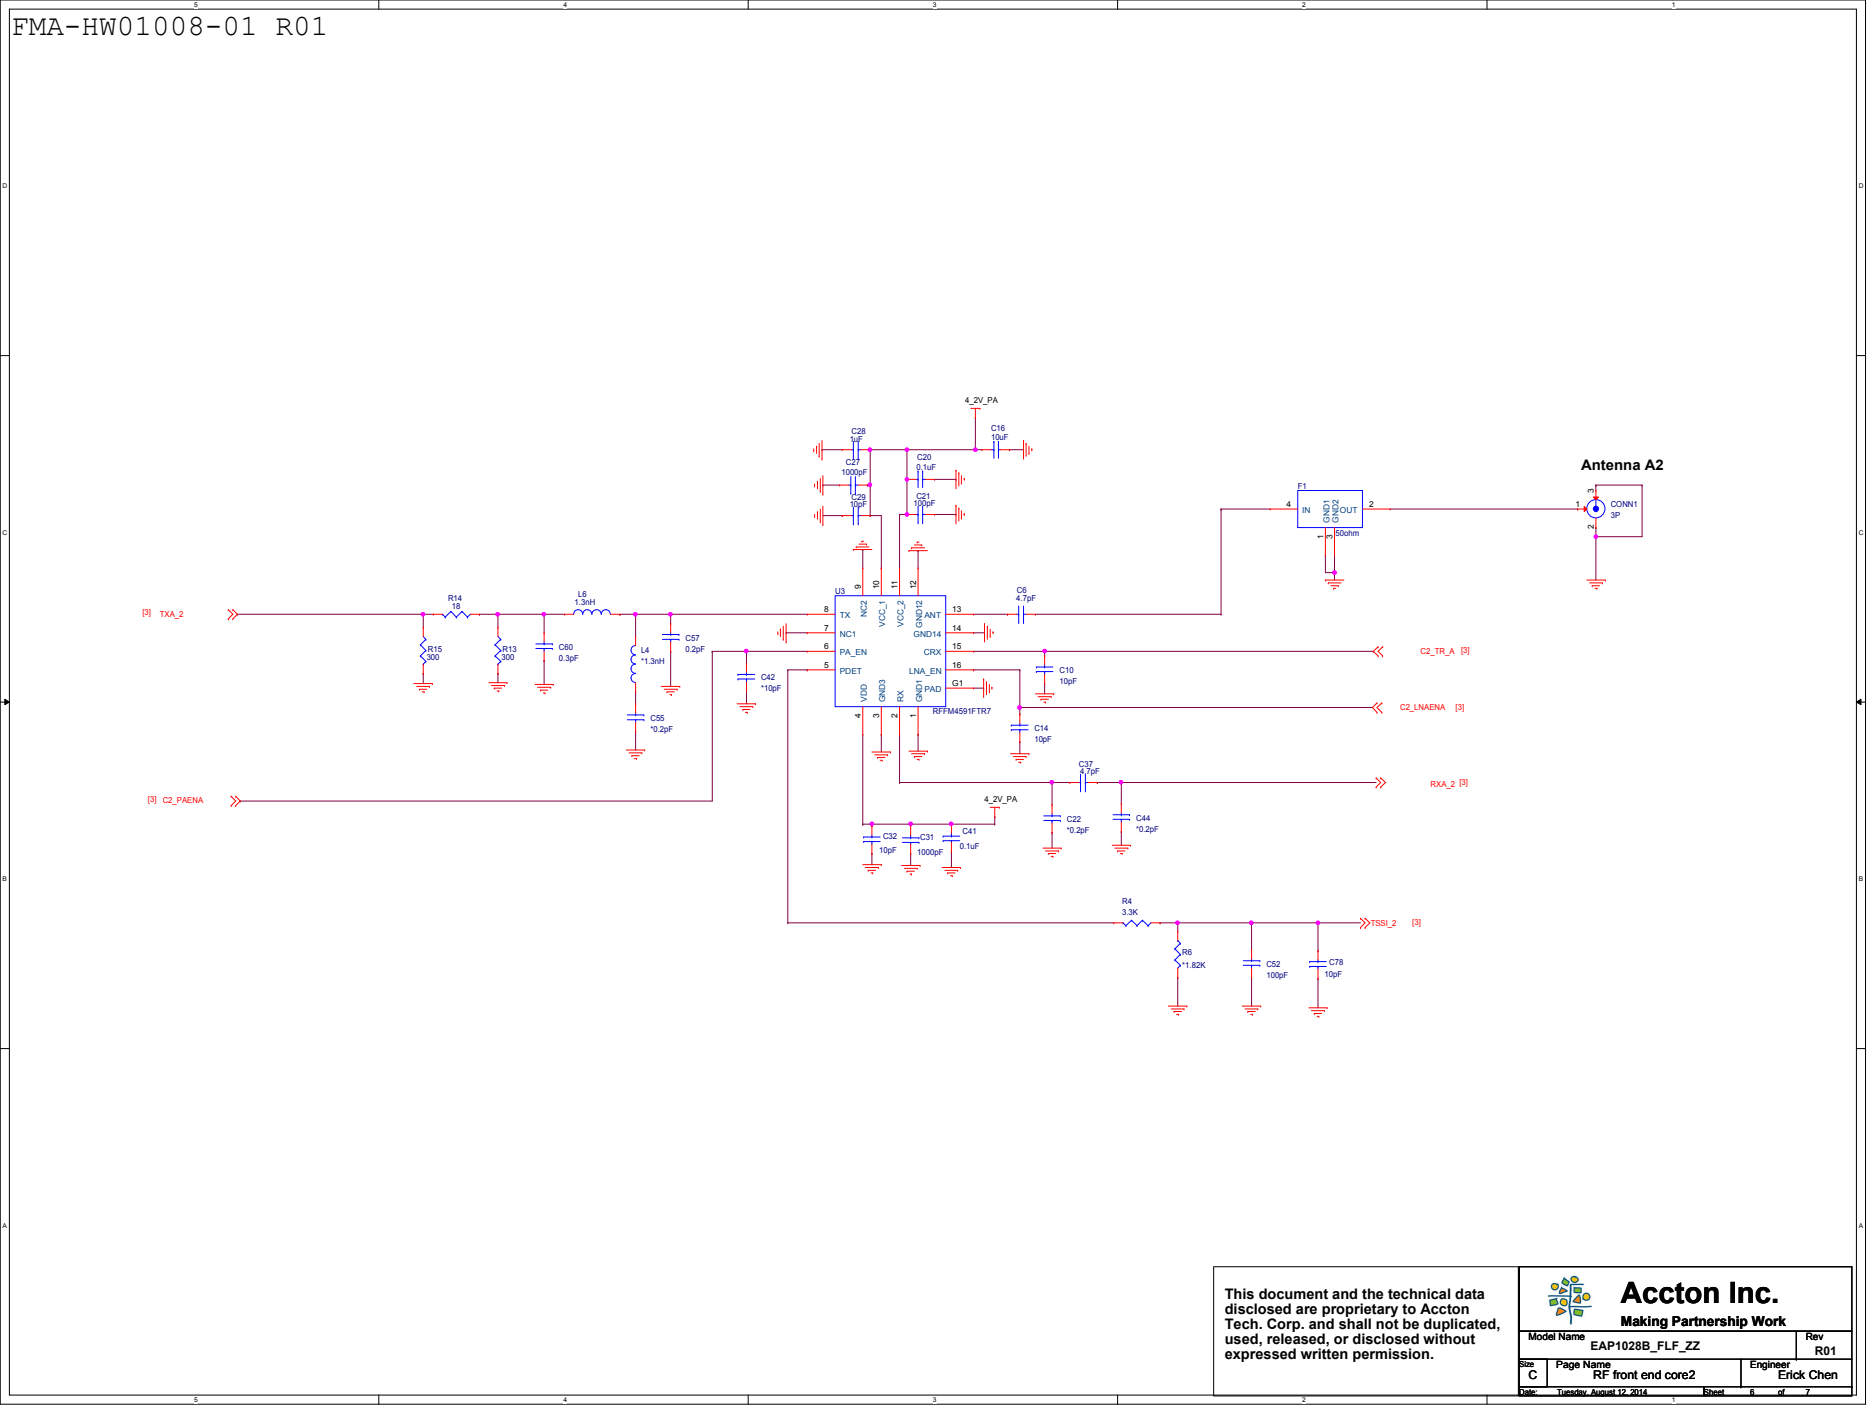
[picture p59: page 6]

This document and the technical data

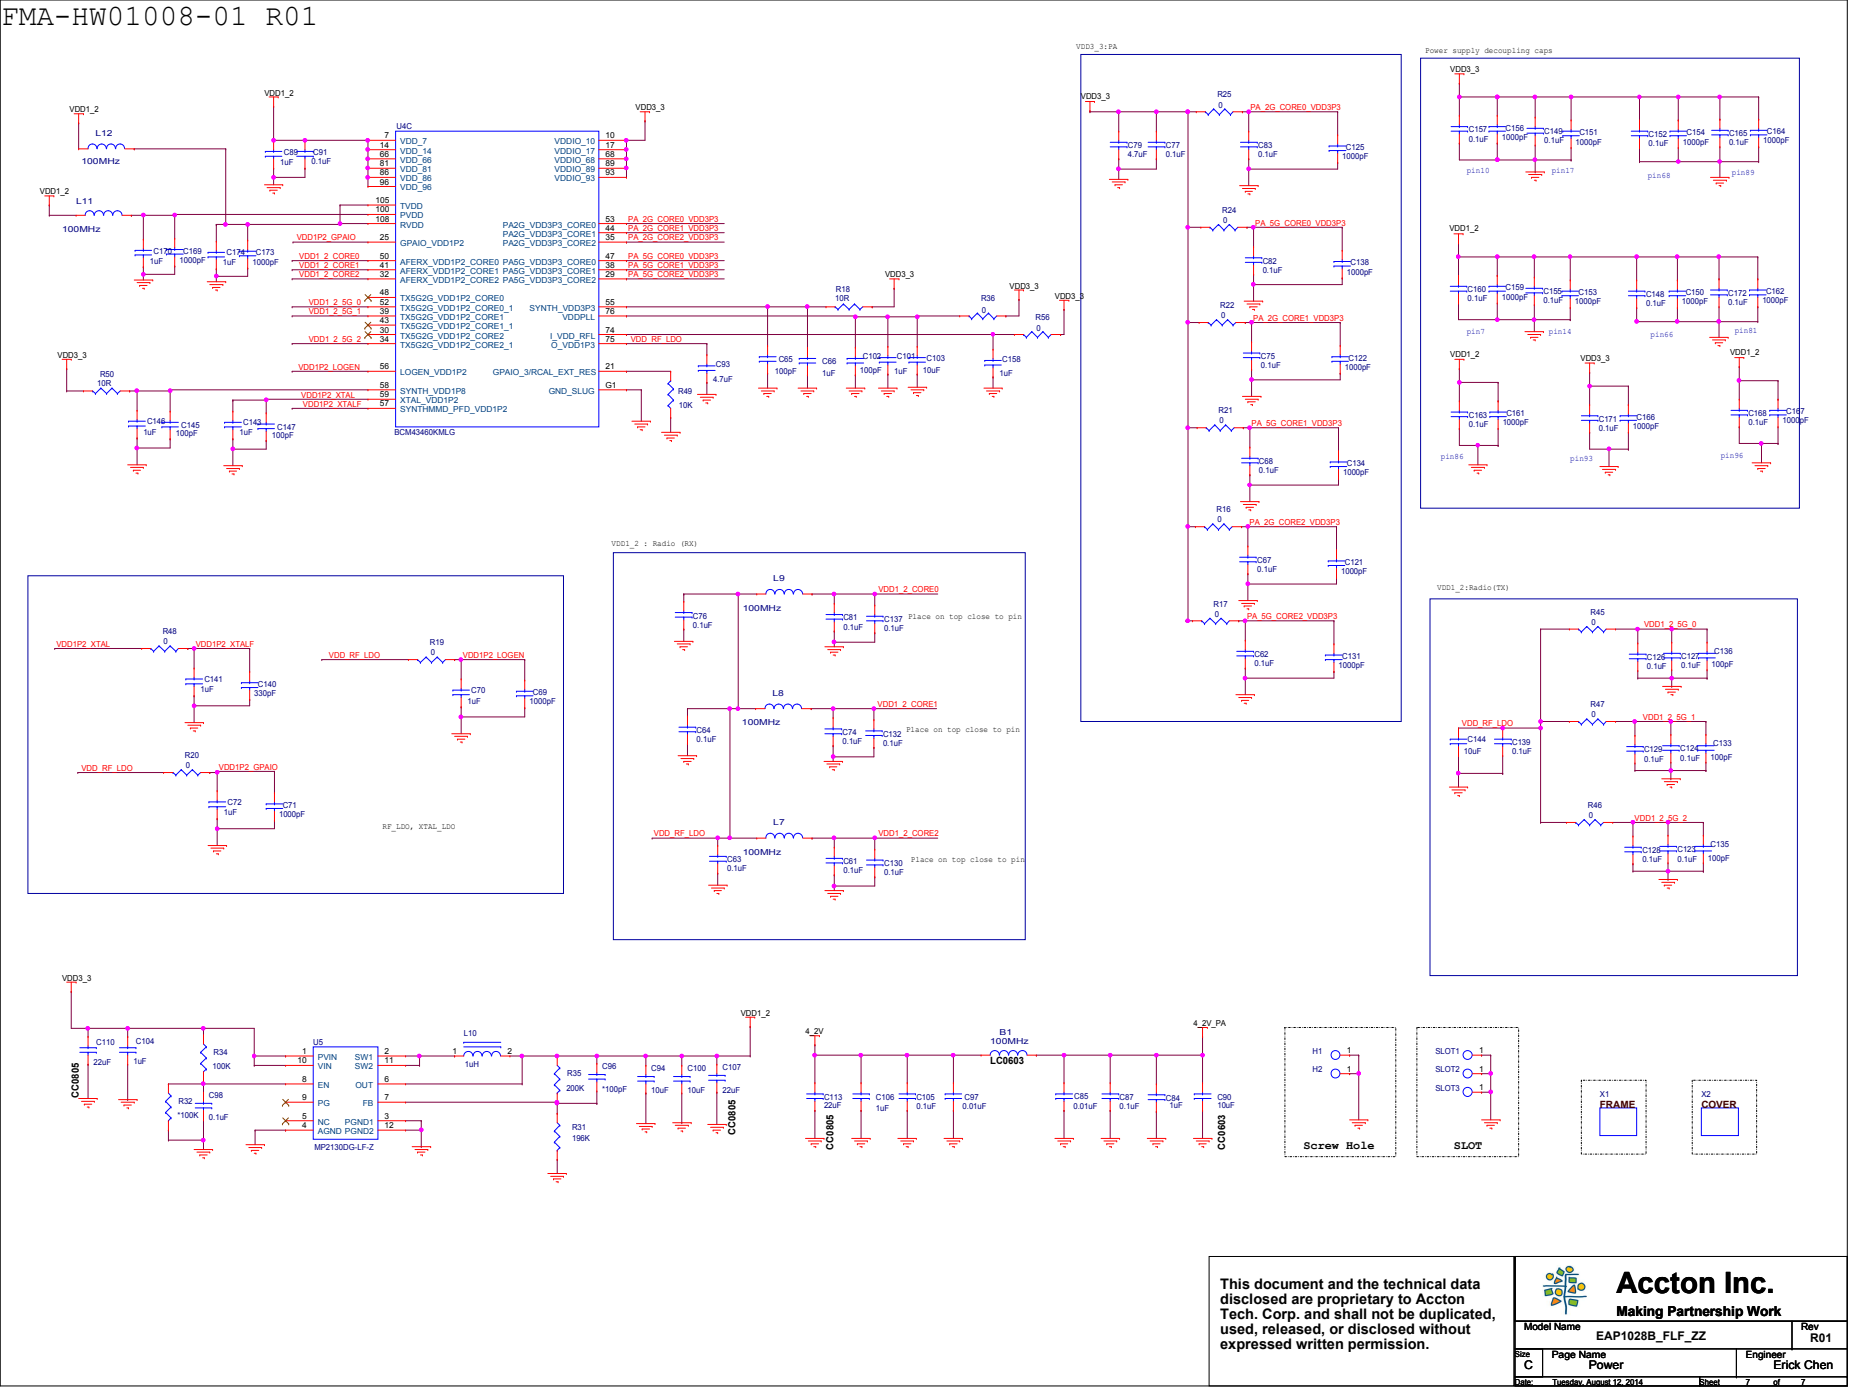
[picture p60: page 7]

Place on top close to pin

This document and the technical data
