Mert-Eren-Karabulut/ECW7220-HardwareInfo/Hardware/Main board/schematic/EAP1028B-12-0115-38_20160107_14.pdf

### REVISION HISTORY

Version | Date | Change Description

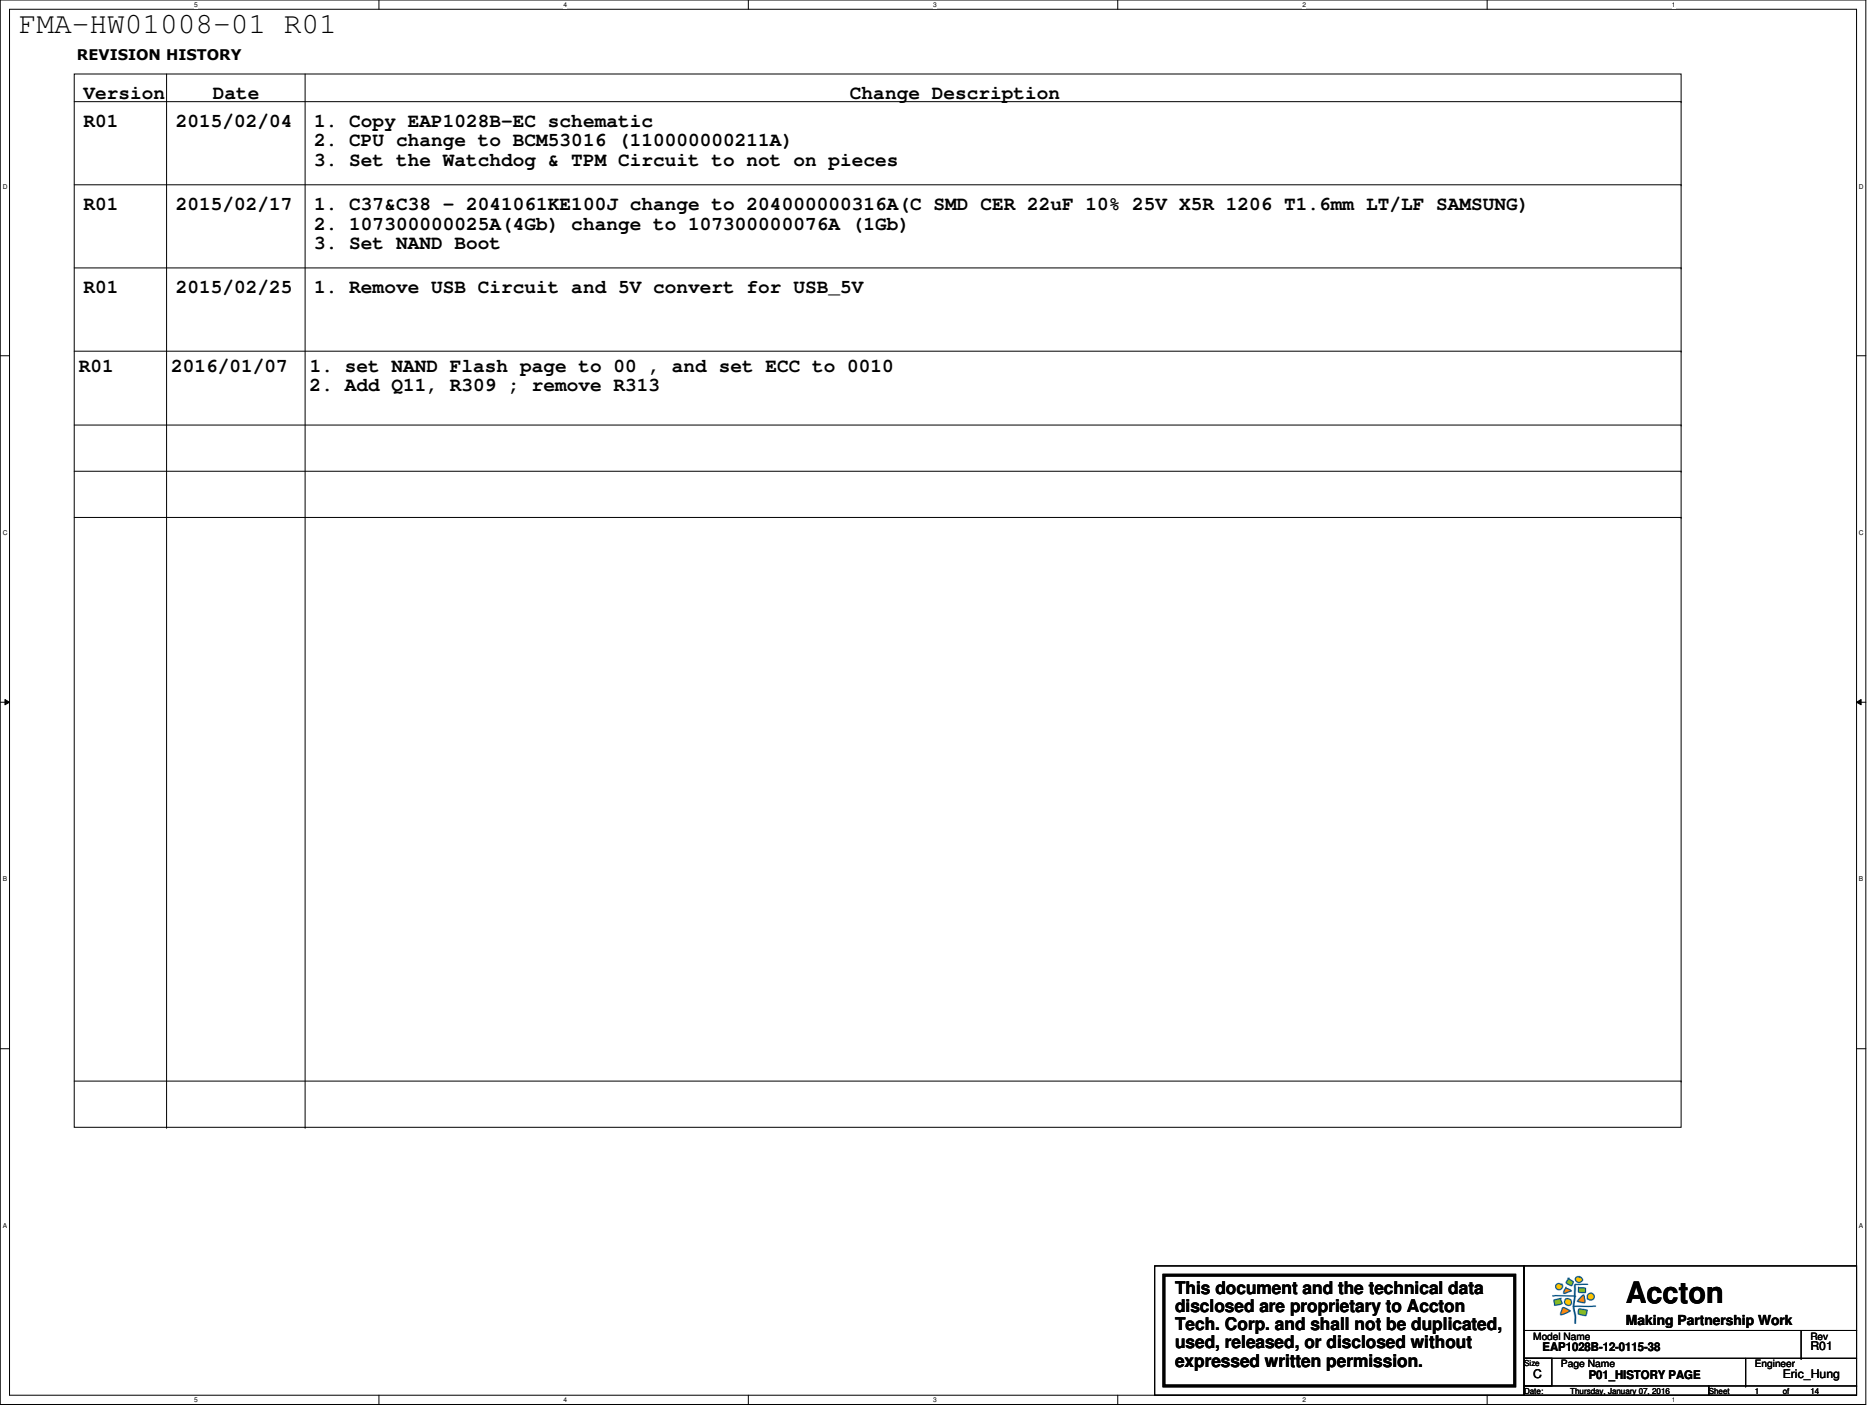
[picture p61: page 1]
FMA-HW01008-01 R01; 1. Copy EAP1028B-EC schematic 2015/02/04; 1. Remove USB Circuit and 5V convert for USB_5V; 1. set NAND Flash page to 00 , and set ECC to 0010; 2. Add Q11, R309 ; remove R313; Model Name; Size; Page Name; Rev; Date:; Sheet; Engineer; Thursday, January 07, 2016; EAP1028B-12-0115-38; P01_HISTORY PAGE; Eric_Hung

2. CPU change to BCM53016 (110000000211A)
3. Set the Watchdog & TPM Circuit to not on pieces

1. C37&C38 - 2041061KE100J change to 204000000316A(C SMD CER 22uF 10% 25V X5R 1206 T1.6mm LT/LF SAMSUNG)
2. 107300000025A(4Gb) change to 107300000076A (1Gb)
3. Set NAND Boot

Accton This document and the technical data disclosed are proprietary to Accton

Tech. Corp. and shall not be duplicated,
used, released, or disclosed without
expressed written permission.

Making Partnership Work

# USB2.0

# LEDs

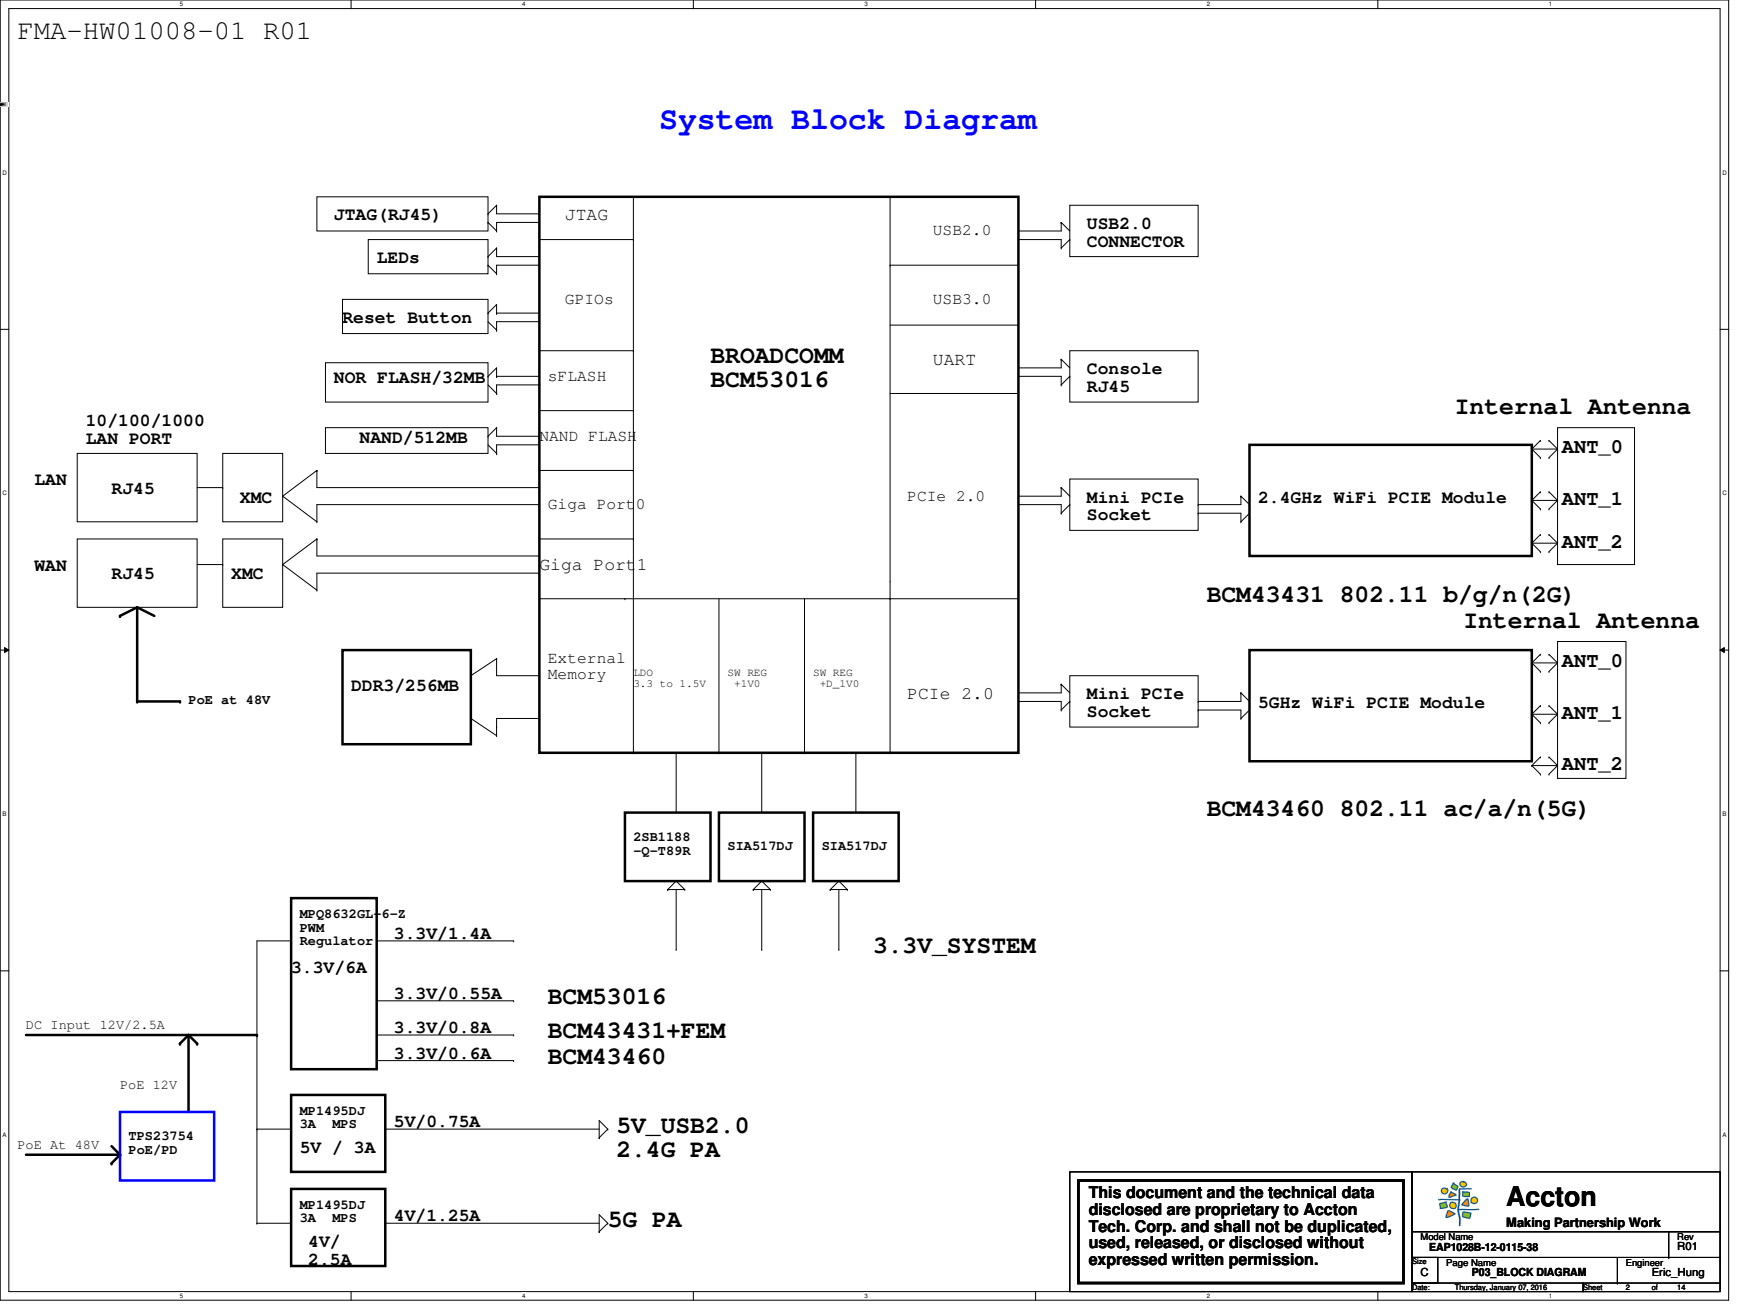
[picture p62: page 2]
PoE 12V; PoE At 48V; TPS23754 PoE/PD; DC Input 12V/2.5A; BCM53016; BCM43431+FEM; BCM43460; Internal Antenna; PoE at 48V; Mini PCIe Socket; sFLASH; Console RJ45; ANT_0; ANT_2; GPIOs; LAN; WAN; MPQ8632GL-6-Z PWM Regulator; MPS; ANT_1; NAND/512MB; NAND FLASH; Giga Port0; External Memory; Giga Port1; PCIe 2.0; SIA517DJ; BROADCOMM BCM53016; JTAG(RJ45); NOR FLASH/32MB; 10/100/1000 LAN PORT; JTAG; UART; XMC; DDR3/256MB; Reset Button; LDO 3.3 to 1.5V; SW REG +1V0; BCM43431 802.11 b/g/n(2G)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

System Block Diagram

2.4GHz WiFi PCIE Module

5GHz WiFi PCIE Module

Accton This document and the technical data disclosed are proprietary to Accton

# DC 12V input

# 12V to 5V for USB

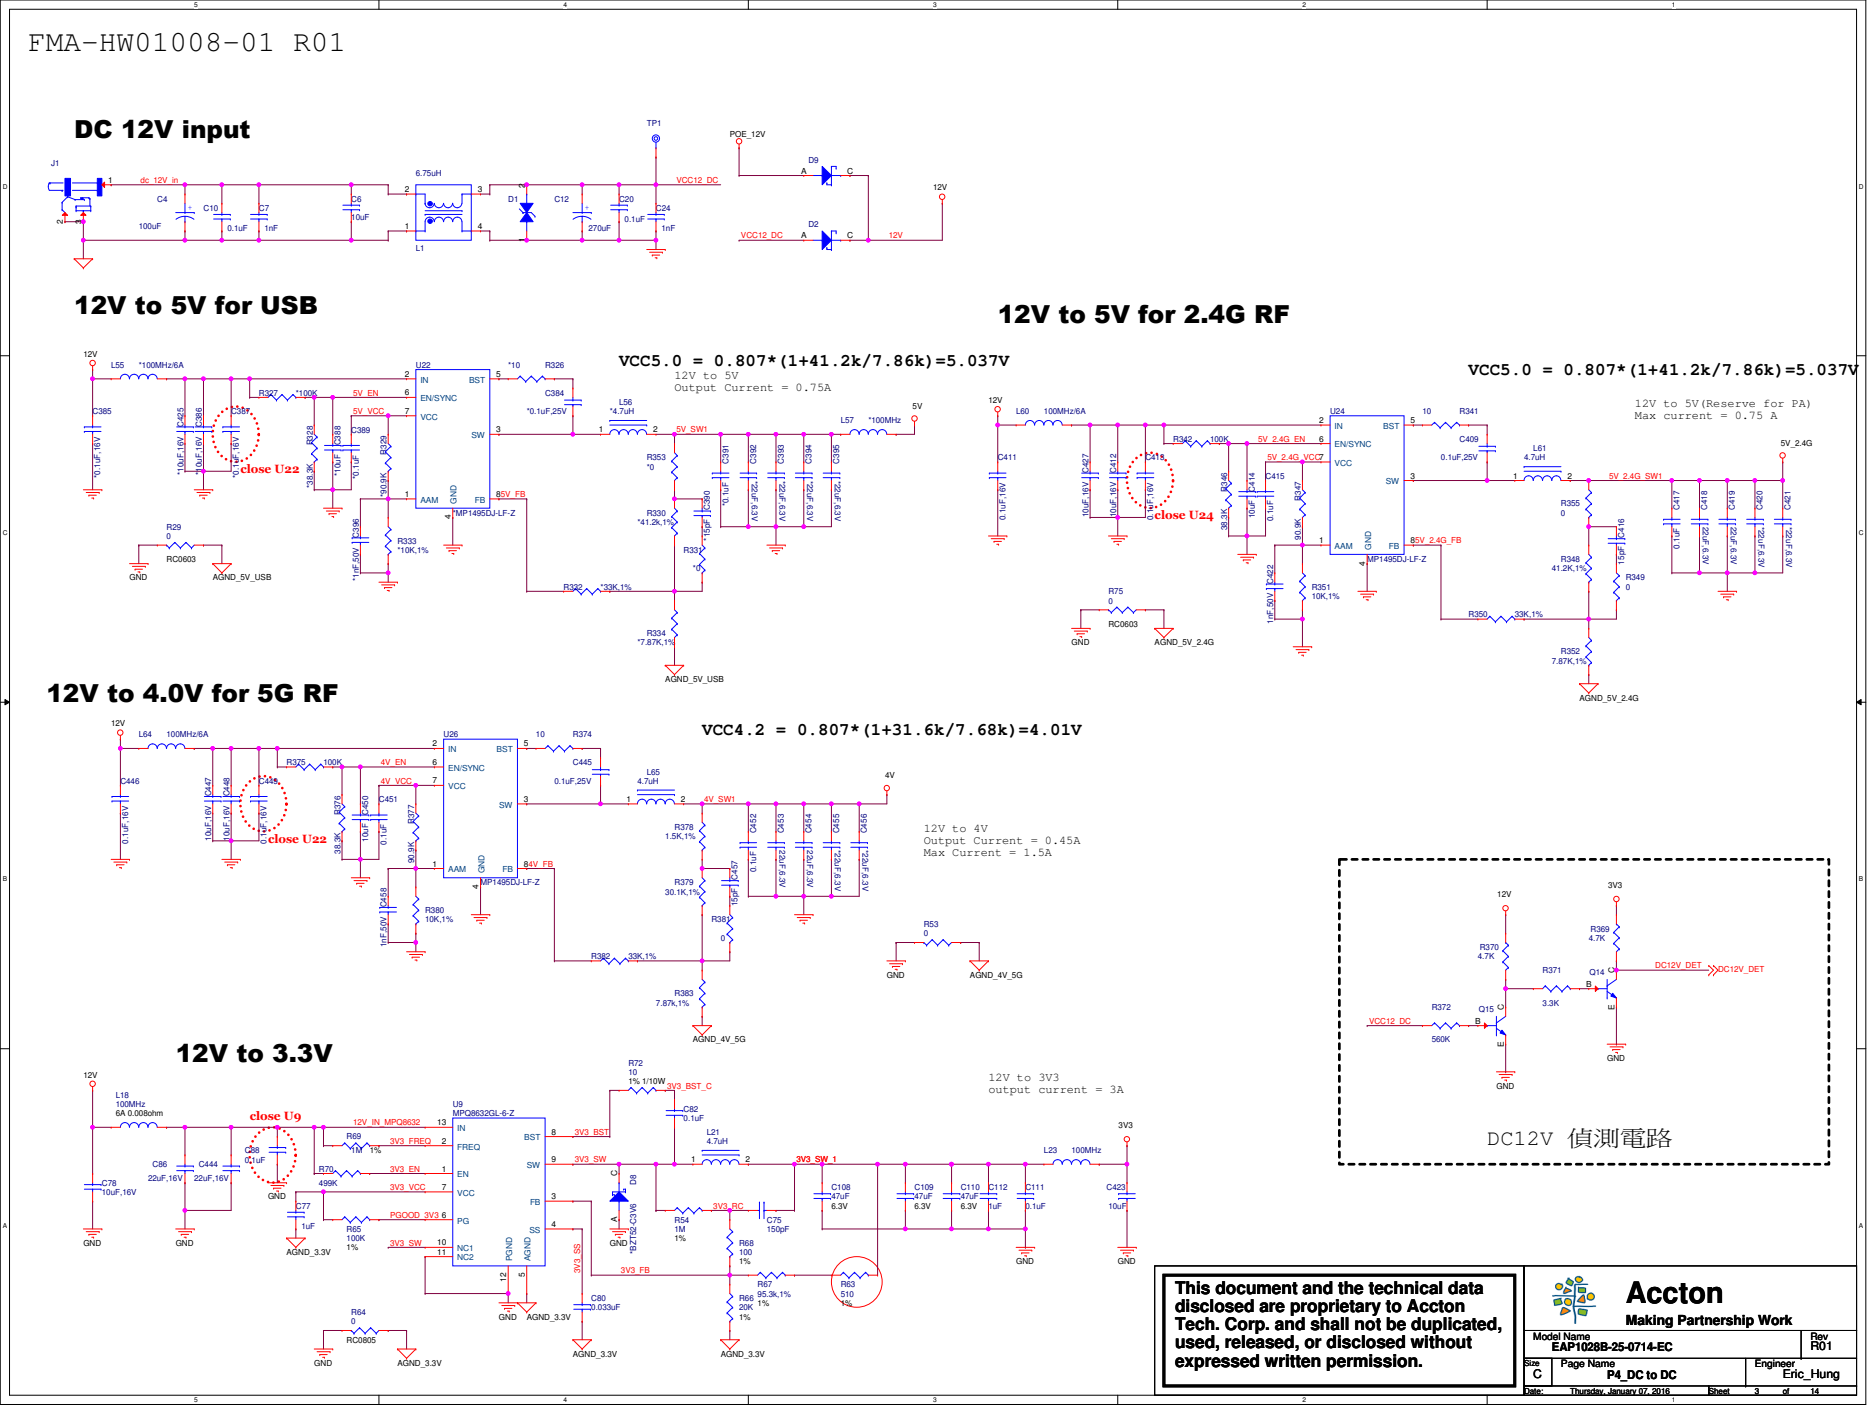
[picture p63: page 3]

12V to 5V(Reserve for PA)
Max current = 0.75 A

Accton This document and the technical data disclosed are proprietary to Accton

# NO Adaptor ORing

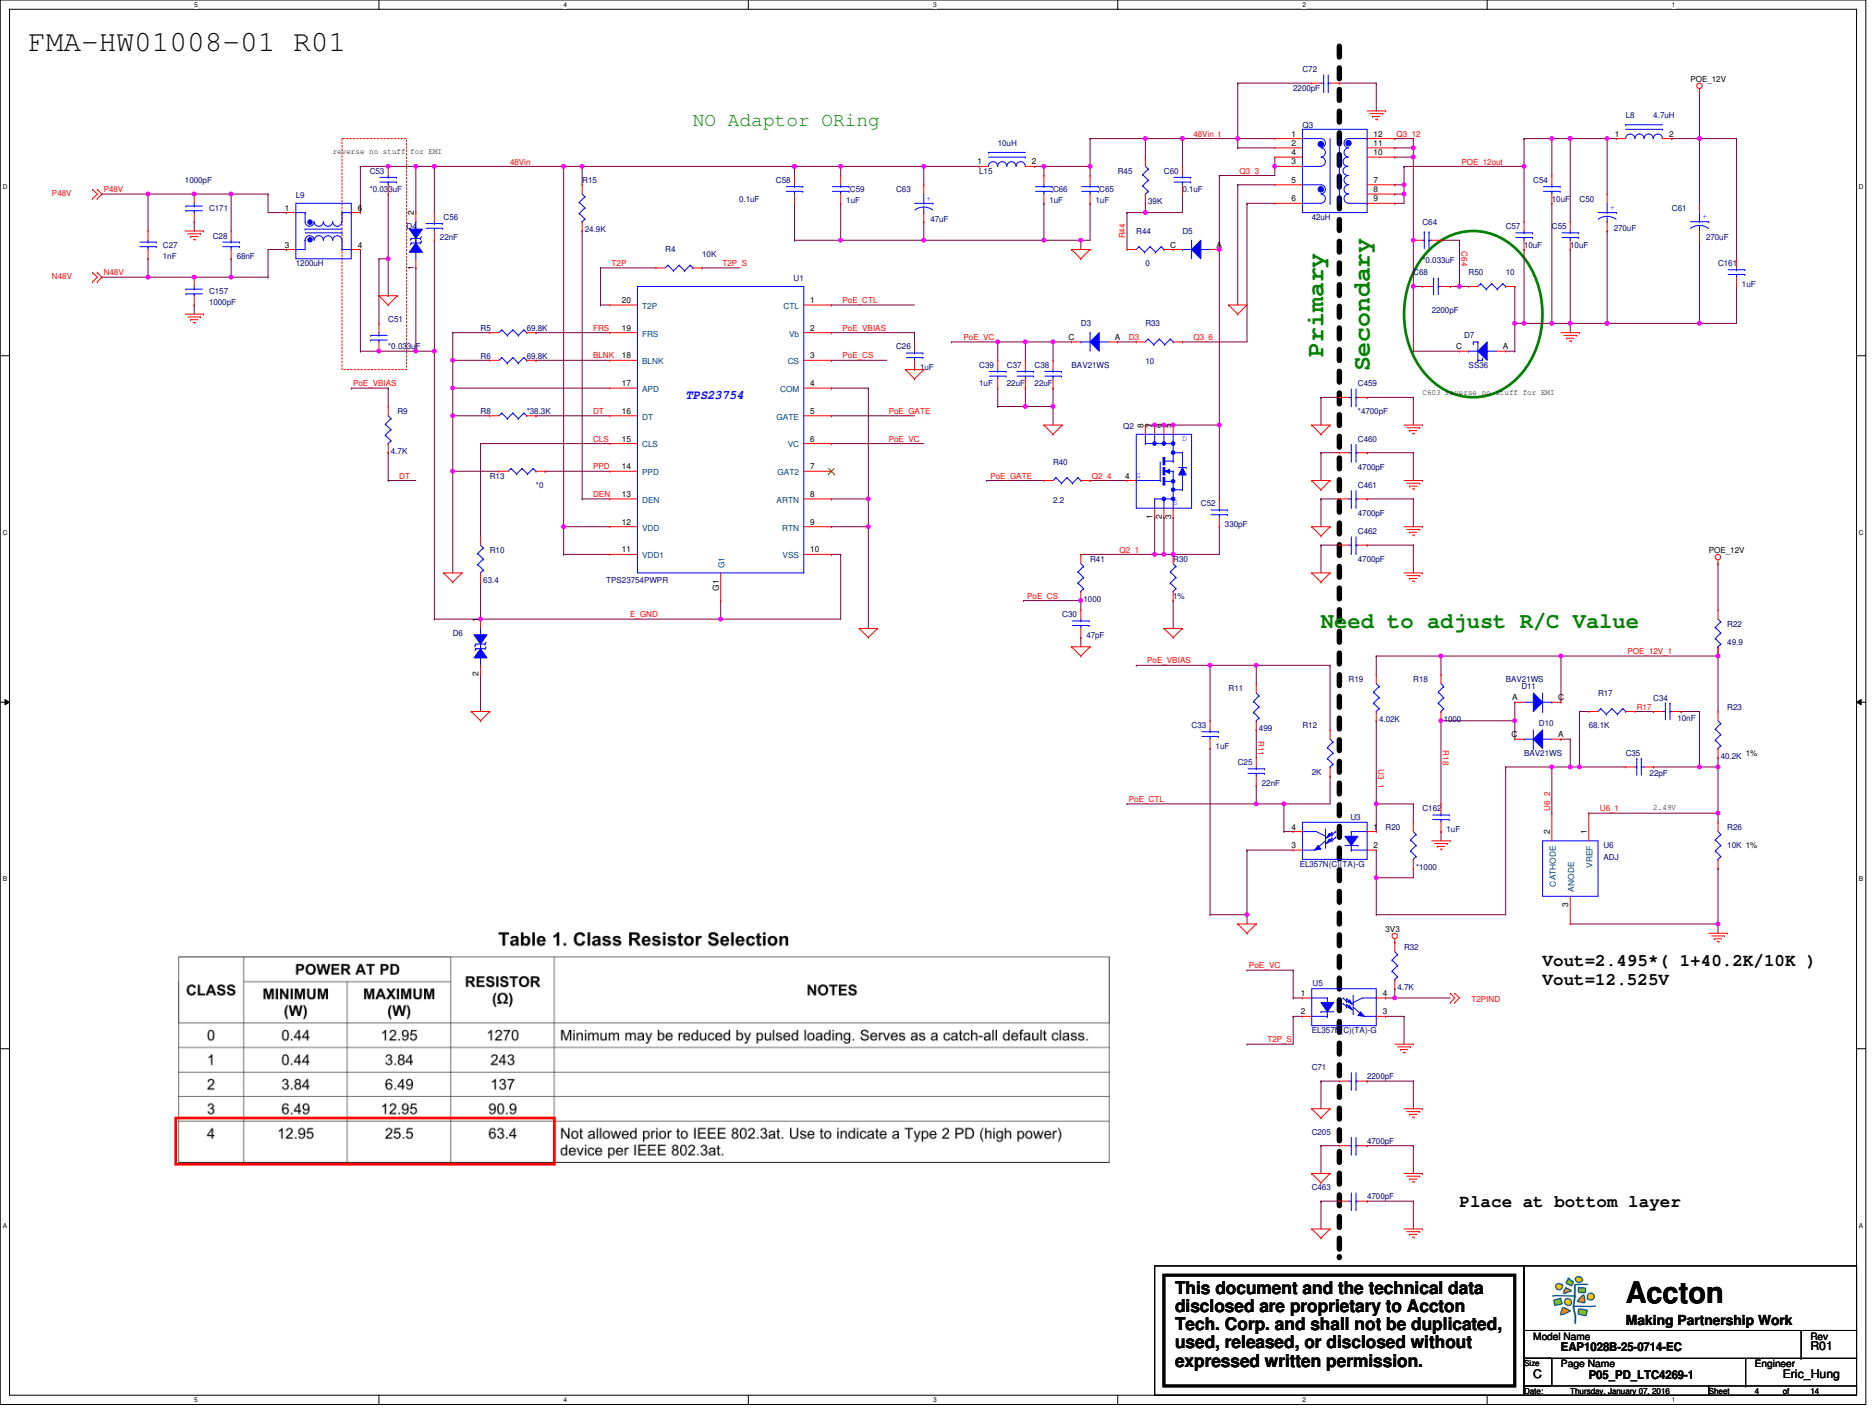
[picture p64: page 4]

reverse no stuff for EMI

C603 reverse no stuff for EMI

Need to adjust R/C Value

Place at bottom layer

Accton This document and the technical data disclosed are proprietary to Accton

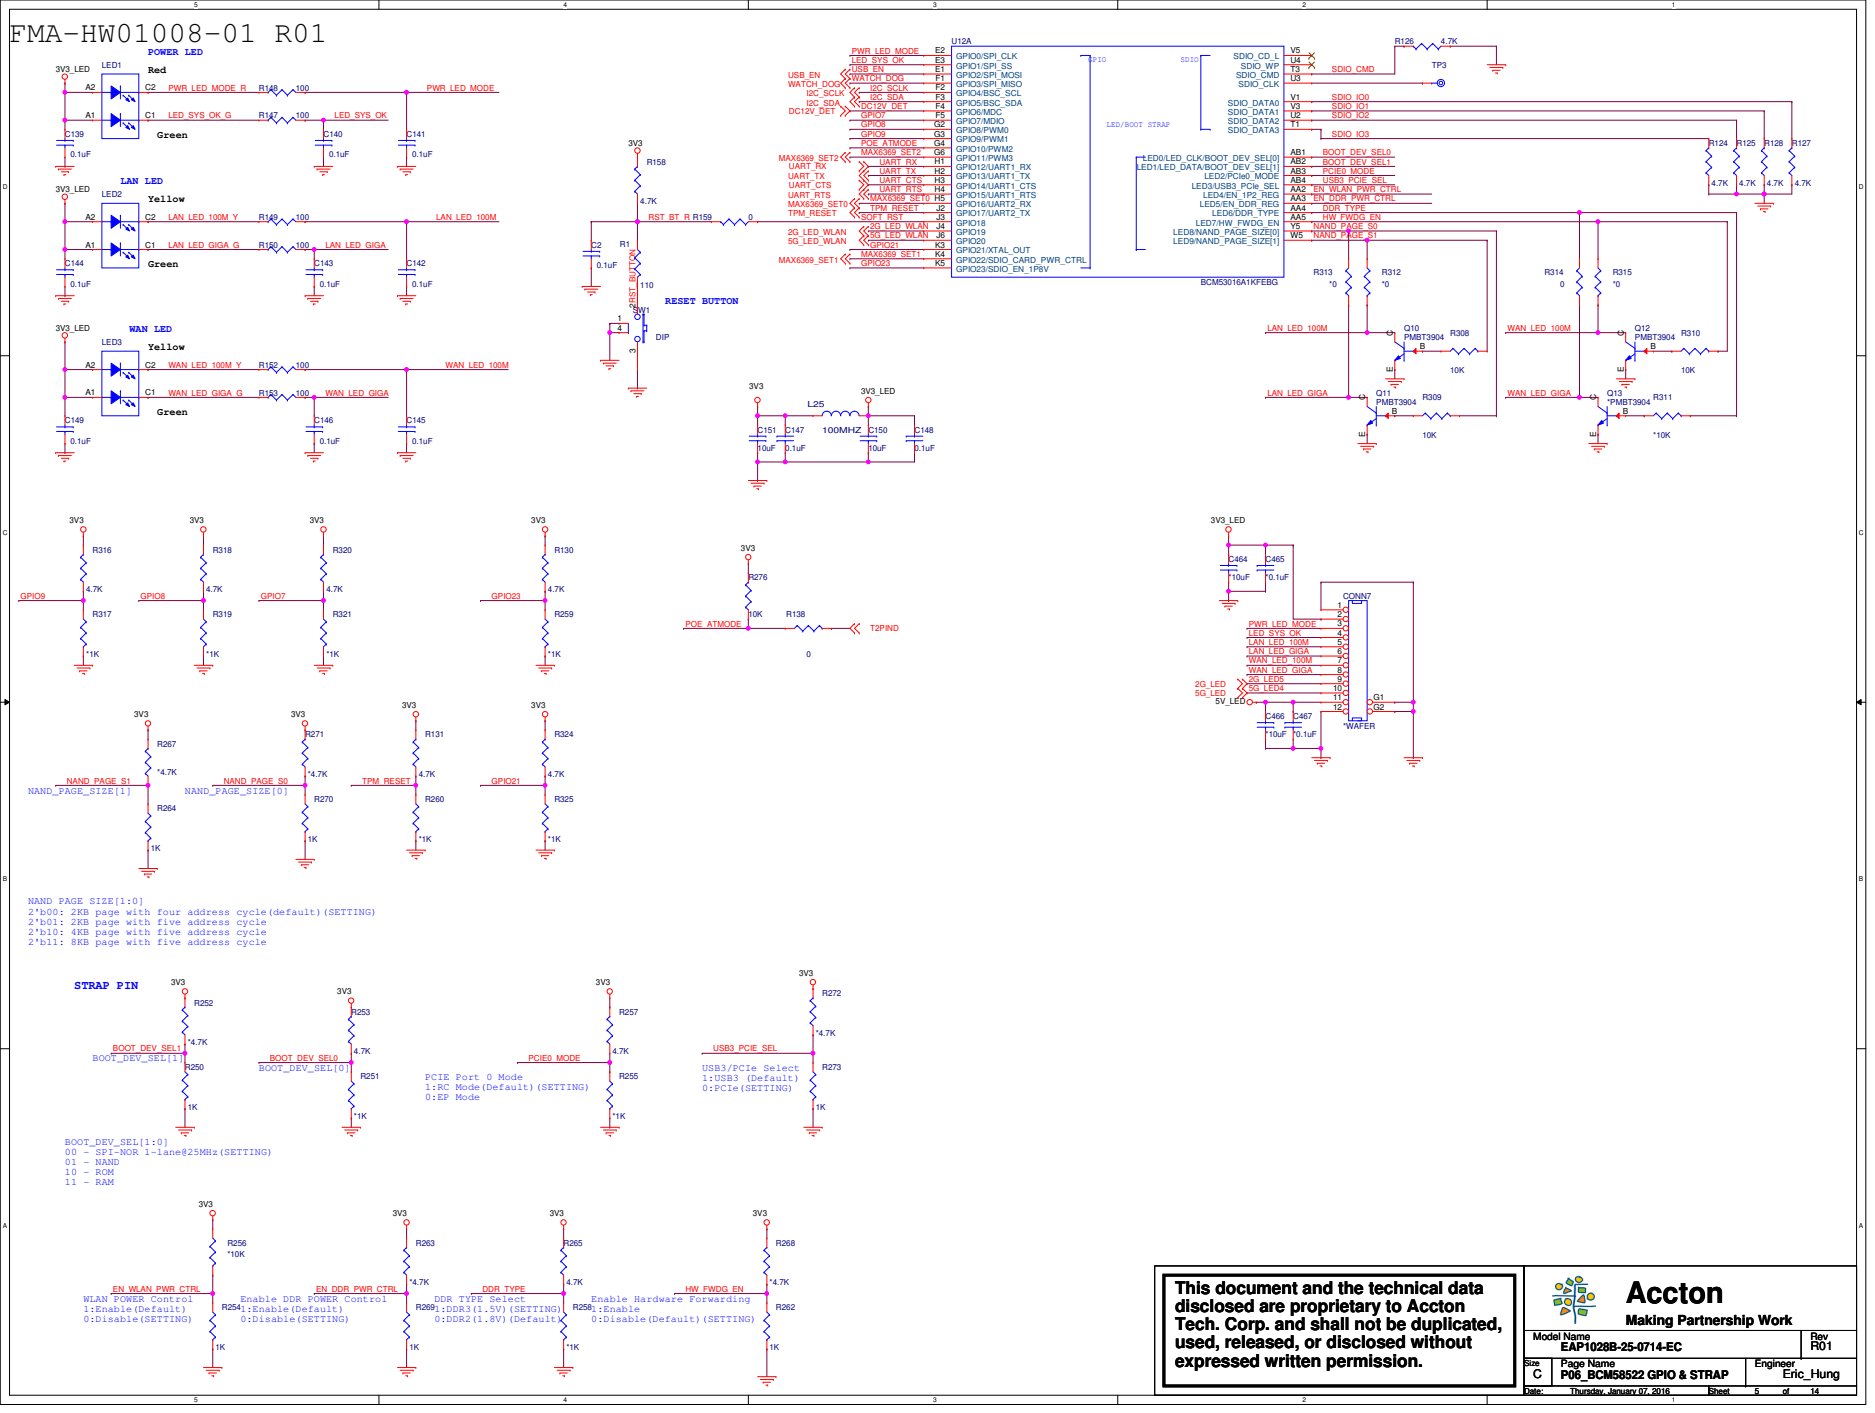
[picture p65: page 5]

NAND PAGE SIZE[1:0]
2'b00: 2KB page with four address cycle(default)(SETTING)
2'b01: 2KB page with five address cycle
2'b10: 4KB page with five address cycle
2'b11: 8KB page with five address cycle

PCIE Port 0 Mode
1:RC Mode(Default)(SETTING)
0:EP Mode

Accton This document and the technical data disclosed are proprietary to Accton

Enable DDR POWER Control
1:Enable(Default)
0:Disable(SETTING)

## Differential Pair Trace Impedance = 100 Ohm

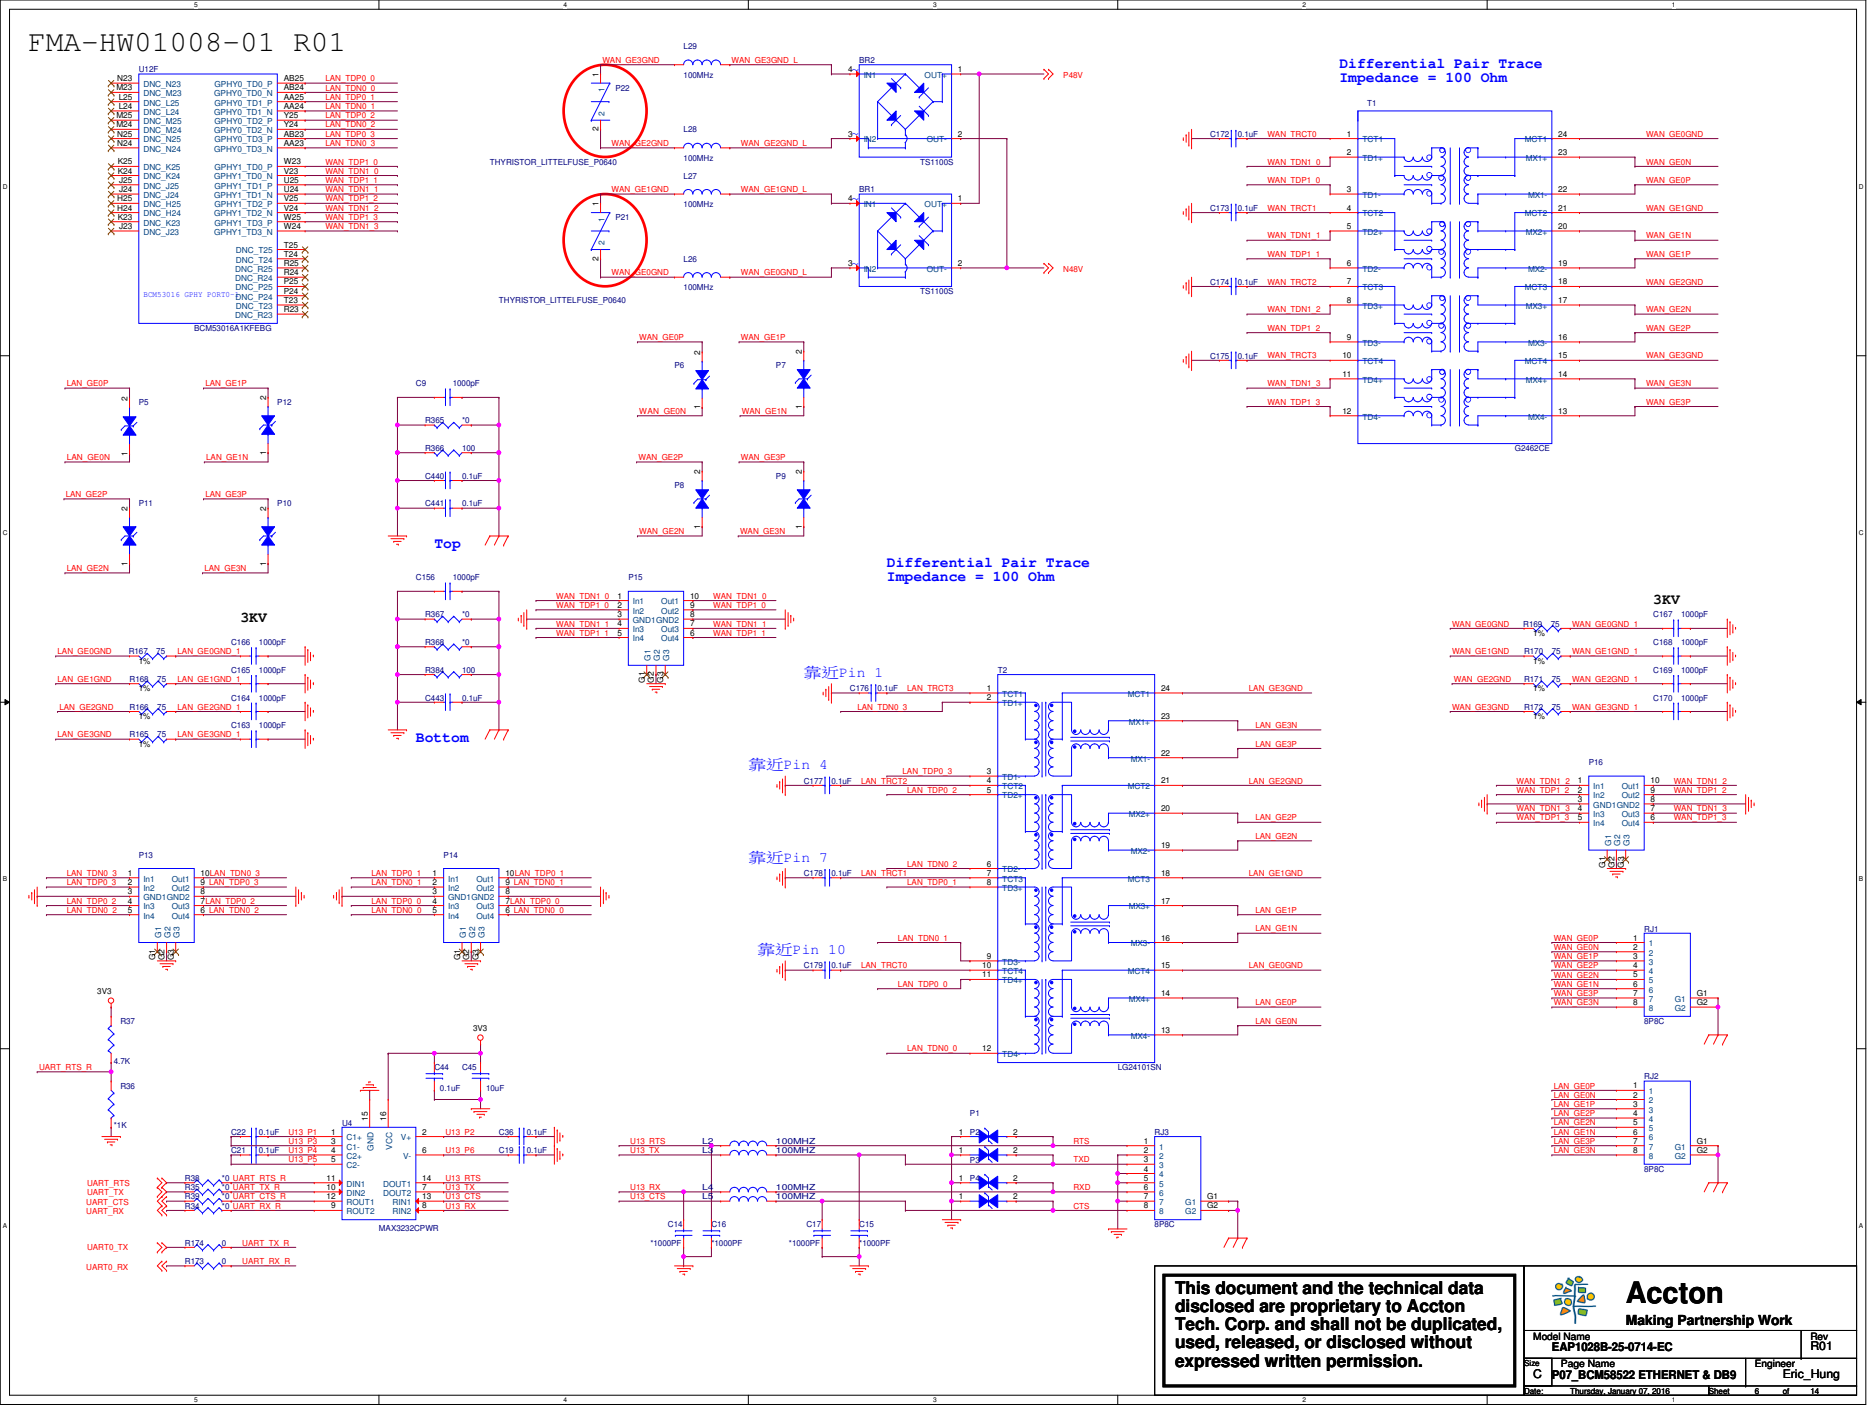
[picture p66: page 6]

Accton This document and the technical data disclosed are proprietary to Accton

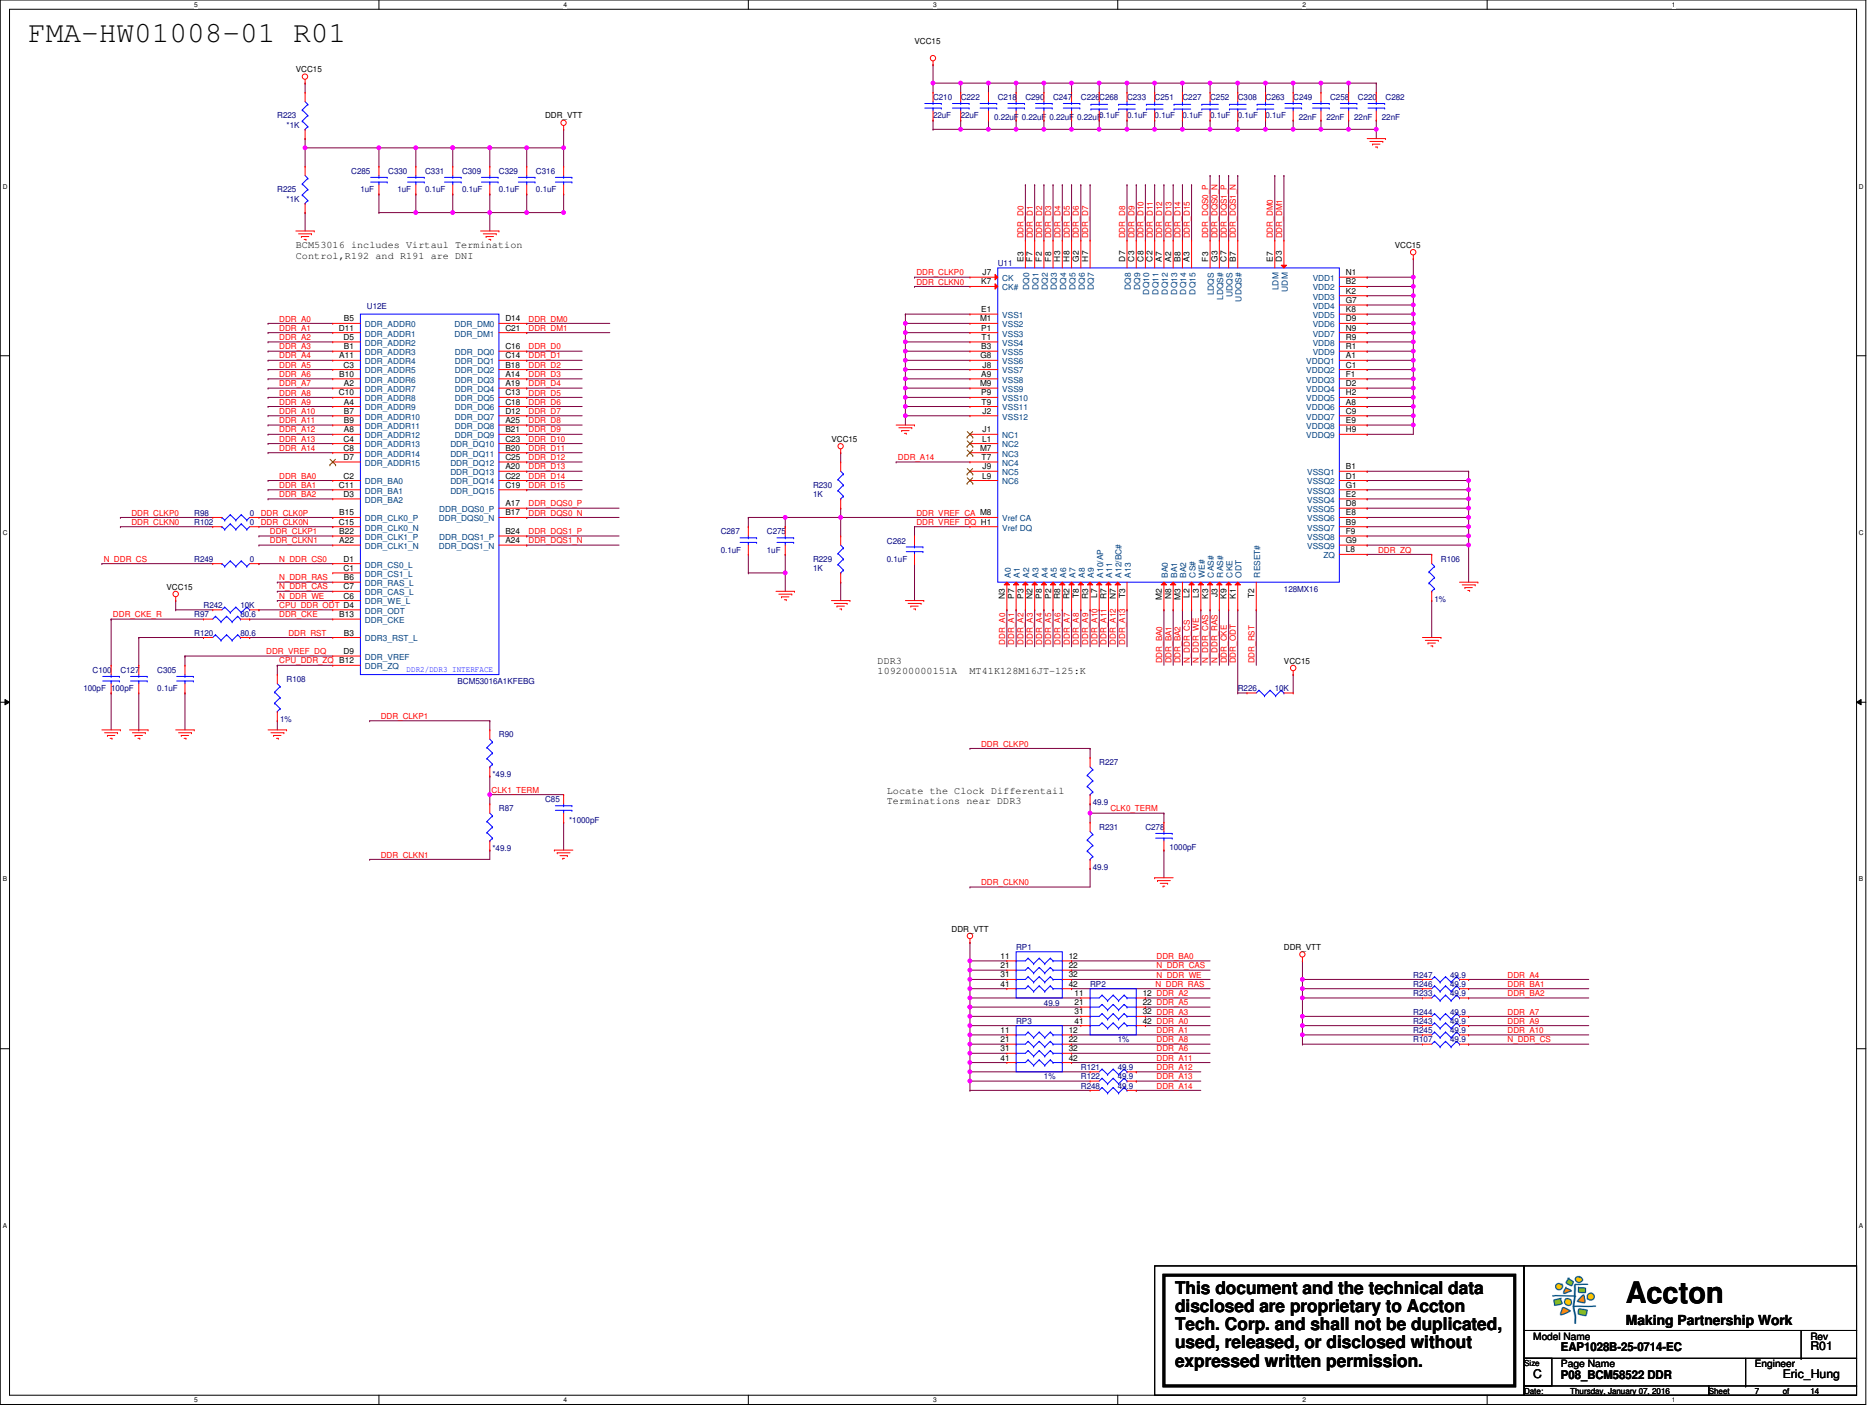
[picture p67: page 7]

BCM53016 includes Virtaul Termination
Control,R192 and R191 are DNI

Locate the Clock Differentail
Terminations near DDR3

Accton This document and the technical data disclosed are proprietary to Accton

CPU_PCIECLK_N | R_CPU_PCIECLK_N R_CPU_PCIECLK_P

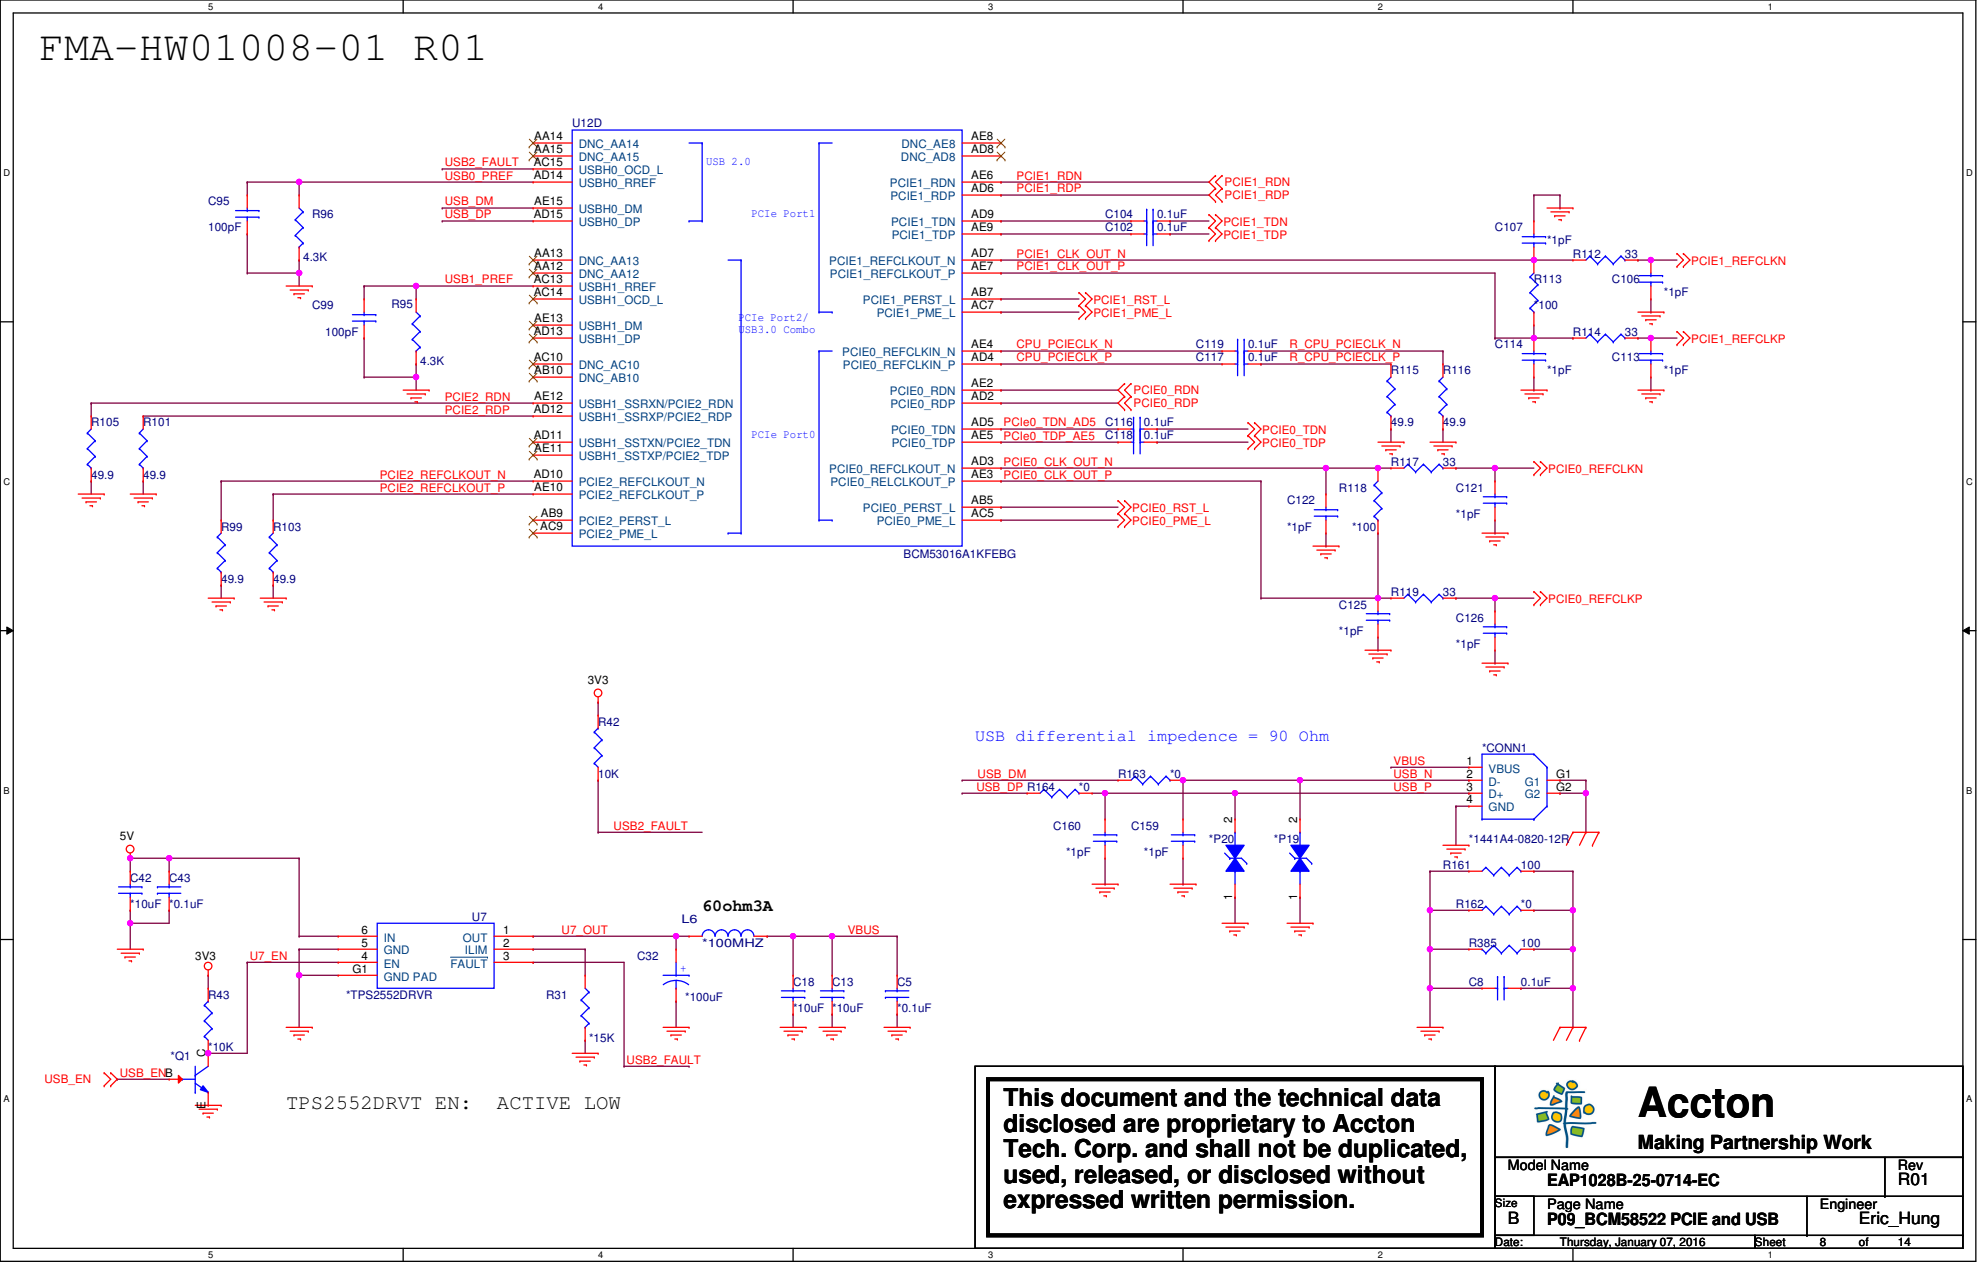
[picture p68: page 8]

USB differential impedence = 90 Ohm

Accton This document and the technical data disclosed are proprietary to Accton

Tech. Corp. and shall not be duplicated,
used, released, or disclosed without
expressed written permission.

# SPI NOR Flash 16MB= 128Mb

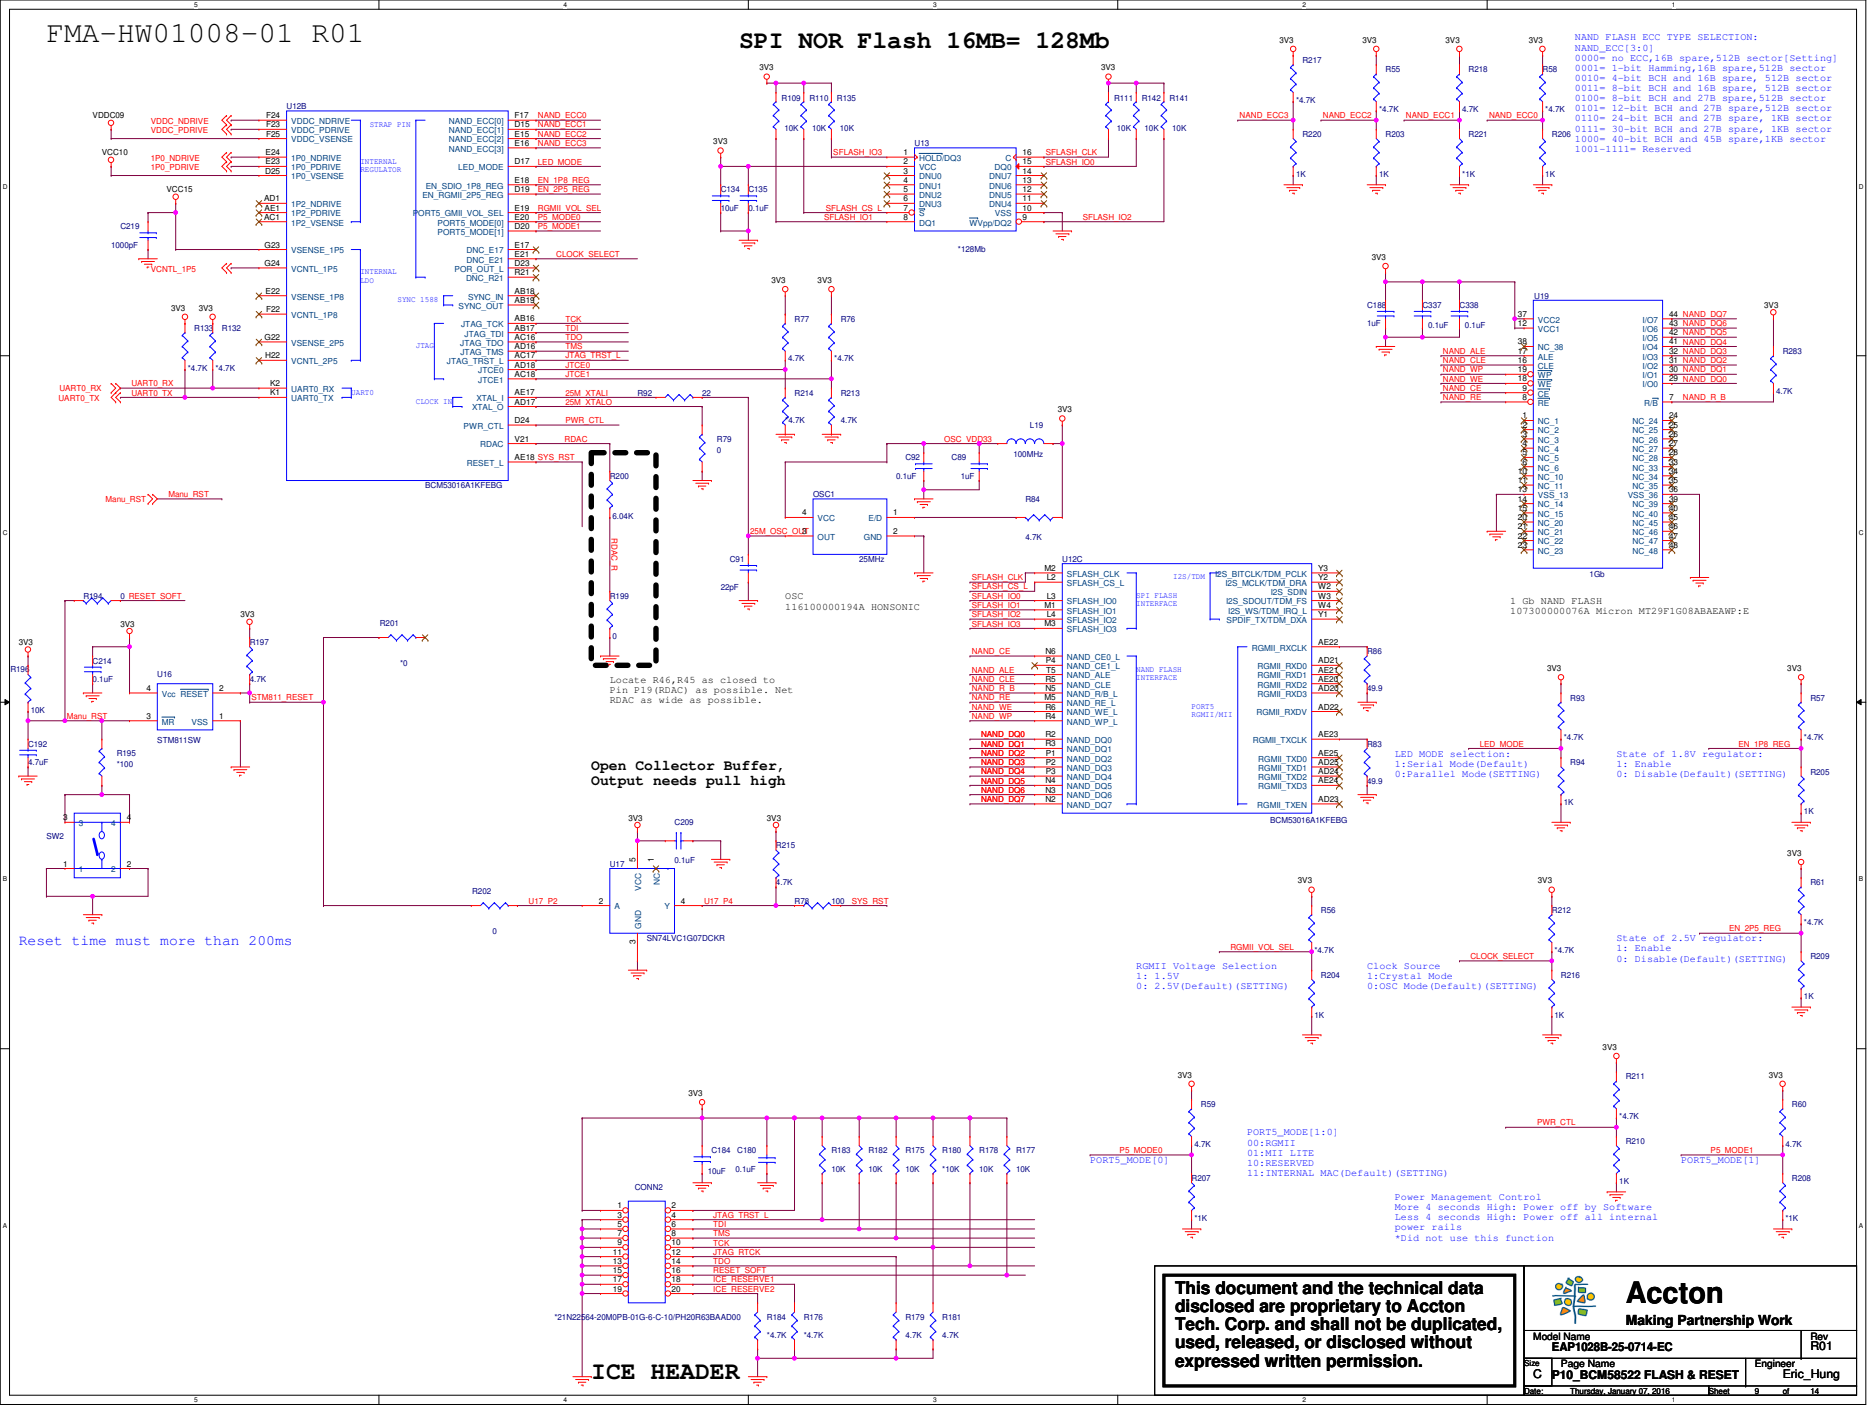
[picture p69: page 9]

NAND FLASH ECC TYPE SELECTION:
NAND_ECC[3:0]
0000= no ECC,16B spare,512B sector[Setting]
0001= 1-bit Hamming,16B spare,512B sector
0010= 4-bit BCH and 16B spare, 512B sector
0011= 8-bit BCH and 16B spare, 512B sector
0100= 8-bit BCH and 27B spare,512B sector
0101= 12-bit BCH and 27B spare,512B sector
0110= 24-bit BCH and 27B spare, 1KB sector
0111= 30-bit BCH and 27B spare, 1KB sector
1000= 40-bit BCH and 45B spare,1KB sector
1001-1111= Reserved

Locate R46,R45 as closed to
Pin P19(RDAC) as possible. Net
RDAC as wide as possible.

Open Collector Buffer,
Output needs pull high

Reset time must more than 200ms

0: Disable(Default)(SETTING) RGMII Voltage Selection

Clock Source
1:Crystal Mode
0:OSC Mode(Default)(SETTING)

Power Management Control
More 4 seconds High: Power off by Software
Less 4 seconds High: Power off all internal
power rails
*Did not use this function

Accton This document and the technical data disclosed are proprietary to Accton

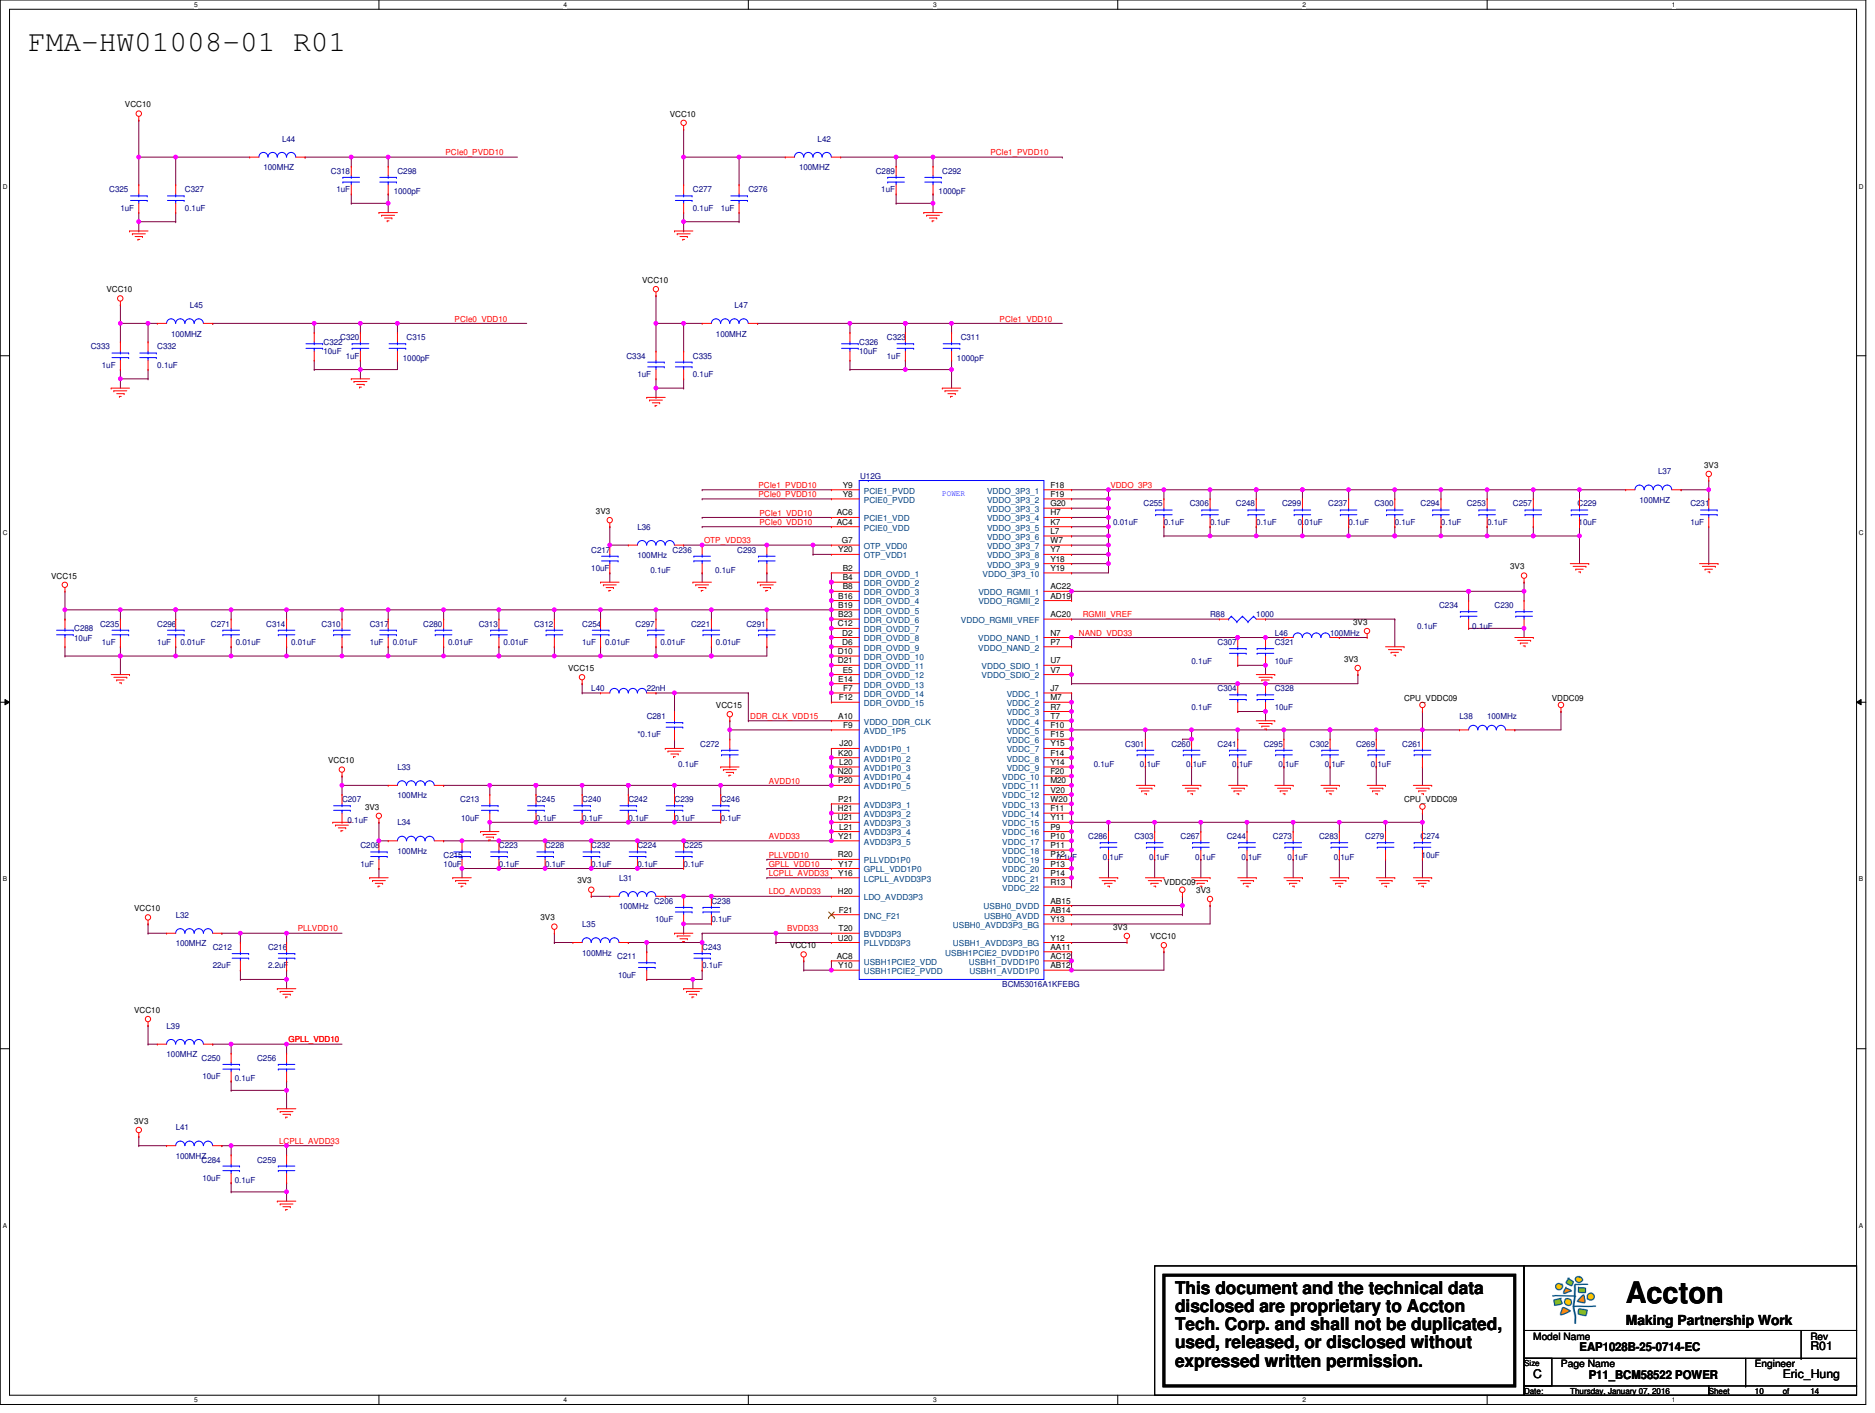
[picture p70: page 10]

Accton This document and the technical data disclosed are proprietary to Accton

SH5

SH1

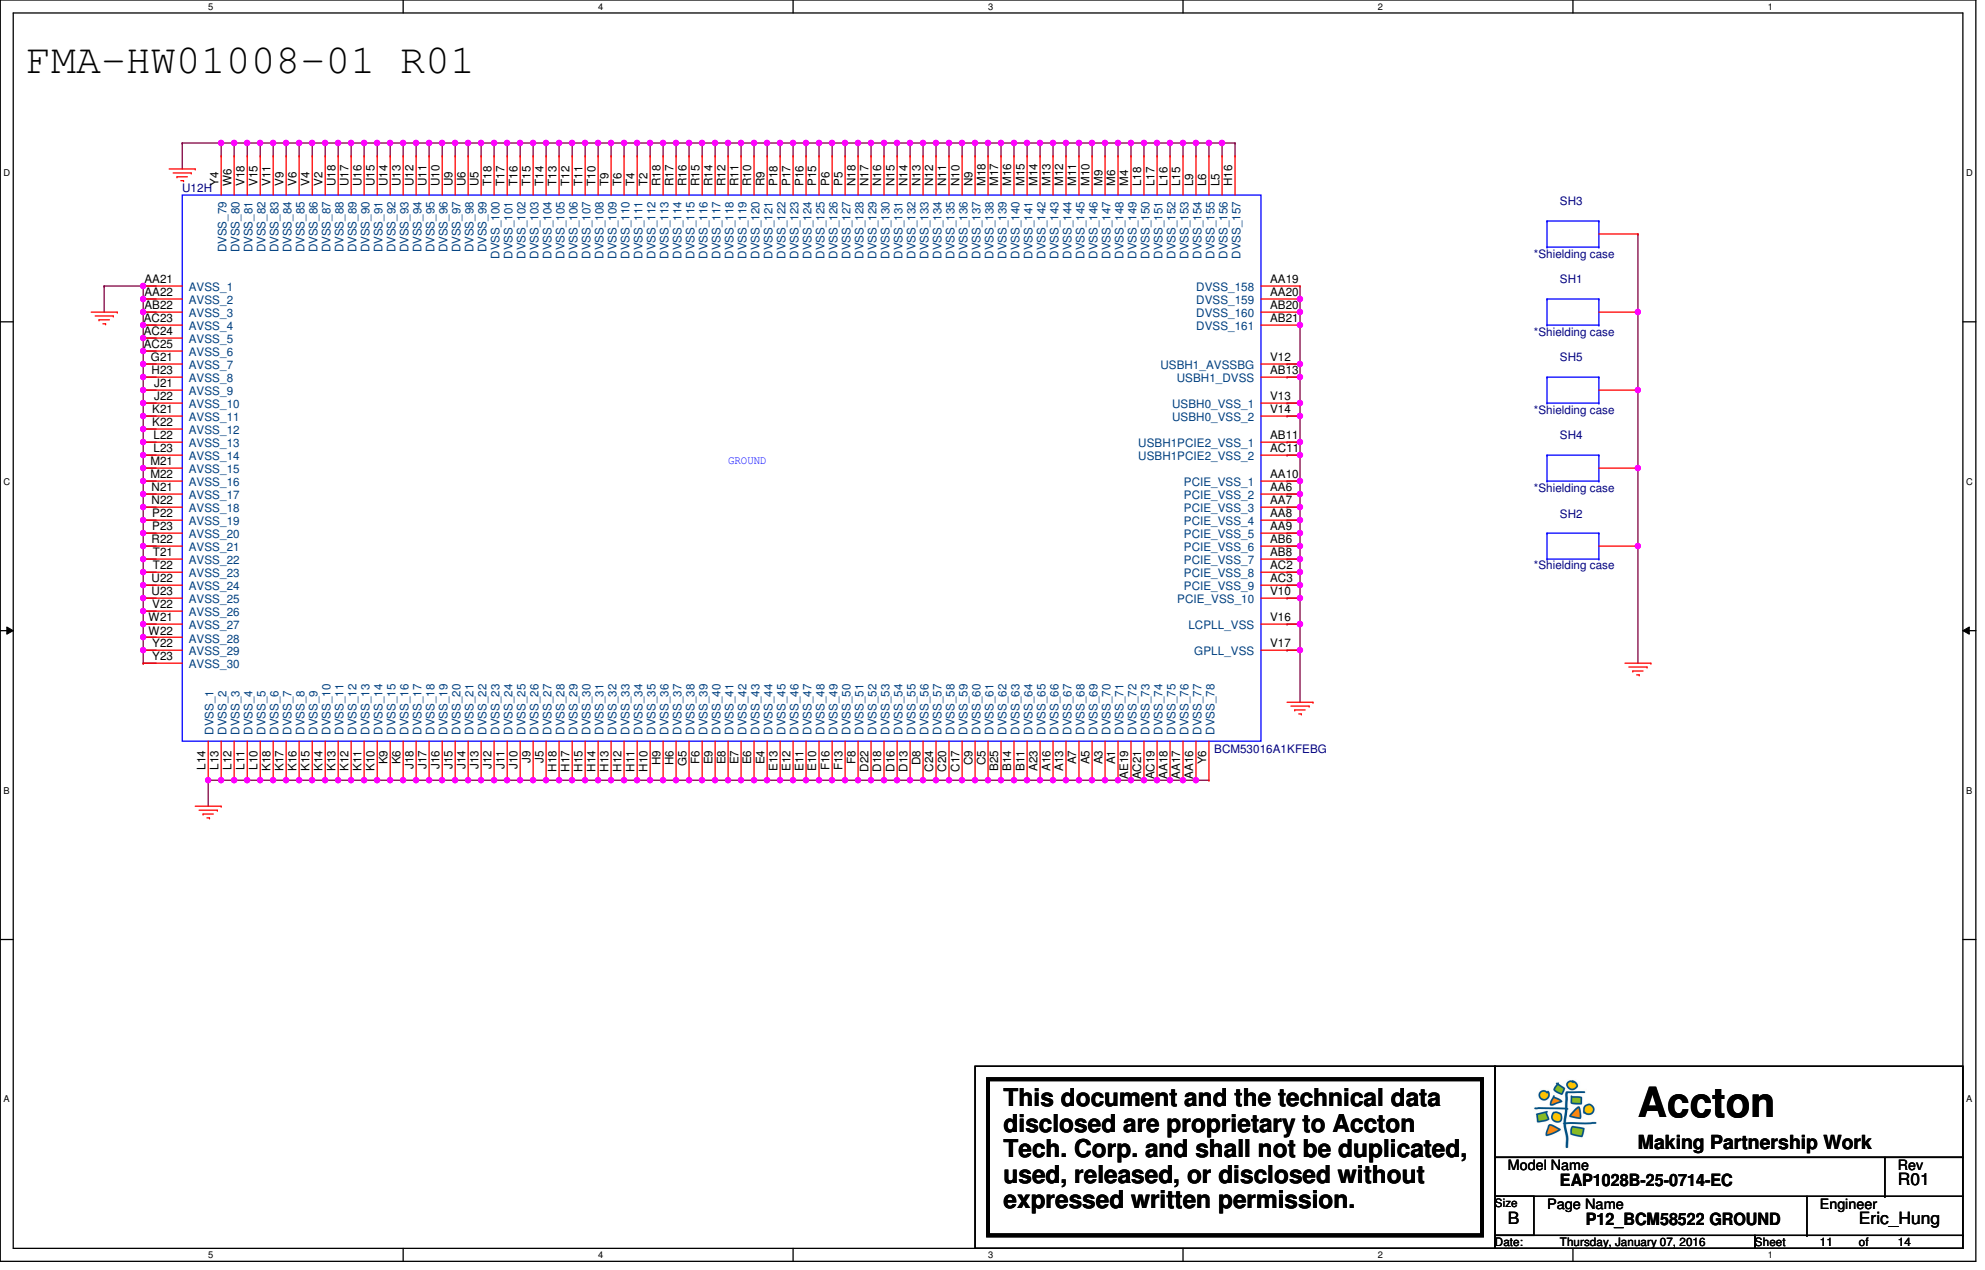
[picture p71: page 11]

Accton This document and the technical data disclosed are proprietary to Accton

Tech. Corp. and shall not be duplicated,
used, released, or disclosed without
expressed written permission.

### CONN7

### CONN7 Pin 39, 41

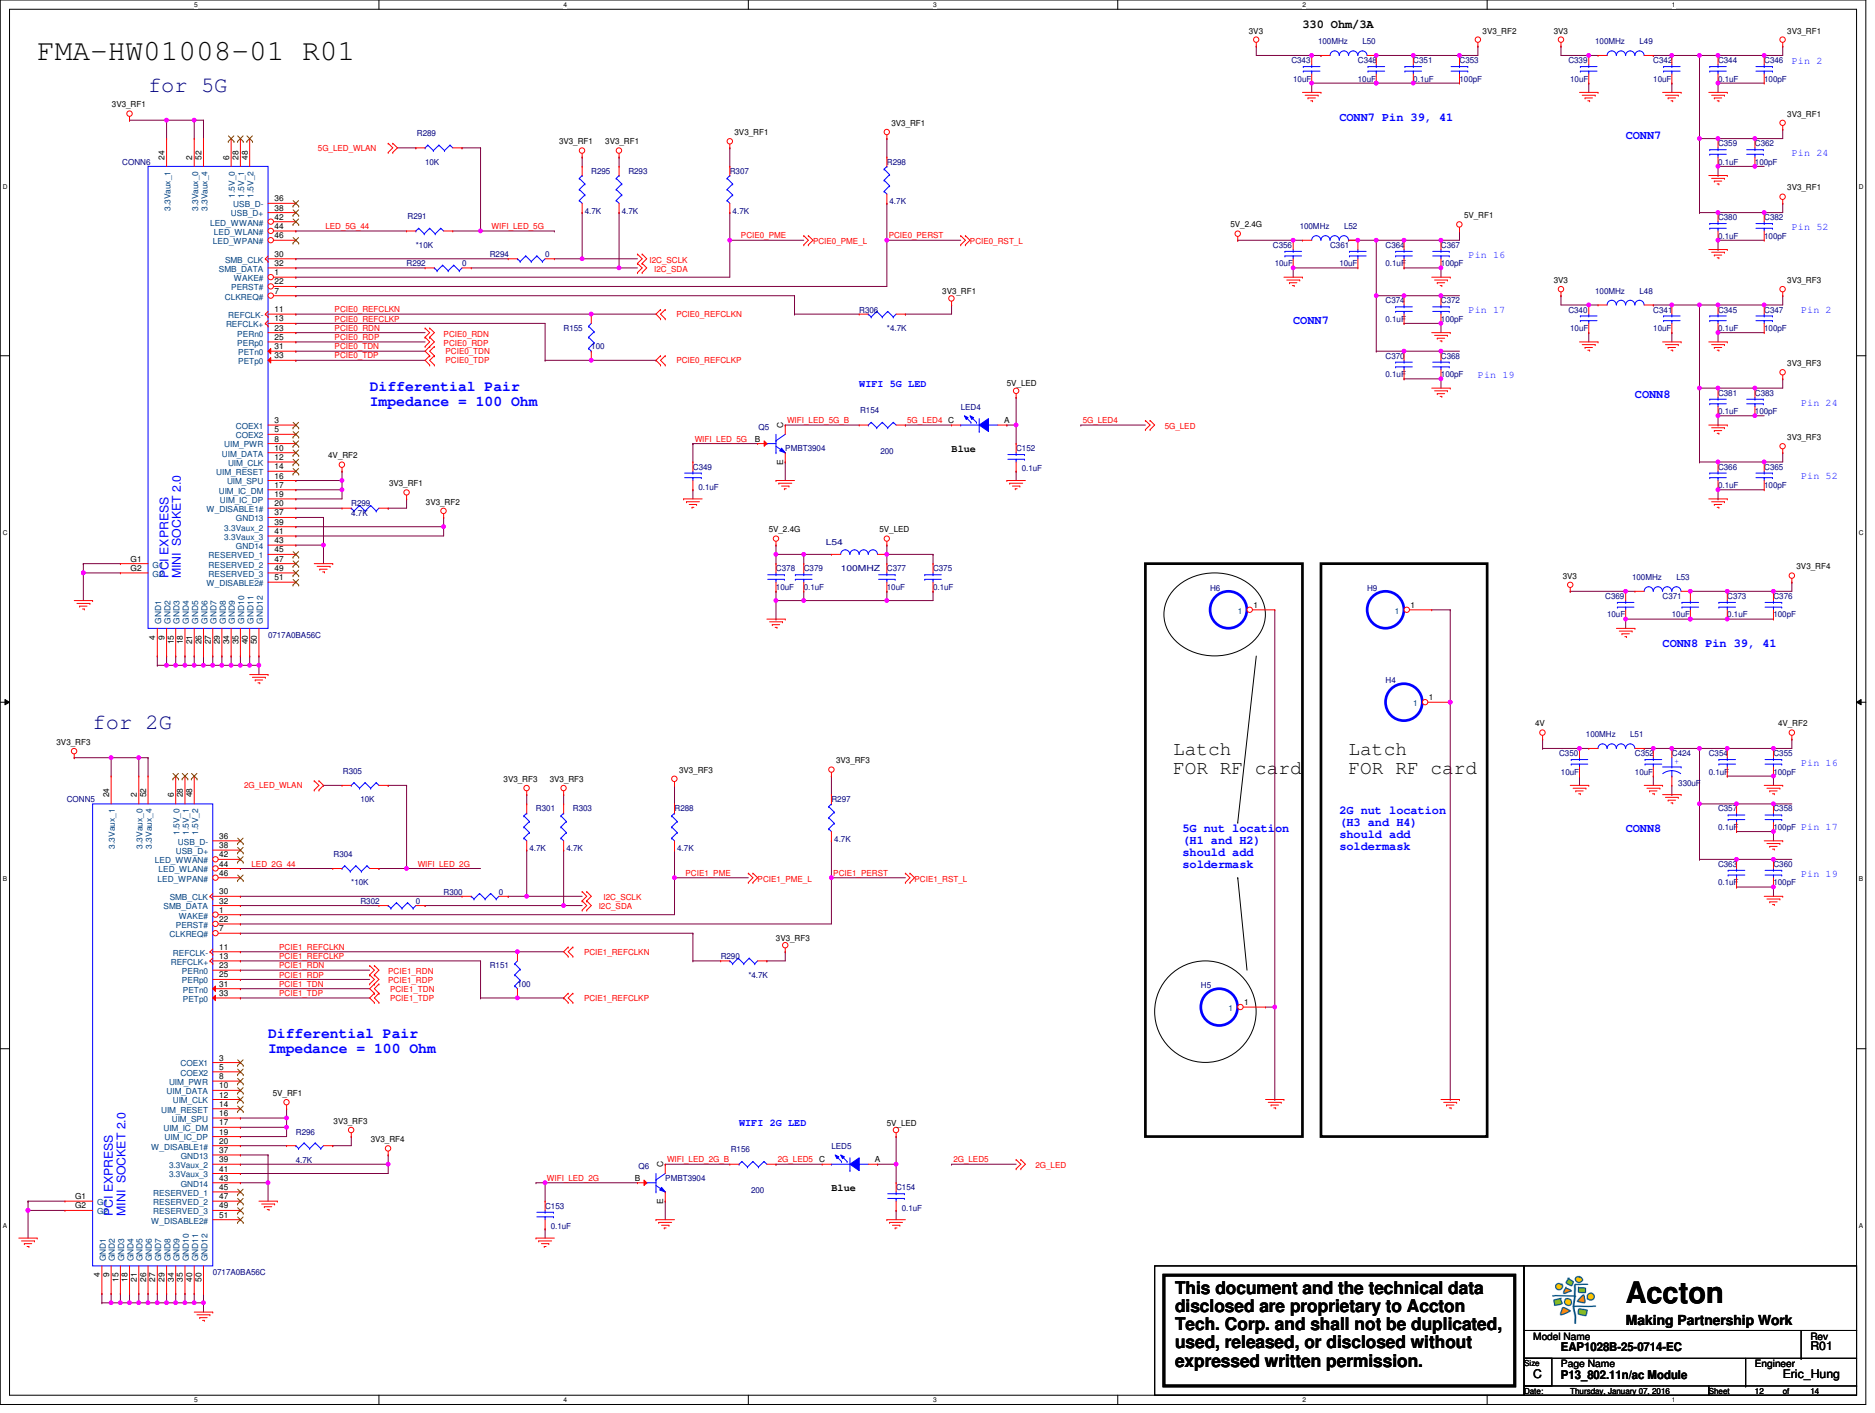
[picture p72: page 12]

Accton This document and the technical data disclosed are proprietary to Accton

1.0V@0.3A

## BCM53016 INTERNAL REG OF VCC1.0/VDDC0.9V

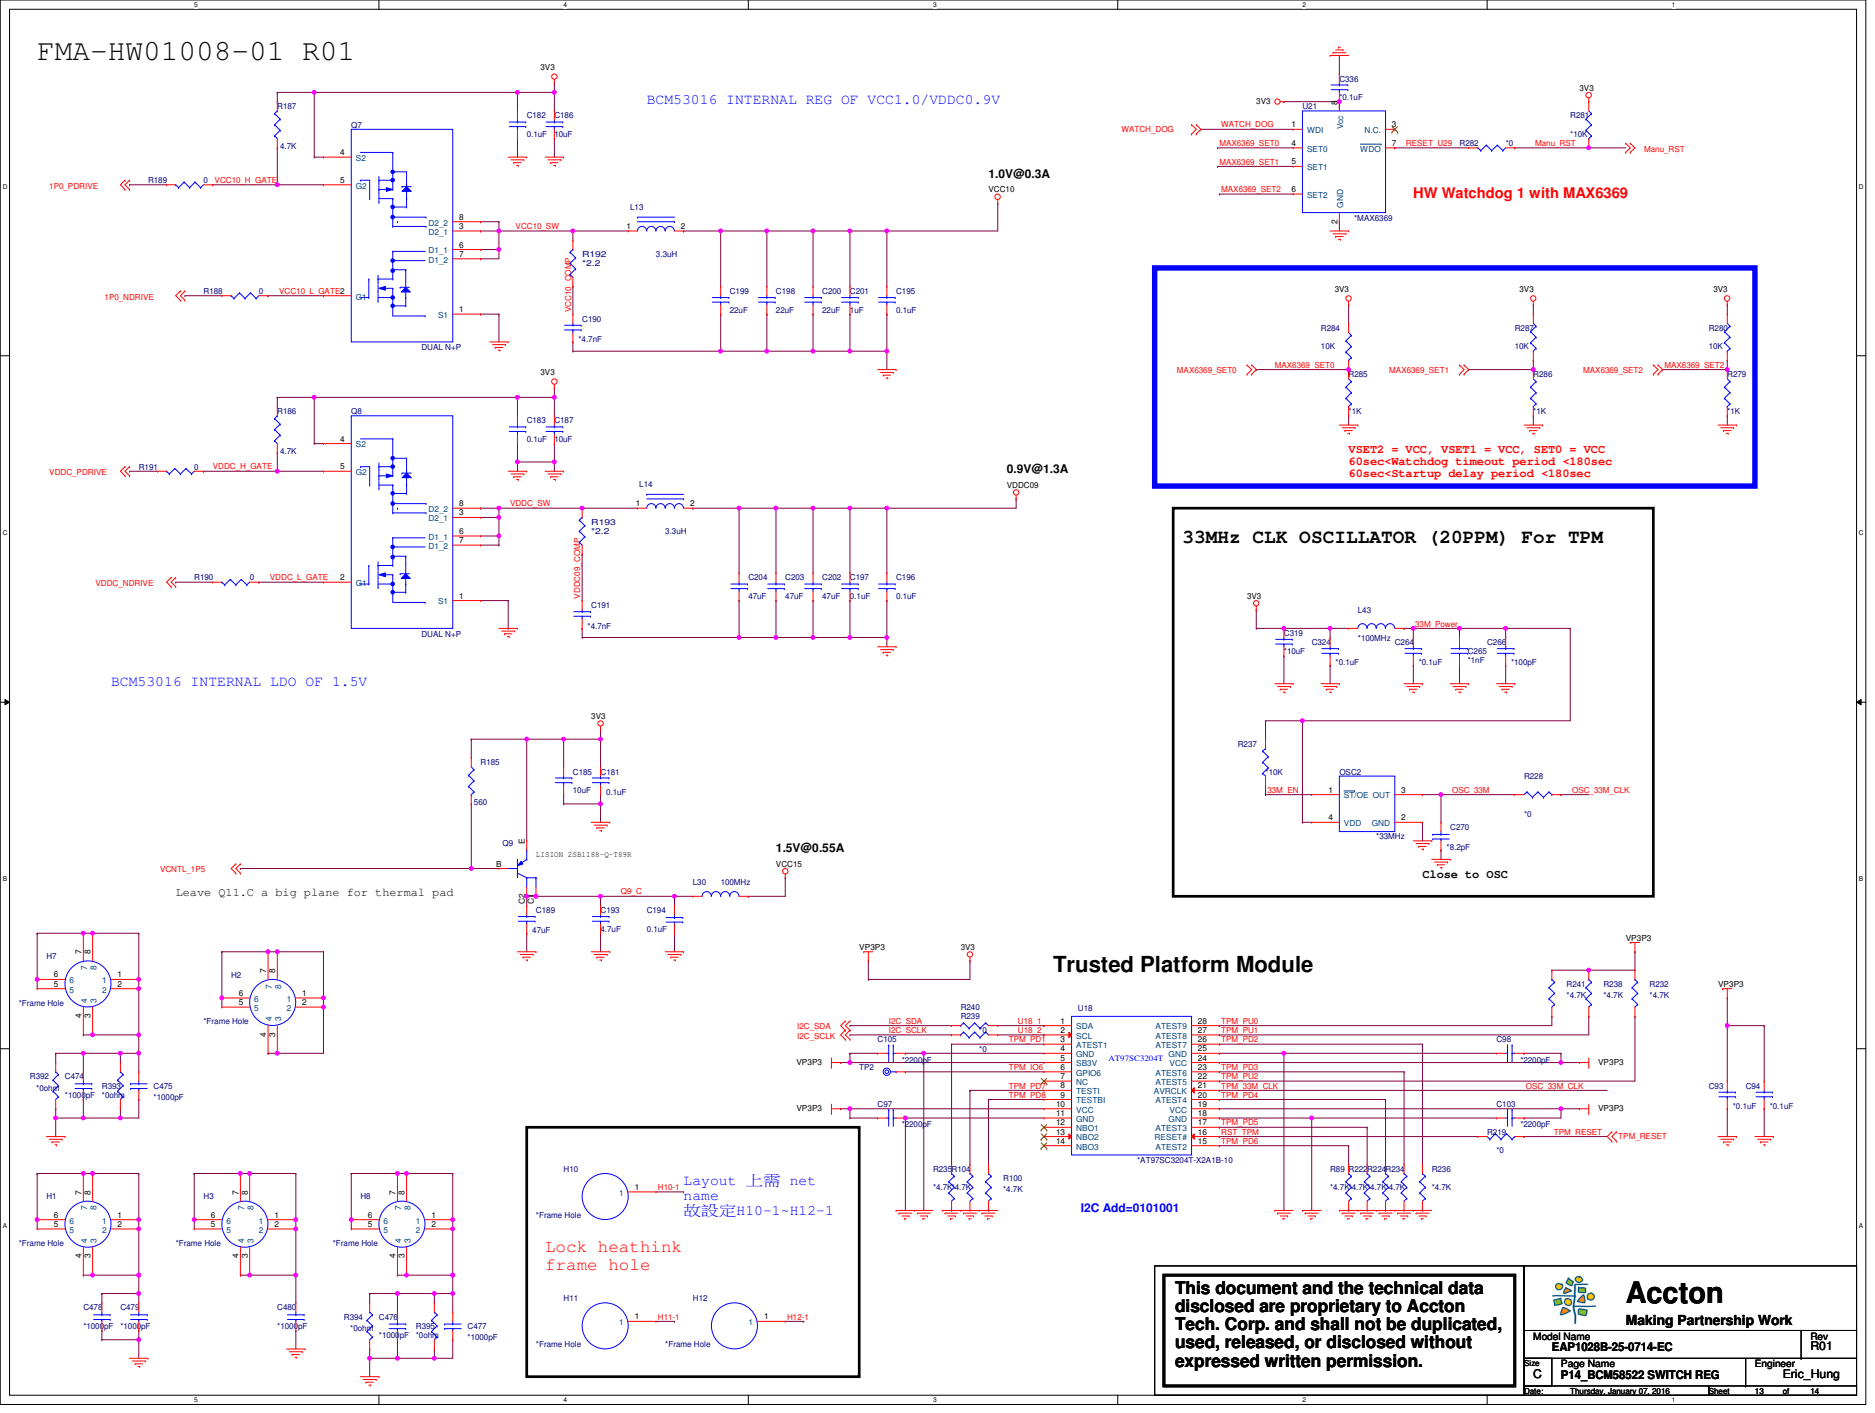
[picture p73: page 13]

33MHz CLK OSCILLATOR (20PPM) For TPM

Leave Q11.C a big plane for thermal pad

Accton This document and the technical data disclosed are proprietary to Accton

# Close CPU

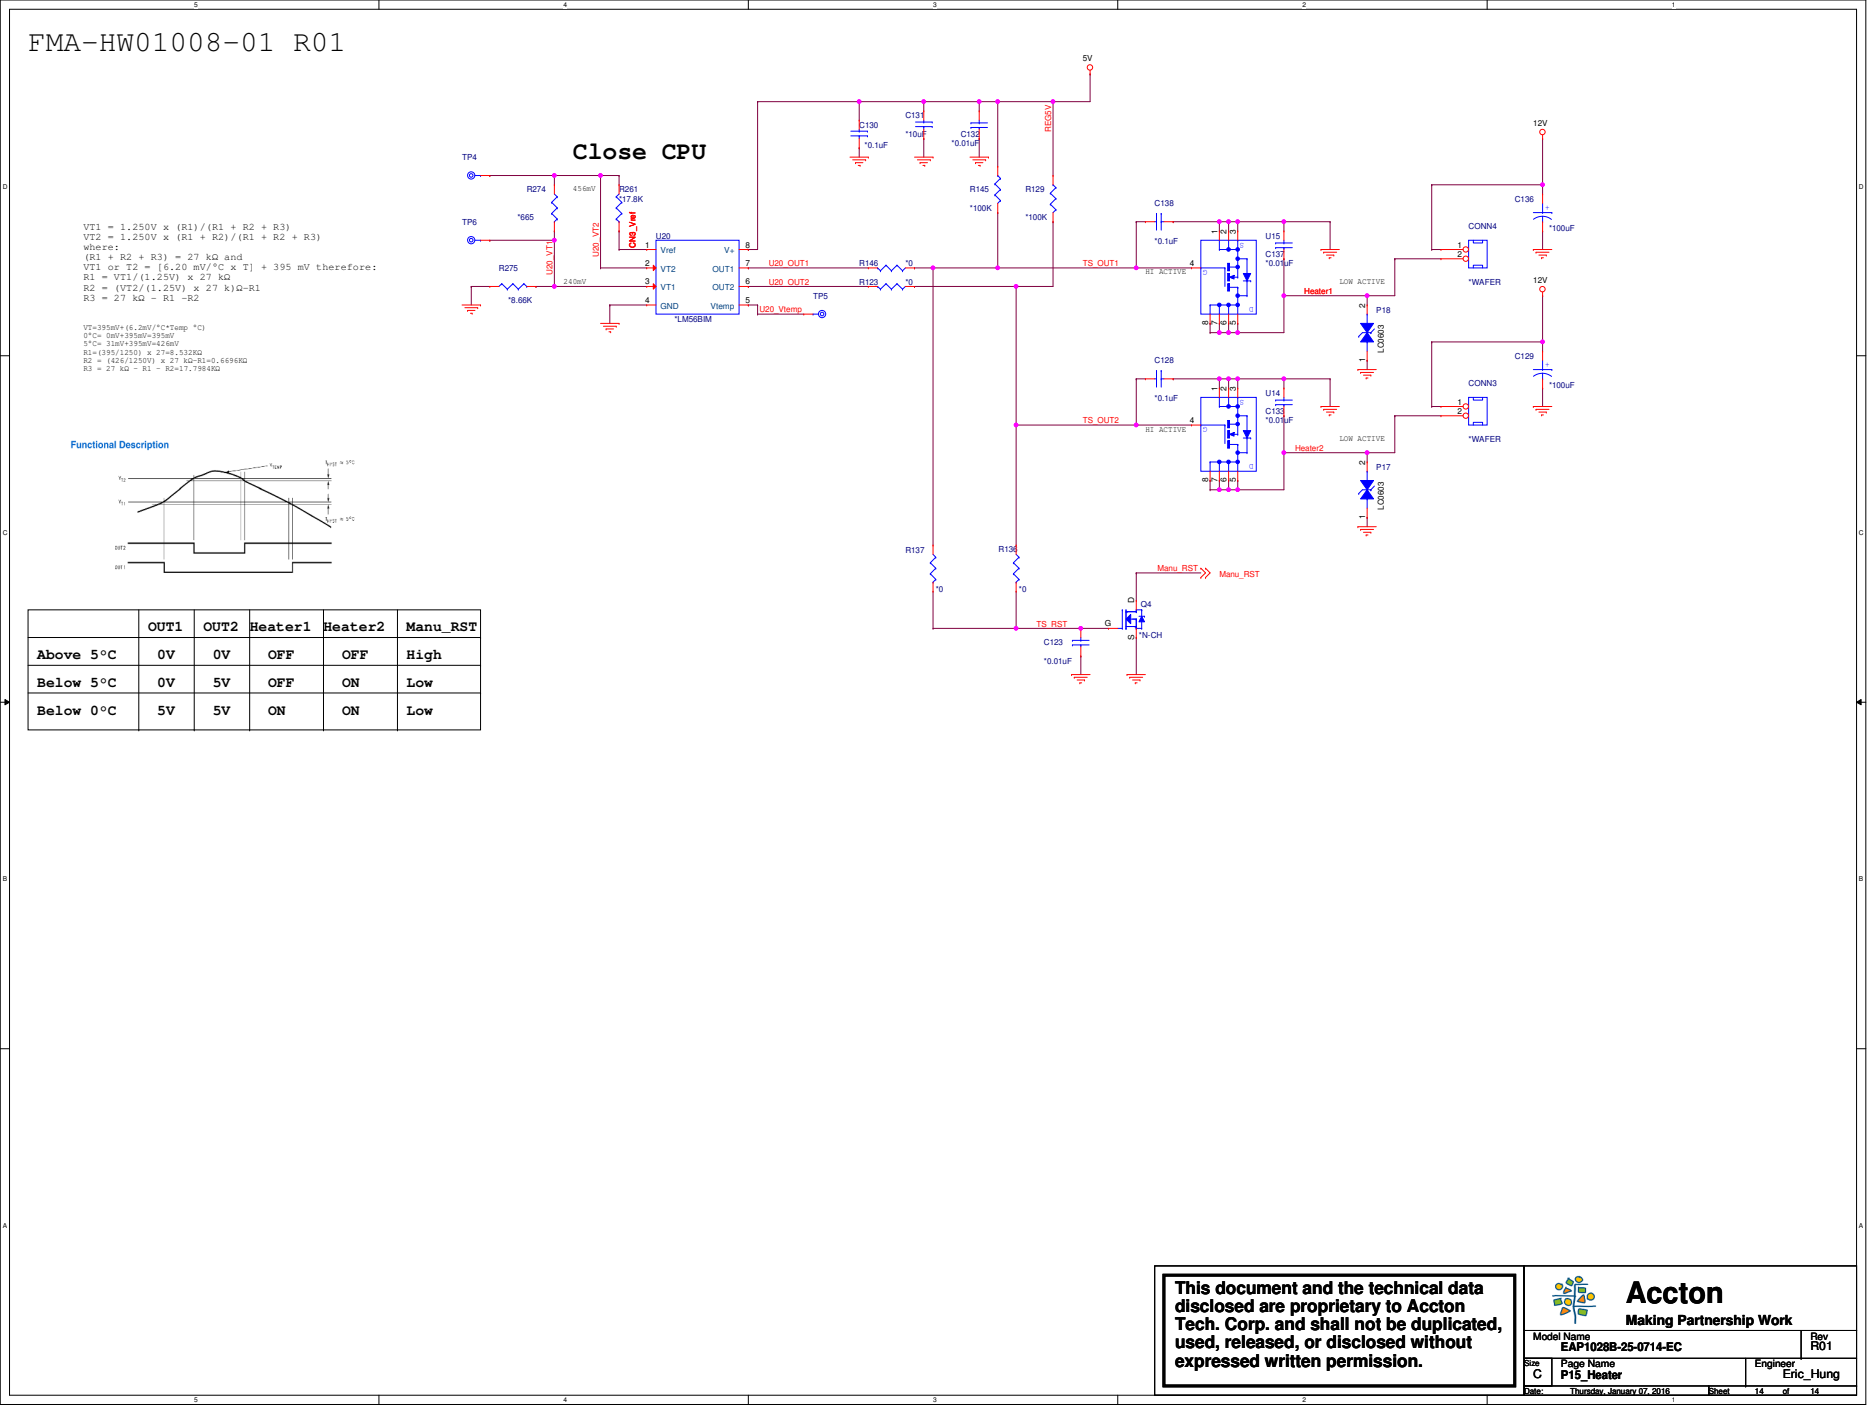
[picture p74: page 14]

Accton This document and the technical data disclosed are proprietary to Accton
